SamuelCicuitStudio/LAN9645-STM32-Managed-Ethernet-Switch/Design/README.md

# Design Documentation Index

Documentation is split into two folders:

- `Design/hardware`: hardware pin/strap/wiring documentation.
- `Design/firmware`: firmware architecture, bring-up flow, LwIP, CLI, and runtime behavior.

## Hardware docs
- `Design/hardware/LAN9645_128pin_LAN_pin_assignment.md`

## Firmware docs
- `Design/firmware/LAN9645_managed_control_library_spec.md`
- `Design/firmware/LAN9645_library_implementation_plan.md`
- `Design/firmware/LAN9645_user_phy_driver_spec.md`
- `Design/firmware/STM32_library_api_dependency_contract.md`
- `Design/firmware/LAN9645_stm32_firmware_direction_hal_lwip.md`
- `Design/firmware/LAN9645_stm32_physical_comm_cli_plan.md`
- `Design/firmware/LAN9645_switch_config_and_ping_bringup.md`
- `Design/firmware/STM32_generated_code_ping_bringup_checklist.md`
- `Design/firmware/STM32H743_LwIP_activation_and_PHY_driver_choice.md`
- `Design/firmware/STM32_LwIP_general_settings_phase1.md`
- `Design/firmware/STM32_runtime_io_cli_logic_spec.md`
