SamuelCicuitStudio/LAN9645-STM32-Managed-Ethernet-Switch/Design/hardware/README.md

# Hardware Documentation

This folder contains board-level hardware documentation for the LAN9645 switch design.

## Files
- `LAN9645_128pin_LAN_pin_assignment.md`: LAN9645 128-pin mapping, straps, LEDs, and hardware connection rules.
