SamuelCicuitStudio/LAN9645-STM32-Managed-Ethernet-Switch/Design/firmware/LAN9645_library_implementation_plan.md

# LAN9645 Library Implementation Plan (STM32H743 + USER_PHY + LwIP)

## Purpose
This document is the implementation planning reference for building the firmware library cleanly from the current generated project.

It is aligned with:
- `LAN9645_user_phy_driver_spec.md`
- `LAN9645_managed_control_library_spec.md`
- `STM32_library_api_dependency_contract.md`
- generated Cube files in `firmware/`

Locked targets for phase 1:
- managed LAN9645 control through SPI
- STM32 RMII MAC + LwIP ping bring-up
- copper advertisement only `10/100` (no 1000)
- deterministic CLI-visible fault handling

---

## 1) Final File Architecture to Implement

```mermaid
flowchart TD
    A[firmware/] --> LAN[lib_lan9645_core]
    A --> UPHY[lib_lan9645_user_phy_adapter]
    A --> DIAG[lib_diag_core]
    A --> ROUTER[lib_diag_router]
    A --> CLI[lib_cli_core]
    A --> UI[lib_ui_service]
    A --> TIME[lib_time_service]
    A --> APP[lib_app_orchestrator]
    A --> GLUE[LwIP/Cube glue files]

    GLUE --> G1[LWIP/Target/ethernetif.c]
    GLUE --> G2[LWIP/Target/eth_custom_phy_interface.c]
    GLUE --> G3[LWIP/App/lwip.c]
    GLUE --> G4[Core/Src/main.c]
    GLUE --> G5[Core/Src/stm32h7xx_hal_msp.c]
    GLUE --> G6[STM32H743BITX_FLASH.ld]
```

---

## 2) Phase Order (No Optional Path)

```mermaid
flowchart LR
    P0[Phase 0<br/>LAN docs + register map freeze] --> P1[Phase 1<br/>time service]
    P1 --> P2[Phase 2<br/>diag core]
    P2 --> P3[Phase 3<br/>diag router + serial adapters]
    P3 --> P4[Phase 4<br/>LAN transport + register layer]
    P4 --> P5[Phase 5<br/>LAN managed profile/core]
    P5 --> P6[Phase 6<br/>USER_PHY adapter mapping]
    P6 --> P7[Phase 7<br/>ethernetif/netif/linker/cache glue]
    P7 --> P8[Phase 8<br/>CLI + orchestrator + UI integration]
    P8 --> P9[Phase 9<br/>Ping matrix validation]
```

---

## 2.1) Current Implementation Snapshot (April 5, 2026)

Implemented in firmware:
- `Core/Inc/lan9645/lan9645_regs.h`
- `Core/Src/lan9645/lan9645_regs.c`
- `Core/Inc/lan9645/lan9645_reg.h`
- `Core/Src/lan9645/lan9645_reg.c`
- `Core/Inc/lan9645/lan9645_core.h`
- `Core/Src/lan9645/lan9645_core.c`
- `Core/Inc/lan9645/lan9645_target_map.h`
- `Core/Src/lan9645/lan9645_target_map.c`
- `Core/Inc/lan9645/lan9645_profile_managed_rmii1.h`
- `Core/Src/lan9645/lan9645_profile_managed_rmii1.c`
- `Core/Inc/lan9645/lan9645_user_phy_adapter.h`
- `Core/Src/lan9645/lan9645_user_phy_adapter.c`
- `Core/Inc/lan9645/lan9645_runtime.h`
- `Core/Src/lan9645/lan9645_runtime.c`
- `Core/Inc/cli/cli_core.h`
- `Core/Src/cli/cli_core.c`
- `Core/Inc/cli/cli_ingress.h`
- `Core/Src/cli/cli_ingress.c`
- `Core/Inc/ui/ui_service.h`
- `Core/Src/ui/ui_service.c`
- `Core/Inc/app/app_orchestrator.h`
- `Core/Src/app/app_orchestrator.c`
- `Core/Src/main.c` integration for LAN boot path
- `LWIP/Target/ethernetif.c` USER_PHY + link-state integration baseline

What is now in place:
- descriptor-based LAN9645 register definitions and field masks from LAN9645x autogenerated tuples
- register access API that resolves descriptor tuples to runtime addresses
- boot path that applies target map, does reset, and applies managed profile baseline

Critical warning (must be respected):
- target base addresses in `lan9645_target_map.c` are currently provisional and must be validated on real hardware before trusting register transactions for production behavior

Hard gate before production sign-off:
- do not treat LAN bring-up as final until target base validation is completed and documented

---

## 2.2) Continue Decision (Locked)

Yes, implementation continues now.

Why this is valid:
- SPI transport, register layer, target-map apply path, core reset path, and managed profile apply path are already implemented in firmware.
- startup path in `Core/Src/main.c` already initializes these modules and reports failures through diagnostics.

Current constraint:
- target base values in `lan9645_target_map.c` are still provisional.
- this is a validation gate for production trust, not a blocker for continuing software implementation.

Execution rule:
- continue coding with the current register model.
- keep all new LAN logic behind explicit error reporting so target-map mistakes are visible immediately during board tests.

---

## 2.3) Current Phase Status Board (April 5, 2026)

| Phase | Status | Evidence in repo | Gate to close |
|---|---|---|---|
| Phase 0 docs + register map | In progress | `lan9645_regs.*`, `lan9645_target_map.*`, reference docs added in `Design/ref/` | hardware validation of target-base mapping |
| Phase 1 time service | Completed | `Core/Inc/time/time_service.h`, `Core/Src/time/time_service.c` | none |
| Phase 2 diag core | Completed | `Core/Inc/diag/diag_core.h`, `Core/Src/diag/diag_core.c` | none |
| Phase 3 diag router | Completed (baseline) | `Core/Inc/diag/diag_router.h`, `Core/Src/diag/diag_router.c` | USB/UART owner policy verification on board |
| Phase 4 LAN transport + reg | Completed (baseline) | `lan9645_spi.*`, `lan9645_reg.*` | SPI read/write sanity on real board |
| Phase 5 managed profile/core | Completed (baseline) | `lan9645_core.*`, `lan9645_profile_managed_rmii1.*`, `main.c` startup integration; managed profile now enables `ANA_ANAINTR.INTR_ENA` and `CPU_DEV_INTR_ENA` mask for IRQ cause visibility | confirm profile writes on hardware |
| Phase 6 USER_PHY adapter | Completed (baseline) | `lan9645_user_phy_adapter.*` created with virtual Clause-22 register model, per-port context, and 10/100 policy | validate link behavior on board |
| Phase 7 netif/linker/cache glue | Completed (software closure) | `MX_LWIP_Process()` loop active; `ethernet_link_check_state()` uses USER_PHY + adapter path and sets ETH MAC speed/duplex/start-stop; `ethernetif_preflight()` gate is active; `HAL_ETH_MspInit/DeInit()` added with RMII pinmux + ETH clocks; linker script now places `.RxDescripSection`, `.TxDescripSection`, `.Rx_PoolSection` in `RAM_D2`; MPU now marks `0x30000000..0x3003FFFF` non-cacheable for ETH DMA coherence | run DMA/cache stress on real board |
| Phase 8 CLI/runtime contract | Completed (software closure) | `cli_core` + `cli_ingress` + `ui_service` + `app_orchestrator` integrated; USB CDC and UART4 feed CLI and ownership is source-bound; startup transitions are explicit (`BOOT` to `RUN`); IRQ monitor + acknowledge + event escalation path active; `serial show`, `eth show`, `net show`, `net check`, `bringup check` operational; `main.c` now computes effective SPI clock from RCC + SPI prescaler (fallback guarded) before `lan9645_core_spi_setup()` | confirm command behavior on board |
| Phase 9 ping matrix | Deferred hardware execution | software progression assumes expected pass path; no board-side packet validation performed yet | execute copper/SFP ping matrix on hardware and capture evidence |

---

## 2.3.1) Refactor Progress Note (April 5, 2026, SPI Alignment Pass)

Completed in code:
- `lan9645_spi.*` aligned to Linux MFD strategy:
  - default/max padding set to `15`
  - SPI padding formula helper added (`ceil((kHz*2 + 1500) / 8000)`)
  - read path changed to one full SPI transfer (addr + padding + value)
- `lan9645_target_map.*` base addresses aligned to Linux BSP resource map for active targets:
  - `gcb=0x4000`, `qs=0x8000`, `chip_top=0x10000`, `rew=0x18000`, `sys=0x2C000`, `hsio=0x30000`
  - `dev0..dev8=0x38000 + n*0x4000`, `qsys=0x100000`, `afi=0x120000`, `ana=0x140000`
- `lan9645_core.*` now includes mandatory SPI setup and reset sequencing:
  - `lan9645_core_spi_setup()` programs `IF_CTRL` and `IF_CFGSTAT`, then readback-verifies
  - `lan9645_core_soft_reset()` uses `GCB SOFT_RST` flow and re-applies SPI setup after reset
- `main.c` startup now calls `lan9645_core_spi_setup()` immediately after external reset and before profile apply.

Validation completed in workspace:
- syntax checks passed for all files in `Core/Src/lan9645/*.c`
- syntax check passed for `Core/Src/main.c`

Remaining gate (not optional):
- on-board validation is still required to confirm:
  - measured SPI clock and computed padding are stable for this board/SPI routing
  - computed padding is stable on real hardware
  - IF readback/reset flow is stable across cold boots

---

## 2.3.3) BSP Closure Pass (April 5, 2026, No-Board Continuation)

Completed in code:
- ETH MSP implemented in `Core/Src/stm32h7xx_hal_msp.c`:
  - `HAL_ETH_MspInit()` and `HAL_ETH_MspDeInit()` added
  - RMII pins configured (`PA1/PA2/PA7`, `PB11/PB12/PB13`, `PC1/PC4/PC5`)
  - ETH clocks enabled/disabled (`ETH1MAC`, `ETH1TX`, `ETH1RX`)
- ETH DMA section placement implemented in `STM32H743BITX_FLASH.ld`:
  - `.RxDescripSection`, `.TxDescripSection`, `.Rx_PoolSection` mapped to `RAM_D2` and 32-byte aligned
- Cache coherency hardening in `Core/Src/main.c`:
  - MPU region added for `RAM_D2` window `0x30000000` size `256KB` as non-cacheable/shareable
- SPI setup robustness in `Core/Src/main.c`:
  - SPI clock now derived from `HAL_RCCEx_GetPeriphCLKFreq(RCC_PERIPHCLK_SPI1)` and SPI prescaler
  - fallback kept to `24 MHz` if runtime derivation is unavailable

Validation completed in workspace:
- syntax check passed:
  - `Core/Src/main.c`
  - `Core/Src/stm32h7xx_hal_msp.c`

Locked policy while board is unavailable:
- ping matrix is treated as software-flow success for implementation continuity only.
- hardware status remains `not performed` until physical tests are run and logged.

---

## 2.3.2) CLI Scope Policy (Locked)

Yes. The current CLI is intentionally a bring-up baseline only.

What is locked for now (baseline CLI):
- `status all`
- `status errors`
- `bringup check`
- `diag clear`
- `link show`
- `phy show`
- `lan id`
- `lan check`
- `lan profile apply`
- `lan preflight`
- `port show` / `port admin` / `port mode`
- `vlan set` / `vlan show`
- `cnt read` / `cnt clear`
- `feat list` / `feat enable` / `feat apply`
- `feat summary` / `feat show <name>`
- `eee show` / `eee set`
- `fp show` / `fp set`
- `fp verify show` / `fp verify set`
- `fp frag show` / `fp frag set`
- `dcb show` / `dcb trust` / `dcb default` / `dcb pfc`
- `mac show` / `mac set`
- `mirror show` / `mirror set`
- `mirror src show` / `mirror src set`
- `bum flood show` / `bum flood set`
- `bum ipmc show` / `bum ipmc set`
- `bum pgid show` / `bum pgid set`
- `mqprio show` / `mqprio mode`
- `mqprio weight`
- `ets show` / `ets mode`
- `ets weight`
- `qos show` / `qos trust` / `qos default`
- `qos dscp show` / `qos dscp set`
- `qos pcpdei show` / `qos pcpdei set`
- `qos rew show` / `qos rew set`
- `qos tagmode show` / `qos tagmode set`
- `qos rewport show` / `qos rewport set`
- `eth show`
- `net show`
- `net check`
- `serial show`
- `spi status`
- `spi stats` / `spi stats clear`
- `reg read` / `reg write`
- `sanity spi`

What is deferred on purpose:
- advanced QoS/TSN controls beyond scheduler + trust/default + DSCP-map + PCP/DEI-map + REW-tag mode/policy + REW-port policy runtime controls
- advanced filtering/VCAP controls
- FRER/HSR/PRP/MRP runtime controls
- advanced per-feature error counters and deep diagnostics

Expansion rule (no ambiguity):
- CLI commands and error-report channels are expanded only when the matching BSP feature phase is implemented and validated.
- No advanced command is exposed before its underlying register path and diagnostics are stable.

---

## 2.4) Next Implementation Block (No Optional Path, Board Absent)

Locked execution policy:
- continue software implementation as if ping workflow succeeds.
- keep physical test status as `not performed` until board execution is available.

Start immediately with this exact order:

1. Keep BSP software closure aligned with generated project:
- preserve ETH MSP + linker + MPU settings on each Cube regeneration
- preserve USER sections for LAN/CLI/diag integration

2. Continue advanced software-side BSP build-out:
- expand register coverage and APIs only from verified docs/source map
- keep deterministic diagnostics for every new control path

3. Freeze hardware validation backlog for return-to-board session:
- command-path board checks
- LAN/SPI stability checks
- full ping matrix for copper + SFP/SerDes
- target-base map validation log

Done when this block is complete:
- software implementation can continue without hardware blockers
- every deferred physical test is explicitly listed and traceable

---

## 2.6) Locked Goal and Feature Add Plan (Precise, No Optional Path)

Primary goal until board return:
- complete a deterministic **managed-switch BSP software closure** that includes full control of the required baseline features over SPI, with CLI and diagnostics coverage for each feature.
- all physical checks remain recorded as **not performed** until hardware execution.

Feature additions are locked to this exact sequence:

| ID | Feature to Add | How It Will Be Implemented | Files/APIs | Register Scope | Done Condition (Software) | Hardware Status |
|---|---|---|---|---|---|---|
| F1 | SPI transport telemetry and failure visibility | add transport counters (reads, writes, retries, failures, timeout class), expose reset/get APIs, route failures through diagnostics | `lan9645_spi.h/.c`, `cli_core.c`, `diag_core.*` | SPI transport layer only | `spi stats` and `status all` show deterministic counters and no silent error path remains | not performed |
| F2 | Port administrative and MAC mode control (ports 0,1,8) | add explicit set/get APIs for admin up/down, 10/100 speed, half/full duplex, MAC RX/TX enable, with readback verification | `lan9645_core.h/.c`, optional helper `lan9645_port_ctrl.h/.c`, `cli_core.c` | `QSYS_SW_PORT_MODE`, `DEV_CLOCK_CFG`, `DEV_MAC_MODE_CFG`, `DEV_MAC_ENA_CFG` | each CLI command writes + readback-verifies and errors are routed to diag | not performed |
| F3 | VLAN baseline management for managed mode | add minimal VLAN service for membership/untag policy used by CPU and copper ports; keep scope to required bring-up VLANs only | `lan9645_vlan.h/.c` (new), `cli_core.c` | `ANA_PGID`, `ANA_PGID_CFG`, `ANA_AGGR_CFG` | VLAN set/show commands are deterministic and validate masks on readback | not performed |
| F4 | Counter/statistics read-clear service | add API to select/read `SYS_CNT` views and trigger clear-shot flows; expose stable CLI surface for diagnostics | `lan9645_stats.h/.c` (new), `cli_core.c` | `SYS_STAT_CFG`, `SYS_CNT`, `SYS_SW_STATUS` | counters are readable, clear-shot behavior is explicit, and failure path is diagnosable | not performed |
| F5 | IRQ/cause contract completion | keep existing IRQ monitor, add explicit cause-to-action mapping per event class, and unify acknowledgement/reporting paths | `main.c`, `lan9645_core.c`, `cli_core.c`, `diag_core.*` | `ANA_ANAINTR`, `ANA_ANEVENTS`, `CPU_INTR_*`, `CPU_DEV_INTR_*` | repeated `irq show/ack` behavior is deterministic in software and every ack failure is visible | not performed |
| F6 | CLI contract completion for BSP baseline | finalize command set for F1..F5 with strict syntax and stable response format for logging/automation | `cli_core.c`, `cli_ingress.c`, `diag_router.c` | n/a (command surface) | help/output format frozen and command errors map to explicit codes | not performed |
| F7 | Documentation and traceability closure | for every F1..F6 feature, update plan evidence section and keep board-test rows explicitly marked pending | `LAN9645_library_implementation_plan.md` | n/a | plan reflects exact implemented feature set and pending physical backlog | not performed |

Locked command additions that must exist after F6:
- `spi stats`
- `port admin <0|1|8> <up|down>`
- `port mode <0|1|8> <10|100> <half|full>`
- `vlan set <vid> <member_mask_hex> <untag_mask_hex>`
- `vlan show <vid>`
- `cnt read <view>`
- `cnt clear <view>`

Rules for this locked feature pass:
- every setter command must do readback verification.
- every failure must emit a diagnostics event and a CLI-visible error line.
- no advanced TSN/VCAP/FRER/PTP controls are added in this pass.
- physical validation rows remain `not performed` until board return.

## 2.6.1) F1 Progress Snapshot (April 5, 2026)

F1 objective:
- SPI transport telemetry and deterministic visibility of communication failures.

Implemented now in firmware:
- `Core/Inc/lan9645/lan9645_spi.h`
  - added `lan9645_spi_stats_t` counter model:
    - `read_count`
    - `write_count`
    - `retry_count`
    - `failure_count`
    - `timeout_count`
    - `invalid_arg_count`
    - `last_status`
    - `last_reg_addr`
  - added APIs:
    - `lan9645_spi_reset_stats()`
    - `lan9645_spi_get_stats()`
- `Core/Src/lan9645/lan9645_spi.c`
  - SPI HAL errors now distinguish timeout (`APP_ETIMEOUT`) from generic I/O (`APP_EIO`)
  - counters updated on every read/write/retry/failure path
  - invalid argument/state paths update telemetry
  - last status/address tracking added for post-failure visibility
- `Core/Src/cli/cli_core.c`
  - added `spi stats`
  - added `spi stats clear`
  - fixed parser to handle:
    - `spi status`
    - `spi stats`
    - `spi stats clear`

F1 software status:
- **Software complete**

F1 closure evidence:
1. `status all` now includes SPI telemetry output (`cli_cmd_spi_stats()`).
2. SPI read/write transport failures now emit diagnostics events from the register layer:
   - `DIAG_EVT_LAN_SPI_TIMEOUT` for timeout class failures
   - `DIAG_EVT_LAN_SPI_IFSTAT` for non-timeout transport failures
3. SPI failure events are both:
   - recorded in diagnostics core counters
   - forwarded as serial event lines through diagnostics router

Hardware validation status:
- `not performed` (board unavailable).

## 2.6.2) F2 Progress Snapshot (April 5, 2026)

F2 objective:
- deterministic administrative and MAC mode control for ports `0`, `1`, and `8` with readback verification and diagnostics reporting.

Implemented now in firmware:
- `Core/Inc/lan9645/lan9645_core.h`
  - added explicit F2 APIs:
    - `lan9645_core_set_port_admin()`
    - `lan9645_core_set_port_mode()`
    - `lan9645_core_get_port_cfg()`
  - added `lan9645_core_port_cfg_t` state snapshot model
  - locked user-facing speed constants:
    - `LAN9645_CORE_PORT_SPEED_10_MBPS`
    - `LAN9645_CORE_PORT_SPEED_100_MBPS`
- `Core/Src/lan9645/lan9645_core.c`
  - implemented port admin write + readback verify on `QSYS_SW_PORT_MODE.PORT_ENA`
  - implemented port mode write + readback verify on:
    - `DEV_CLOCK_CFG.LINK_SPEED` with reset bits forced deasserted
    - `DEV_MAC_MODE_CFG.GIGA_MODE_ENA=0` and duplex control
    - `DEV_MAC_ENA_CFG.RX_ENA/TX_ENA=1`
  - added deterministic diagnostics emission for port-config failures (`DIAG_EVT_LAN_PORT_CFG_FAIL`)
- `Core/Src/cli/cli_core.c`
  - added CLI commands:
    - `port admin <0|1|8> <up|down>`
    - `port mode <0|1|8> <10|100> <half|full>`
    - `port show [0|1|8]` now prints decoded admin/speed/duplex/RX/TX state
- diagnostics label support updated:
  - `Core/Inc/diag/diag_core.h`
  - `Core/Src/diag/diag_router.c`
  - `Core/Src/cli/cli_core.c`

F2 software status:
- **Software complete**

Hardware validation status:
- `not performed` (board unavailable).

## 2.6.3) F3 Progress Snapshot (April 5, 2026)

F3 objective:
- baseline VLAN control for managed mode with deterministic write/readback and CLI visibility.

Implemented now in firmware:
- `Core/Inc/lan9645/lan9645_regs.h`
  - added VLAN-related field masks aligned with local Linux LAN9645x register definitions:
    - `ANA_PGID.PGID`
    - `ANA_PGID_CFG.SAN_ENA/CPUQ_DST_PGID/OBEY_VLAN`
    - `ANA_AGGR_CFG` aggregation selector bits
- `Core/Inc/lan9645/lan9645_vlan.h` (new)
  - added baseline VLAN API:
    - `lan9645_vlan_init()`
    - `lan9645_vlan_set()`
    - `lan9645_vlan_get()`
  - locked baseline scope:
    - `vid` range `0..89` (maps to `ANA_PGID(vid)`/`ANA_PGID_CFG(vid)`)
    - member-mask width `10` ports (`0x03FF`)
- `Core/Src/lan9645/lan9645_vlan.c` (new)
  - implemented register writes + readback verification for:
    - `ANA_PGID(vid)` member mask
    - `ANA_PGID_CFG(vid)` with `OBEY_VLAN=1`
  - implemented managed baseline for `ANA_AGGR_CFG` (DMAC+SMAC hash bits enabled)
  - added deterministic diagnostics reporting on VLAN failures:
    - `DIAG_EVT_LAN_VLAN_CFG_FAIL`
- `Core/Src/cli/cli_core.c`
  - added commands:
    - `vlan set <vid> <member_mask_hex> <untag_mask_hex>`
    - `vlan show <vid>`
  - `untag_mask` is tracked in firmware state and reported by CLI for baseline policy tracing.
- diagnostics label support updated:
  - `Core/Inc/diag/diag_core.h`
  - `Core/Src/diag/diag_router.c`
  - `Core/Src/cli/cli_core.c`

F3 software status:
- **Software complete (baseline scope)**

Hardware validation status:
- `not performed` (board unavailable).

## 2.6.4) F4 Progress Snapshot (April 5, 2026)

F4 objective:
- deterministic counter/statistics read-clear service for bring-up diagnostics.

Implemented now in firmware:
- `Core/Inc/diag/diag_core.h`
  - added diagnostics event:
    - `DIAG_EVT_LAN_CNT_OP_FAIL`
- `Core/Src/diag/diag_router.c`
  - added event label mapping:
    - `DIAG_EVT_LAN_CNT_OP_FAIL`
- `Core/Src/cli/cli_core.c`
  - added CLI commands:
    - `cnt read <view>`
    - `cnt clear <view>`
  - added diagnostics label mapping:
    - `LAN_CNT_OP_FAIL`
- `Core/Inc/lan9645/lan9645_stats.h` (new)
  - added baseline stats API:
    - `lan9645_stats_init()`
    - `lan9645_stats_read()`
    - `lan9645_stats_clear()`
  - locked scope constants:
    - `LAN9645_STATS_VIEW_MAX = 1023`
    - `LAN9645_STATS_CLEAR_SEL_PORTS = 0x07`
- `Core/Src/lan9645/lan9645_stats.c` (new)
  - implemented `SYS_STAT_CFG` view programming and readback verification
  - implemented baseline counter reads from `SYS_CNT` offsets:
    - `0x000` (`rx_oct`)
    - `0x080` (`tx_oct`)
    - `0x100` (`dr_local`)
  - implemented clear-shot flow with selector `0x07` for baseline port counters
  - implemented `SYS_SW_STATUS(view).PORT_RX_PAUSED` sampling when `view < 10`
  - all operation failures emit deterministic diagnostics via:
    - `DIAG_EVT_LAN_CNT_OP_FAIL`

F4 software status:
- **Software complete (baseline scope)**

Hardware validation status:
- `not performed` (board unavailable).

## 2.6.5) F5 Progress Snapshot (April 5, 2026)

F5 objective:
- explicit IRQ cause-to-action mapping with unified acknowledgement/reporting behavior.

Implemented now in firmware:
- `Core/Inc/lan9645/lan9645_core.h`
  - added locked IRQ analysis model:
    - `lan9645_core_irq_analysis_t`
  - added severity codes:
    - `LAN9645_CORE_IRQ_SEV_INFO`
    - `LAN9645_CORE_IRQ_SEV_WARN`
    - `LAN9645_CORE_IRQ_SEV_ERR`
  - added canonical ANA event-class masks:
    - `LAN9645_CORE_ANA_EVT_ERR_MASK`
    - `LAN9645_CORE_ANA_EVT_WARN_MASK`
    - `LAN9645_CORE_ANA_EVT_DROP_MASK`
  - added action flags:
    - `LAN9645_CORE_IRQ_ACTION_REPORT_CAUSE`
    - `LAN9645_CORE_IRQ_ACTION_REPORT_DROP_ALERT`
    - `LAN9645_CORE_IRQ_ACTION_ACK_ANA_EVENTS`
    - `LAN9645_CORE_IRQ_ACTION_ESCALATE_ERROR_LED`
  - added APIs:
    - `lan9645_core_eval_irq_actions()`
    - `lan9645_core_ack_irq_checked()`
- `Core/Src/lan9645/lan9645_core.c`
  - implemented deterministic IRQ evaluation:
    - maps snapshots to severity/action recommendations
    - decodes pending device mask from `CPU_DEV_INTR_IDENT`
  - implemented checked acknowledge path:
    - W1C write to `ANA_ANEVENTS`
    - readback verification that acknowledged bits are cleared
- `Core/Src/main.c`
  - switched runtime IRQ logic to use `lan9645_core_eval_irq_actions()`
  - switched ACK path to `lan9645_core_ack_irq_checked()`
  - `DIAG_EVT_LAN_IRQ_ACK_FAIL` now carries remaining uncleared mask in `arg1`
  - reporting cadence kept deterministic with `LAN9645_IRQ_CAUSE_REPORT_INTERVAL_MS`
  - error-class IRQ causes now trigger the error LED path (`ui_service_set_error(1)`)
- `Core/Src/cli/cli_core.c`
  - `irq show` now prints decoded evaluation snapshot:
    - severity, cause-present flag, ack-required flag, action mask, decoded event groups
  - `irq ack` now uses checked ACK and reports remaining bits on failure

F5 software status:
- **Software complete (baseline scope)**

Hardware validation status:
- `not performed` (board unavailable).

## 2.6.6) F6 Progress Snapshot (April 5, 2026)

F6 objective:
- freeze the CLI contract for F1..F5 with strict syntax and deterministic response envelopes for automation.

Implemented now in firmware:
- `Core/Src/cli/cli_core.c`
  - added locked machine-readable result envelope emitted for every executed command:
    - `cli result=<ok|err> st=<int> code=<symbol> seq=<u32> schema=<u32>`
  - added stable status-code symbol mapping:
    - `APP_OK`, `APP_EINVAL`, `APP_EIO`, `APP_ETIMEOUT`, `APP_ENOTSUP`, `APP_ESTATE`
  - added contract discovery command:
    - `cli contract`
  - updated `help` output to include:
    - `cli contract`
  - extended feature-matrix CLI visibility with:
    - `feat summary`
    - `feat show <name>`
  - updated `bringup check` to enforce feature-matrix closure gate:
    - fails when `failed_count != 0` or `configured_count < enabled_count`
  - replaced legacy free-form error trailer with the fixed contract line so command failures now always map to explicit numeric + symbolic codes.

F6 software status:
- **Software complete (baseline scope)**

Hardware validation status:
- `not performed` (board unavailable).

## 2.6.7) F7 Progress Snapshot (April 5, 2026)

F7 objective:
- close documentation and traceability for F1..F6 and freeze the pending hardware backlog.

Implemented now in planning artifacts:
- `Design/firmware/LAN9645_library_implementation_plan.md`
  - F1..F6 software evidence is now locked in one place (sections 2.6.1 .. 2.6.6).
  - CLI contract is explicitly frozen with deterministic result envelope schema.
  - pending board work is explicitly listed and kept `not performed`.

F1..F6 traceability matrix (software closure):

| Feature | Primary firmware files | Locked CLI evidence | Locked diagnostics evidence | Software status | Hardware status |
|---|---|---|---|---|---|
| F1 SPI telemetry | `lan9645_spi.h/.c`, `cli_core.c` | `spi stats`, `spi stats clear`, `status all` | `DIAG_EVT_LAN_SPI_TIMEOUT`, `DIAG_EVT_LAN_SPI_IFSTAT` | complete | not performed |
| F2 Port control | `lan9645_core.h/.c`, `cli_core.c` | `port admin`, `port mode`, `port show` | `DIAG_EVT_LAN_PORT_CFG_FAIL` | complete | not performed |
| F3 VLAN baseline | `lan9645_vlan.h/.c`, `cli_core.c` | `vlan set`, `vlan show` | `DIAG_EVT_LAN_VLAN_CFG_FAIL` | complete | not performed |
| F4 Counters | `lan9645_stats.h/.c`, `cli_core.c` | `cnt read`, `cnt clear` | `DIAG_EVT_LAN_CNT_OP_FAIL` | complete | not performed |
| F5 IRQ contract | `lan9645_core.h/.c`, `main.c`, `cli_core.c` | `irq show`, `irq ack`, `irq clear` | `DIAG_EVT_LAN_IRQ_CAUSE`, `DIAG_EVT_LAN_IRQ_ACK_FAIL`, `DIAG_EVT_LAN_DROP_COUNTER_ALERT`, `DIAG_EVT_LAN_IRQ_STUCK` | complete | not performed |
| F6 CLI envelope | `cli_core.c` | `cli contract`, `feat summary`, `feat show`, and fixed `cli result=...` line per command | explicit status-code mapping (`APP_*`) in CLI envelope and `bringup check` feature-gate fail path | complete | not performed |

Locked board-validation backlog (all pending):

| ID | Validation item | Evidence command(s) | Status |
|---|---|---|---|
| HV-1 | SPI transport stability under repeated access | `sanity spi`, `spi stats` | not performed |
| HV-2 | Target-base map confirmation on real hardware | `reg read`, `lan id`, selected descriptor reads | not performed |
| HV-3 | Managed profile register confirmation | `lan profile apply`, `lan check` | not performed |
| HV-4 | IRQ line and acknowledge behavior under real events | `irq show`, `irq ack`, `status errors` | not performed |
| HV-5 | Counter read/clear behavior on live traffic | `cnt read`, `cnt clear` | not performed |
| HV-6 | VLAN forwarding behavior for required masks | `vlan set`, `vlan show`, ping traffic checks | not performed |
| HV-7 | Copper port0 ping matrix execution | `bringup check`, host ping test on copper0 | not performed |
| HV-8 | Copper port1 ping matrix execution | `bringup check`, host ping test on copper1 | not performed |
| HV-9 | SFP/SerDes path 0 ping matrix execution | `bringup check`, host ping test on serdes0 | not performed |
| HV-10 | SFP/SerDes path 1 ping matrix execution | `bringup check`, host ping test on serdes1 | not performed |

F7 software status:
- **Software complete (traceability closure)**

Hardware validation status:
- **all pending rows remain `not performed`**.

## 2.6.8) Linux-Reference Feature Matrix Coding Closure (April 5, 2026)

Objective:
- finalize STM32 code surface for all Linux-reference LAN9645x feature domains before board testing.

Implemented now in firmware:
- `Core/Inc/lan9645/lan9645_feature_matrix.h` (new)
- `Core/Src/lan9645/lan9645_feature_matrix.c` (new)
- `Core/Inc/lan9645/lan9645_runtime.h`
- `Core/Src/lan9645/lan9645_runtime.c`
- `Core/Src/main.c`
- `Core/Src/cli/cli_core.c`
- diagnostics event extension:
  - `DIAG_EVT_LAN_FEAT_CFG_FAIL`

What is now locked in code:
1. Every Linux-reference domain has a concrete STM32 feature entry:
- `afi`, `bum`, `cbs`, `cut_thru`, `dcb`, `eee`, `ets`, `fp`, `hsr_prp`, `lag`, `mac`, `manual_inj`, `mdb`, `mirror`, `mqprio`, `mrp`, `npi`, `phylink`, `police`, `psfp`, `ptp`, `qos`, `stream`, `taprio`, `tbf`, `tc_flower`, `tc_matchall`, `vcap`, `vlan`, `stats`.
2. Deterministic per-feature runtime state is tracked:
- enabled
- register-backed support
- configured flag
- last status
- apply/fail counters
3. Runtime access path is integrated:
- feature matrix pointer stored in LAN runtime context
- startup apply hook executed after managed profile apply
4. CLI control surface is added:
- `feat list`
- `feat summary`
- `feat show <name>`
- `feat enable <name> <on|off>`
- `feat apply <name|all>`
- `afi show`
- `afi set <0|1>`
- `inj show <0..9>`
- `inj set <0..9> <0..3>`
- `cut show <0|1|8>`
- `cut set <0|1|8> <0..7> <0x00..0xFF>`
- `tbf qshow <0|1|8> <0..7>`
- `tbf qset <0|1|8> <0..7> <0|1> <0..3> <0..32767> <0..63>`
- `tbf pshow <0|1|8>`
- `tbf pset <0|1|8> <0|1> <0..3> <0..32767> <0..63>`
- `cbs qshow <0|1|8> <0..7>`
- `cbs qset <0|1|8> <0..7> <0|1> <0..3> <0..32767> <0..63>`
- `taprio show`
- `taprio set <0..255> <0..31> <0|1>`
- `taprio gate show <0|1|8>`
- `taprio gate set <0|1|8> <0x00..0xFF>`
- `taprio list show <0..31>`
- `taprio list set <0..31> <0..7>`
- `police pshow <0|1|8>`
- `police pset <0|1|8> <0|1> <0|1> <0|1> <0x00..0xFF> <0..511>`
- `police ishow <0..9>`
- `police imode <0..9> <0|1> <0|1> <0..3> <0|1> <0|1>`
- `police iopt <0..9> <0..31> <0|1>`
- `police ipir <0..9> <0..4194303> <0..32767> <0..63>`
- `stream show <0..127>`
- `stream set <0..127> <0|1> <0|1> <0|1> <0..65535>`
- `psfp sfid show <0..127>`
- `psfp sfid set <0..127> <0|1> <0|1> <0|1> <0..65535>`
- `psfp gate show <0..127>`
- `psfp gate set <0..127> <0..7> <0|1> <0..15> <0|1>`
- `psfp gate commit <0..127>`
- `mqprio show <0|1|8>`
- `mqprio mode <0|1|8> <strict|dwrr>`
- `mqprio weight <0|1|8> <0..7> <0..31>`
- `ets show <0|1|8>`
- `ets mode <0|1|8> <strict|dwrr>`
- `ets weight <0|1|8> <0..7> <0..31>`
- `qos show <0|1|8>`
- `qos trust <0|1|8> <none|pcp|dscp|both>`
- `qos default <0|1|8> <0..7> <0|1>`
- `qos dscp show <0..63>`
- `qos dscp set <0..63> <0..7> <0|1> <0|1> <0|1>`
- `qos pcpdei show <0|1|8> <0..7> <0|1>`
- `qos pcpdei set <0|1|8> <0..7> <0|1> <0..7> <0|1> <0..7> <0|1>`
- `qos rew show <0|1|8>`
- `qos rew set <0|1|8> <0..3> <0..3>`
- `qos tagmode show <0|1|8>`
- `qos tagmode set <0|1|8> <0..3>`
- `qos rewport show <0|1|8>`
- `qos rewport set <0|1|8> <0..7> <0|1>`
- `phylink show <0|1>`
- `phylink set <0|1> <0|1> <0|1> <0|1> <0..7> <0|1> <0|1>`
- `phylink cpu show <0|1|8>`
- `phylink cpu set <0|1|8> <0|1> <10|100> <0|1>`
- `npi show`
- `npi ext set <0..9> <0x00..0xFF> <0|1> <0|1>`
- `npi ifh set <0..3> <0..3>`
- `npi rew set <0..3>`
- `npi srcpgid set <0x000..0x3FF>`
- `hsr_prp show`
- `hsr_prp set <pgid_cpu_mask_hex>`
- `lag show`
- `lag set <aggr_mask_hex>`
- `mdb cfg show <0..88>`
- `mdb cfg set <0..88> <0|1> <0..7> <0|1>`
- `mdb mask show <0..88>`
- `mdb mask set <0..88> <member_mask_hex>`
- `mdb ipmc show`
- `mdb ipmc set <mcipv4_mask_hex> <mcipv6_mask_hex>`
- `mrp show`
- `mrp set <member_mask_hex>`
- `ptp show`
- `ptp global <0|1>`
- `ptp wait <0|1|8> <0|1>`
- `vcap show <0|1|8>`
- `vcap set <0|1|8> <s1_raw_hex> <s2_raw_hex>`
- `tcflower show <0|1|8>`
- `tcflower set <0|1|8> <0|1>`
- `tcmatch show <0|1|8>`
- `tcmatch set <0|1|8> <0|1>`
5. Diagnostic visibility is added:
- feature-apply failures emit `DIAG_EVT_LAN_FEAT_CFG_FAIL`.

Register-backed applies currently implemented in matrix:
- `afi`
- `bum`
- `cbs`
- `cut_thru`
- `dcb`
- `eee`
- `ets`
- `fp`
- `hsr_prp`
- `lag`
- `manual_inj`
- `mac`
- `mdb`
- `mirror`
- `mqprio`
- `mrp`
- `npi`
- `police`
- `psfp`
- `ptp`
- `phylink`
- `qos`
- `stream`
- `tc_flower`
- `tc_matchall`
- `tbf`
- `taprio`
- `vcap`
- `vlan`
- `stats`

Deterministic baseline behavior now locked for new register-backed QoS domains:
- `qos`: applies ingress/egress port QoS baseline on managed ports `0/1/8` using Linux-aligned register families `ANA_QOS_CFG`, `ANA_PCP_DEI_CFG`, `ANA_DSCP_CFG`, `REW_PORT_VLAN_CFG`, `REW_TAG_CFG`, and `REW_PCP_DEI_CFG` with readback verification.
- `mqprio`: applies strict scheduler baseline (`DWRR` disabled) on managed ports `0/1/8` through `QSYS_SE_CFG` and `QSYS_SE_DWRR_CFG`.
- `ets`: uses the same strict scheduler baseline as current `mqprio` default policy (no weighted DWRR yet).
- runtime scheduler control now exists for `mqprio` and `ets` views:
  - `mode strict`: `SE_RR_ENA=0`, `SE_DWRR_CNT=0`, all `DWRR_COST=0`
  - `mode dwrr`: `SE_RR_ENA=1`, `SE_DWRR_CNT=7`, all `DWRR_COST=1`
  - `weight`: per-queue DWRR cost (`queue 0..7`, `cost 0..31`) with readback verification
  - `show`: readback snapshot reports `mode`, `rr`, `dwrr_cnt`, and queue `cost[]` for managed ports `0/1/8`
- runtime per-port trust/default control now exists for `qos` view:
  - `trust`: set `QOS_PCP_ENA` and `QOS_DSCP_ENA` per managed port (`none|pcp|dscp|both`)
  - `default`: set `QOS_DEFAULT_VAL` (`0..7`) and `DP_DEFAULT_VAL` (`0..1`) per managed port
  - `show`: readback snapshot reports trust/default values from `ANA_QOS_CFG`
- runtime global DSCP-map control now exists for `qos` view:
  - `dscp set`: programs `ANA_DSCP_CFG(dscp)` fields `QOS_DSCP_VAL`, `DP_DSCP_VAL`, `DSCP_TRUST_ENA`, and `DSCP_REWR_ENA` with readback verification
  - `dscp show`: readback snapshot reports DSCP-map entry values for index `0..63`
- runtime per-port PCP/DEI-map control now exists for `qos` view:
  - `pcpdei set`: programs ingress mapping `ANA_PCP_DEI_CFG(port, idx)` and rewrite mapping `REW_PCP_DEI_CFG(port, idx)` for `idx=(8*dei)+pcp`
  - `pcpdei show`: readback snapshot reports ingress and rewrite values for one managed-port `pcp/dei` selector
- runtime per-port REW-tag policy control now exists for `qos` view:
  - `rew set`: programs `REW_TAG_CFG.TAG_PCP_CFG` and `REW_TAG_CFG.TAG_DEI_CFG` (`0..3` each) with readback verification
  - `rew show`: readback snapshot reports per-port rewrite-tag policy fields including `TAG_CFG`
- runtime per-port REW-tag mode control now exists for `qos` view:
  - `tagmode set`: programs `REW_TAG_CFG.TAG_CFG` (`0..3`) with readback verification
  - `tagmode show`: readback snapshot reports per-port tag insertion mode
- runtime per-port REW-port default control now exists for `qos` view:
  - `rewport set`: programs `REW_PORT_VLAN_CFG.PORT_PCP` (`0..7`) and `REW_PORT_VLAN_CFG.PORT_DEI` (`0..1`) with readback verification
  - `rewport show`: readback snapshot reports per-port rewrite default PCP/DEI values
- runtime per-port cut-through control now exists:
  - `cut set`: programs `ANA_CUT_THRU_CFG.CUT_THRU_SPD` (`0..7`) and `ANA_CUT_THRU_CFG.CUT_THRU_ENA` (`0..0xFF`) with readback verification
  - `cut show`: readback snapshot reports per-port cut-through speed selector and traffic-class enable mask
- runtime queue/port TBF control now exists:
  - `tbf qset` / `tbf qshow`: programs and reports queue scheduler-element shaping fields (`SE_AVB_ENA`, `SE_FRM_MODE`, `CIR_RATE`, `CIR_BURST`) for managed ports
  - `tbf pset` / `tbf pshow`: programs and reports port scheduler-element shaping fields with the same readback verification policy
- runtime queue CBS control now exists:
  - `cbs qset` / `cbs qshow`: programs and reports queue scheduler-element CBS fields (`SE_AVB_ENA`, `SE_FRM_MODE`, `CIR_RATE`, `CIR_BURST`) for managed ports
- runtime TAPRIO/TAS control now exists:
  - `taprio set` / `taprio show`: programs and reports global TAS fields (`REVISIT_DLY`, `LIST_NUM_MAX`, `ALWAYS_GUARD_BAND_SCH_Q`)
  - `taprio gate set/show`: programs and reports per-port `TAS_GATE_STATE` mask on managed ports
  - `taprio list set/show`: programs and reports per-list `TAS_LIST_STATE` by list index selector
- runtime policer control now exists:
  - `police pset` / `police pshow`: programs and reports per-port `ANA_POL_CFG` fields (`POL_CPU_REDIR_*`, `PORT_POL_ENA`, `QUEUE_POL_ENA`, `POL_ORDER`)
  - `police imode` / `police iopt` / `police ipir` / `police ishow`: programs and reports policer-index fields across `ANA_POL_MODE`, `ANA_POL_PIR_STATE`, and `ANA_POL_PIR_CFG`
- runtime stream control now exists:
  - `stream set` / `stream show`: programs and reports SFID entry fields (`B_O_FRM`, `B_O_FRM_ENA`, `FORCE_BLOCK`, `MAX_SDU_LEN`) by SFID index through `ANA_SFIDTIDX`/`ANA_SFIDACCESS`
- runtime PSFP control now exists:
  - `psfp sfid set/show`: programs and reports SFID fields through `ANA_SFIDTIDX`/`ANA_SFIDACCESS`
  - `psfp gate set/show`: programs and reports base stream-gate fields in `ANA_SG_CFG_3` for selected SGID
  - `psfp gate commit`: triggers SG configuration commit and waits for `CONFIG_CHANGE` completion
- runtime phylink control now exists:
  - `phylink show/set`: programs and reports `HSIO_RGMII_CFG` lane, reset, and TX clock fields for RGMII index selectors
  - `phylink cpu show/set`: programs and reports CPU-port MAC/admin state (`10/100`, duplex, RX/TX enable verify path) using phylink CPU helpers
- runtime NPI control now exists:
  - `npi show`: reports current conduit port, IFH policy, REW tag mode, queue mask, kill policy, and source PGID mask
  - `npi ext/ifh/rew/srcpgid set`: applies partial updates through `lan9645_npi_get_cfg()` + `lan9645_npi_set_cfg()` with register readback verification
- runtime AFI control now exists:
  - `afi show`: reports global AFI enable state
  - `afi set`: applies global AFI enable state with readback verification
- runtime manual-injection control now exists:
  - `inj show`: reports `SYS_PORT_MODE.INCL_INJ_HDR` for selected port `0..9`
  - `inj set`: applies `SYS_PORT_MODE.INCL_INJ_HDR` for selected port `0..9` with readback verification
- runtime HSR/PRP control now exists:
  - `hsr_prp show`: reports reserved `PGID_CPU` destination mask
  - `hsr_prp set`: applies `PGID_CPU` destination mask with readback verification
- runtime LAG control now exists:
  - `lag show`: reports current `ANA_AGGR_CFG` key-enable state
  - `lag set`: applies `ANA_AGGR_CFG` aggregation-key mask with readback verification
- runtime MDB control now exists:
  - `mdb cfg show/set`: controls `ANA_PGID_CFG` (`SAN_ENA`, `CPUQ_DST_PGID`, `OBEY_VLAN`) per index `0..88`
  - `mdb mask show/set`: controls `ANA_PGID.PGID` destination mask per index `0..88`
  - `mdb ipmc show/set`: controls `PGID_MCIPV4`/`PGID_MCIPV6` destination masks
- runtime MRP control now exists:
  - `mrp show`: reports `PGID_MRP` destination mask
  - `mrp set`: applies `PGID_MRP` destination mask with readback verification
- runtime PTP control now exists:
  - `ptp show`: reports global PTP enable state and per-port wait-for-timestamp policy (`0/1/8`)
  - `ptp global`: enables/disables PTP global feature gate
  - `ptp wait`: sets per-port wait-for-timestamp policy with readback verification
- runtime VCAP control now exists:
  - `vcap show`: reports managed-port S1/S2 decoded state and raw register snapshots
  - `vcap set`: applies managed-port S1/S2 configuration from raw values with field-level range validation and readback verification
- runtime tc classifier wrappers now exist:
  - `tcflower show/set`: controls and reports S1 classifier enable path on managed ports using VCAP-backed runtime APIs
  - `tcmatch show/set`: controls and reports S2 classifier enable path on managed ports using VCAP-backed runtime APIs
Deterministic baseline behavior catalog (all listed domains are register-backed in this STM32 pass):
- `afi`: applies deterministic AFI baseline by enabling `AFI_MISC_CTRL.AFI_ENA`.
- `cbs`: applies Linux-aligned CBS disabled baseline on managed queue scheduler elements by setting `QSYS_SE_CFG.SE_AVB_ENA=1`, `QSYS_SE_CFG.SE_FRM_MODE=0`, and clearing `QSYS_CIR_CFG` rate/burst.
- `cut_thru`: applies deterministic cut-through disable baseline on managed ports `0/1/8` by clearing `ANA_CUT_THRU_CFG.CUT_THRU_SPD` and `ANA_CUT_THRU_CFG.CUT_THRU_ENA`.
- `dcb`: applies deterministic DCB baseline on managed ports `0/1/8` by forcing ingress trust defaults (`PCP on`, `DSCP off`, default prio/DPL `0`) and disabling PFC paths in `ANA_VLAN_CFG`, `ANA_PFC_CFG`, and `QSYS_SW_PORT_MODE`.
- `eee`: applies deterministic EEE baseline on managed ports `0/1/8` by clearing `DEV_EEE_CFG.EEE_ENA` and `DEV_EEE_CFG.EEE_TIMER_WAKEUP`.
- `fp`: applies deterministic frame-preemption baseline on managed ports `0/1/8` by enabling MAC-merge layer (`DEV_ENABLE_CONFIG`), forcing verification disabled (`DEV_VERIF_CONFIG`), clearing preemptable queue masks (`QSYS_PREEMPT_CFG`), and resetting additional fragment size (`SYS_FRONT_PORT_MODE`).
- `hsr_prp`: applies deterministic HSR/PRP baseline by forcing reserved `PGID_CPU` to the CPU port mask (`port 8`) with readback verification, preparing supervision/control-plane traffic anchoring before advanced HSR/PRP rule programming.
- `lag`: applies deterministic global LAG hash baseline (`L2`) by configuring `ANA_AGGR_CFG` with `AC_DMAC_ENA=1` and `AC_SMAC_ENA=1`, while clearing the other aggregation-key enables.
- `mac`: applies deterministic managed-port MAC baseline on `0/1/8` by enforcing `100M/full`, administrative up, and readback verification of `admin/speed/duplex/RX/TX` state.
- `manual_inj`: applies deterministic manual-injection baseline by programming `SYS_PORT_MODE.INCL_INJ_HDR=1` on dedicated injection port `9`.
- `mdb`: applies deterministic multicast baseline by forcing all `ANA_PGID_CFG(0..88)` entries to `OBEY_VLAN=1` and keeping `ANA_PGID(MCIPV4/MCIPV6)=0` for snooping-default data paths until explicit MDB membership programming is added.
- `mirror`: applies safe-off baseline by clearing `ANA_MIRRORPORTS`, `ANA_EMIRRORPORTS`, and `ANA_PORT_CFG.SRC_MIRROR_ENA` for managed ports `0/1/8`, with readback verification.
- `mrp`: applies deterministic MRP baseline by forcing `ANA_PGID(PGID_MRP=57)` to `0` so reserved MRP test/control traffic can use a guaranteed blackhole destination path when required.
- `npi`: applies deterministic NPI conduit baseline by programming `QSYS_EXT_CPU_CFG` (`EXT_CPU_PORT=8`, queue mask enabled, CPU-kill protections), setting `SYS_PORT_MODE` IFH prefix policy on port `8`, disabling `REW_TAG_CFG.TAG_CFG`, and clearing reflected forwarding in `ANA_PGID(PGID_SRC+CPU_PORT)`.
- `phylink`: applies deterministic RGMII CPU-link baseline by enforcing port `8` admin/mode (`100M/full`), enabling `HSIO_RGMII_CFG` in-band lanes (`IB_ENA`, `IB_RX_ENA`, `IB_TX_ENA`), clearing RGMII reset bits, and verifying status sampling through `lan9645_core_get_rgmii_link()`.
- `bum`: applies Linux-aligned flooding baseline via `ANA_FLOODING`/`ANA_FLOODING_IPMC` and reserved flood PGIDs (`UC/BC/MC/MCIPV4/MCIPV6`) while keeping IPMC data flood entries disabled by default.
- `police`: applies Linux-aligned policer baseline using `ANA_POL_CFG`, `ANA_POL_MODE`, `ANA_POL_PIR_STATE`, and `ANA_POL_PIR_CFG` (order/redirect policy fixed, port/queue policing disabled, port policer indices reset to deterministic defaults).
- `psfp`: applies deterministic stream filter/gate reset baseline on index 0 through `ANA_SFIDTIDX`/`ANA_SFIDACCESS` and `ANA_SG_*` configuration registers, then commits and waits for `CONFIG_CHANGE` completion.
- `ptp`: applies deterministic baseline by clearing `GCB_FEAT_DISABLE.FEAT_PTP_DIS` and forcing `SYS_FRONT_PORT_MODE.DONT_WAIT_FOR_TS=0` on managed ports `0/1/8` so timestamp-dependent forwarding behavior stays deterministic before advanced PTP features are added.
- `stream`: applies deterministic stream-filter baseline by resetting SFID index `0` through `ANA_SFIDTIDX`/`ANA_SFIDACCESS` and waiting for SFID command idle completion.
- `tc_flower`: applies deterministic classifier baseline by reusing the VCAP no-rule state on managed ports `0/1/8`, keeping hardware offload paths prepared while no ACL rules are programmed.
- `tc_matchall`: applies deterministic classifier baseline by reusing the VCAP no-rule state on managed ports `0/1/8`, keeping matchall offload hooks register-backed before explicit policing/mirroring actions are added.
- `tbf`: applies deterministic token-bucket baseline on managed ports by disabling shaping mode on corresponding queue/port scheduler elements and clearing `QSYS_CIR_CFG` rate/burst fields.
- `taprio`: applies deterministic TAS baseline through `TAS_*` registers by setting scheduler defaults, forcing managed-list entries to `ADMIN`, and restoring all-queues-open gate state on ports `0/1/8`.
- `vcap`: applies deterministic ACL baseline on managed ports `0/1/8` by clearing `ANA_VCAP_CFG` (S1 disable + zero PAG/key selectors) and `ANA_VCAP_S2_CFG` (S2 disable + zero payload/lookup selectors), with readback verification.

Non register-backed matrix entries:
- currently none in this STM32 matrix baseline; all declared Linux-reference feature IDs have a deterministic apply path.
- `APP_ENOTSUP` remains reserved for future feature IDs that may be introduced before their register path is ported.

---

## 2.5) Section-by-Section Tracker (Implementation Order)

| Section | Scope | Status | Evidence |
|---|---|---|---|
| S1 | LAN transport + register descriptors | Completed (baseline) | `lan9645_spi.*`, `lan9645_reg.*`, `lan9645_regs.*`, `lan9645_target_map.*` |
| S2 | Managed profile and reset path | Completed (baseline) | `lan9645_core.*`, `lan9645_profile_managed_rmii1.*`, `main.c` reset/profile apply |
| S3 | USER_PHY adapter model | Completed (baseline) | `lan9645_user_phy_adapter.*` + deterministic logical address initialization in `eth_custom_phy_interface.c` |
| S4 | LwIP netif link integration | Completed (baseline) | `LWIP/Target/ethernetif.c` link check uses USER_PHY + MAC speed/duplex update |
| S5 | CLI command layer | Completed (expanded runtime control) | `cli_core.*` with `help`, `state`, `status`, `bringup check`, `diag clear`, `link`, `phy`, `lan id`, `lan check` (incl. IRQ gate checks), `lan profile apply`, `lan preflight`, `eth show`, `net show`, `net check`, `spi status`, `spi stats`, `serial show`, `irq`, `reg`, `port`, `vlan`, `cnt`, `feat`, `afi`, `inj`, `hsr_prp`, `lag`, `mdb`, `mrp`, `ptp`, `vcap`, `tcflower`, `tcmatch`, `sanity spi` commands |
| S6 | UI service (HEART/STATUS/ERR + USER button) | Completed (baseline) | `ui_service.*`, `main.c` polling, button triggers `status all` |
| S7 | Serial command ingress and runtime orchestrator | Completed (baseline) | `cli_ingress.*`, `app_orchestrator.*`, USB CDC + UART4 ingress wired in `main.c` and `usbd_cdc_if.c` |
| S8 | Ping validation matrix | Deferred (not performed on hardware) | software progression assumes expected pass path; board execution pending |
| S9 | Managed BSP feature closure (F1..F7) | Completed (software closure; hardware pending) | F1..F7 snapshots and traceability matrix are locked in section 2.6; hardware backlog listed explicitly as `not performed` |

Locked next section:
- execute `S8` ping matrix and target-map hardware validation closure when board access returns.
- close Phase 0 target-map validation gate with captured board evidence.

---

## 3) Phase-by-Phase Implementation Plan (Locked)

## Phase 0 - LAN9645 Documentation and Register Map Freeze (Mandatory Before LAN Coding)
Objective:
- lock the exact register addresses/bitfields used by firmware before implementing LAN driver modules.

Required activities:
1. Review LAN9645 documentation sections needed for phase 1:
- SI/SPI client interface access rules
- global reset/clock/control registers
- RMII CPU-port link status path (`DEV8`)
- copper PHY0/PHY1 mode and advertisement control
- IRQ/status clear path
- statistics counters used for health checks
2. Build a phase-1 register map source table.
3. Generate/author:
- `Core/Inc/lan9645/lan9645_regs.h` and `Core/Src/lan9645/lan9645_regs.c` (descriptor tuples + masks)
- `Core/Src/lan9645/lan9645_target_map.c` (target base table used by descriptor resolution)
4. Cross-check register names and fields with existing design docs.
5. Validate target base addresses against hardware behavior.

Outputs:
- frozen register/address list for all phase-1 API calls
- no unresolved placeholder register symbol in phase-1 scope
- validated target base table for this board profile (required)

Done when:
- every phase-1 LAN API in this plan has known address + field masks in `lan9645_regs.h`
- register map reviewed and accepted as implementation baseline
- target map has been validated with repeatable SPI read/write sanity checks on hardware

## Phase 1 - Time Service Foundation
Implement first:
- `lib_time_service`

Mandatory outputs:
- RTC or uptime timestamp API for all modules
- deterministic formatting helpers for logs

Done when:
- timestamps available before diagnostics and CLI are initialized

## Phase 2 - Diagnostics Core Foundation
Implement:
- `lib_diag_core`

Mandatory outputs:
- canonical event/error IDs
- counters, first/last timestamps, context tracking
- query API for `status errors`

Done when:
- any module can report structured events and read back counters

## Phase 3 - Diagnostics Router and Serial Adapters
Implement:
- `lib_diag_router`
- USB CDC adapter
- UART4 adapter

Mandatory outputs:
- owner policy (`USB`, `UART4`, `NONE`)
- mirror-on-none rule for errors
- text/event routing API

Done when:
- routed error lines appear on correct serial channel(s)

## Phase 4 - LAN Transport and Register Foundation
Implement first:
- `lan9645_spi.c`
- `lan9645_reg.c`

Mandatory outputs:
- SPI transaction wrapper with timeout/retry
- read/write/rmw 32-bit register helpers
- address conversion helper for SI register access
- normalized return codes for read/write errors
- use only addresses/masks from Phase 0 `lan9645_regs.h`

Done when:
- repeated SPI read/write sanity test passes
- communication errors map to common LAN error IDs

## Phase 5 - LAN Managed Profile Bring-Up
Implement:
- `lan9645_core.c`
- `lan9645_profile_managed_rmii1.c`

Mandatory outputs:
- LAN reset sequence control (`PD5`)
- strap expectation checks
- RMII CPU-port path setup
- copper port0/port1 enablement
- SerDes0/SerDes1 baseline setup for your board profile

Done when:
- profile apply function is deterministic and idempotent
- failure exits with explicit error code and CLI message

## Phase 6 - USER_PHY Adapter Layer
Implement:
- `lan9645_user_phy_adapter.c`
- integration hooks in generated `eth_custom_phy_interface.c`

Mandatory outputs:
- map `USER_PHY_BCR/BSR/ANAR/ANLPAR/PHYI1R/PHYI2R` semantics to LAN9645 managed status
- enforce 10/100-only advertisement policy
- explicit rejection of 1000 mode requests
- per-port logical context (`port0`/`port1`)

Done when:
- USER_PHY API returns stable link/speed/duplex states for both copper ports

## Phase 7 - Ethernet Link-State Integration
Implement in:
- `LWIP/Target/ethernetif.c`
- `Core/Src/stm32h7xx_hal_msp.c`
- linker script (`STM32H743BITX_FLASH.ld`)

Mandatory outputs:
- fill `ethernet_link_check_state()`
- ETH MSP init for clocks + RMII AF pins
- ETH start/stop policy based on LAN managed link state
- linker sections for `.RxDescripSection`, `.TxDescripSection`, `.Rx_PoolSection` in `RAM_D2`
- complete cache coherency handling for ETH DMA ownership changes

Done when:
- no random frame corruption/loss under ping stress

## Phase 8 - CLI + Orchestrator + UI Runtime Contract
Implement in:
- `lib_cli_core`
- `lib_app_orchestrator`
- `lib_ui_service`
- `Core/Src/main.c`
- `LWIP/App/lwip.c`

Mandatory outputs:
- `MX_LWIP_Process()` called continuously in main runtime
- baseline commands only:
  - `status all`, `status errors`, `diag clear`
  - `link show`, `phy show`
  - `lan id`, `lan check`, `lan profile apply`, `lan preflight`, `spi status`
  - register read/write and SPI sanity
- deterministic startup state machine (`BOOT` -> `LAN_RESET` -> `LAN_SPI_TEST` -> `LAN_PROFILE_APPLY` -> `NET_READY` -> `RUN`)
- locked LED and button behavior
- periodic poll schedule for LAN, CLI, diag router, and LwIP service
- ETH link monitoring bound to managed RMII1 path (`USER_PHY` logical port1) for deterministic MAC link state.

Deferred from this phase:
- feature-specific CLI controls and deep per-feature diagnostics for QoS/TSN/VCAP/FRER/PTP.
- these are added only in the matching advanced BSP phases.

Done when:
- startup and fault transitions are deterministic and repeatable
- every LAN comm fault is visible in serial debug line

## Phase 9 - Ping Validation Matrix
Validation order:
1. copper port 0 ping
2. copper port 1 ping
3. serdes/sfp path 0 ping
4. serdes/sfp path 1 ping

Done when:
- all four paths reply consistently
- no escalating error counters during repeated ping tests

---

## 4) Work Package Breakdown by File Ownership

| Package | Files | Main responsibility |
|---|---|---|
| WP0 Register Map | `lan9645_regs.h` | freeze addresses/bitfields from documentation |
| WP1 Transport | `lan9645_spi.*`, `lan9645_reg.*` | reliable SI read/write |
| WP2 Profile | `lan9645_core.*`, `lan9645_profile_managed_rmii1.*` | reset + managed switch config |
| WP3 USER_PHY | `lan9645_user_phy_adapter.*`, `eth_custom_phy_interface.c` user sections | PHY compatibility mapping |
| WP4 Netif | `ethernetif.c`, `stm32h7xx_hal_msp.c`, linker script | ETH data path + memory/caches |
| WP5 Diagnostics | `diag_core.*`, `time_service.*` | event model, counters, timestamps |
| WP6 CLI/Router | `diag_router.*`, `cli_core.*`, USB/UART adapters | serial ownership and command routing |
| WP7 Runtime | `app_orchestrator.*`, `ui_service.*`, `main.c` glue | deterministic startup/run/fault behavior |

---

## 5) Risk Controls (Must Check During Implementation)

1. SPI frame format mismatch:
- guard with transport self-test and error escalation.

2. ETH DMA/cache coherency faults:
- enforce linker + cache policy before ping tests.

3. USER_PHY semantic drift:
- keep adapter state synchronized with LAN9645 managed status only.

4. Link-up false positive:
- do not mark netif up until LAN managed link state confirms readiness.

5. Silent failures:
- every fault must produce error ID + serial output.

6. Wrong target-base mapping:
- descriptor tuples can be correct while absolute accesses are still wrong if target base values are wrong.
- require explicit hardware validation of `lan9645_target_map.c` before higher-level bring-up confidence.

---

## 6) Definition of Done (Implementation Planning Complete)

- [ ] Phase 0 documentation review and register map freeze are completed.
- [x] Module dependencies and public APIs match `STM32_library_api_dependency_contract.md`.
- [x] All planned files/modules are created with clear ownership.
- [x] USER_PHY adapter behavior matches dedicated spec exactly (software implementation level).
- [x] LwIP service/runtime contract is satisfied (`NO_SYS=1` loop).
- [x] ETH memory + cache policy software setup is in place (MSP + linker + MPU).
- [x] CLI fault visibility contract is fully active.
- [ ] Ping matrix passes on all target ports.
