SamuelCicuitStudio/LAN9645-STM32-Managed-Ethernet-Switch/pinName3d.png

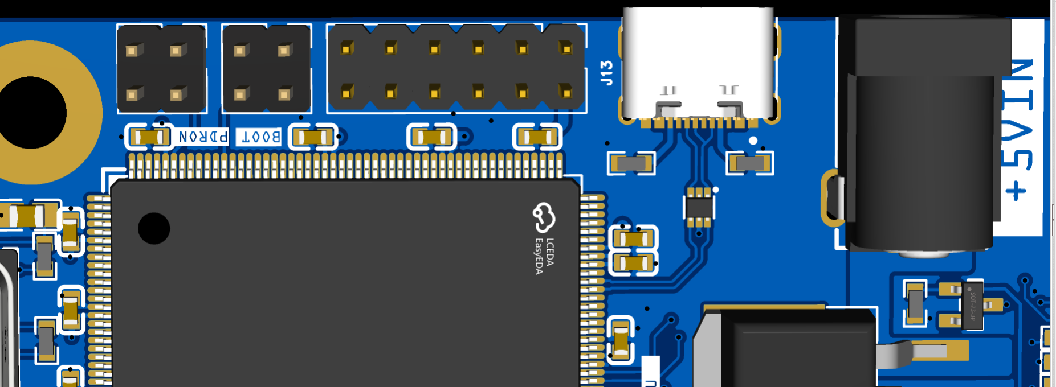
pinName3d.png
