SamuelCicuitStudio/LAN9645-STM32-Managed-Ethernet-Switch/pinName.png

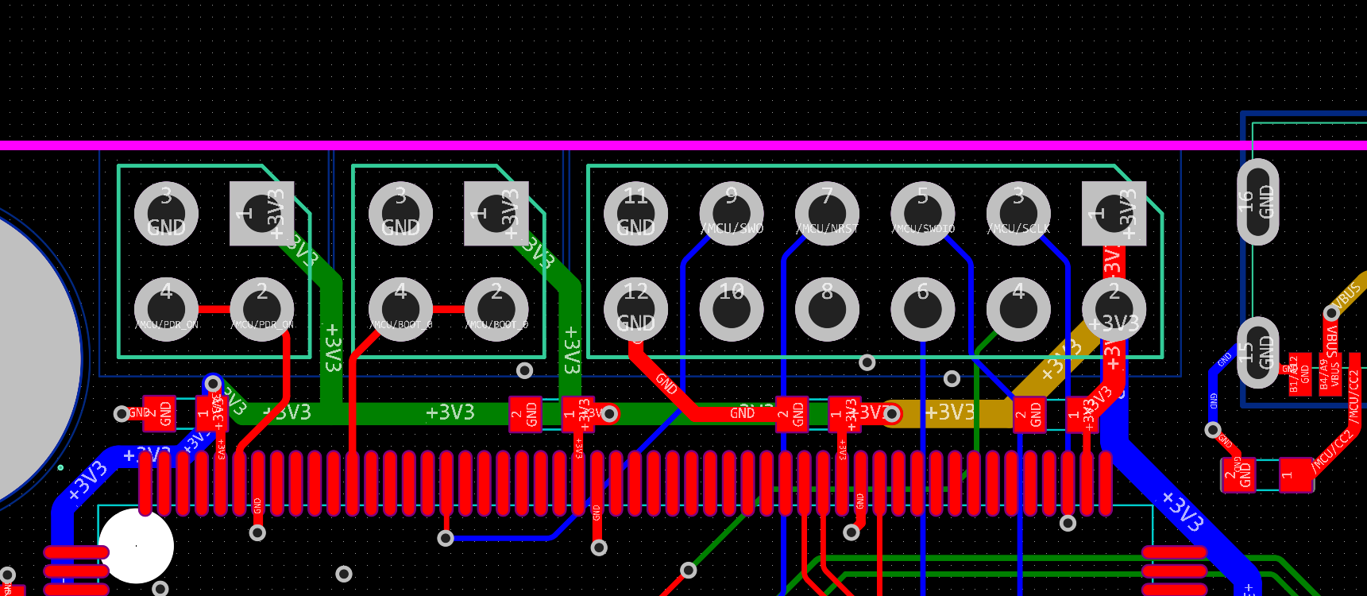
pinName.png
