SamuelCicuitStudio/LAN9645-STM32-Managed-Ethernet-Switch/Hardware/BOM/bom.csv

Designator | Footprint | Quantity | Value | Part Number | Supplier Part Number 1 | suplier
C1, C10, C100, C101, C103, C104, C105, C108, C109, C11, C13, C14, C16, C18, C22, C24, C26, C27, C30, C31, C33, C35, C36, C37, C38, C40, C43, C48, C49, C5, C50, C52, C53, C54, C55, C57, C59, C60, C61, C62, C63, C65, C66, C67, C72, C73, C74, C79, C82, C83, C84, C85, C86, C87, C88, C89, C9, C90, C91, C94, C95, C96, C97, C98, C99 | 603 | 65 | 100nf | 0603B472K500SD | 3372-0603B472K500SDTR-ND | Digikey
C102, C17, C20, C21, C28, C32, C46, C47, C58 | 805 | 9 | 100nf | 0805B104K500BD | 3372-0805B104K500BDTR-ND | Digikey
C106, C107, C69, C70, C76, C77, C92, C93 | 603 | 8 | 10uF | 0603W106M250XD | 3372-0603W106M250XDTR-ND | Digikey
C19 | 0603 | 1 | 2.2uF | C1608X5R1C225K | 445-5157-2-ND | Digikey
C12, C15 | 603 | 2 | 2.2uF | 0603W225K160XD | 3372-0603W225K160XDTR-ND | Digikey
C2, C25 | 603 | 2 | 1uF | 0603B105K160XD | 3372-0603B105K160XDTR-ND | Digikey
C23 | 402 | 1 | 4700pF | GRM155R71C472KA01D | 490-6334-2-ND | Digikey
C29 | 1206 | 1 | 100uF | C3225X5R0J107M250AC | 445-1437-2-ND | Digikey
C3, C44, C45, C78, C8, C80, C81 | 603 | 7 | 4.7uF | C1608X5R1C475K080AC | 445-7478-2-ND | Digikey
C34, C75 | 805 | 1 | 10uF DNP |  |  | Digikey
C39, C4, C51 | 805 | 3 | 1uF | 0805B105K250CC | 3372-0805B105K250CCTR-ND | Digikey
C41, C56 | 603 | 2 | 15pF | GRM1555C1H150JA01D | 490-5888-2-ND | Digikey
C42 | 402 | 1 | 10000pF | C0402C103K4RACTU | 399-C0402C103K4RACTUCT-ND | Digikey
C6, C7 | 805 | 2 | 20pF | 0805N220J500AD | 3372-0805N220J500ADTR-ND | Digikey
C64 | 603 | 1 | 33pF | GMC10CG330J50NT | 4713-GMC10CG330J50NTTR-ND | Digikey
C68, C71 | 805 | 2 | 22uF | C2012X5R1C226K | 445-6797-2-ND | Digikey
D1 | 603 | 1 | Led | NXL-1608UBC-04 | 5962-XL-1608UBC-04TR-ND | Digikey
D2 | 603 | 1 | led | XL-1608SURC-06 | 5962-XL-1608SURC-06TR-ND | Digikey
D3 | 603 | 1 | Led | XL-1608UGC-04 | 5962-XL-1608UGC-04TR-ND | Digikey
D4 | 603 | 1 | Led | LTST-C170KFKT | 160-1413-1-ND | Digikey
D5 | D_SOD-123F | 1 | PMEG2010AEH | PMEG2010AEH | 1727-3856-2-ND | Digikey
D6 | SOT-23-3 | 1 | BZX84C12 | BZX84C12 | 2156-BZX84C12-488-ND | Digikey
FB1 | 805 | 1 | 220Ω@100MHz | BLM18EG221SN1D | 490-3992-2-ND | Digikey
FB10, FB11, FB15, FB4, FB5, FB6 | 603 | 6 | 33 Ω @ 100 MHz, 3 A | MPZ2012S601AT000 | 445-MPZ2012S601AT000CT-ND | Digikey
FB13, FB14, FB7, FB8 | 603 | 4 | 220 Ω | BLM18EG221SN1D | 490-3992-2-ND | Digikey
FB2 | 603 | 1 | 600 Ω | HZ0603B102R-10 | 240-2378-2-ND | Digikey
J1, J10, J12, J3 | PinHeader_2x02_P2.54mm_Vertical | 4 | Conn_02x02_Row_Letter_Last | TSW-102-07-F-D | SAM10843-ND | Digikey
J11, J9 | Connector_SFP_and_Cage | 2 | SFP | U77-A1118-2001 | 664-U77A1118200TTR-ND | Digikey
J13 | CONN_8p94X6p5X3p16_12L_GCC | 1 | USB4215-03-A | USB4215-03-A | 2073-USB4215-03-ATR-ND | Digikey
J2 | PinHeader_2x06_P2.54mm_Vertical | 1 | Conn_02x06_Row_Letter_Last | PH2-12-UA | 2057-PH2-12-UA-ND | Digikey
J4 | PinHeader_2x01_P2.54mm_Vertical | 1 | Conn_02x01_Row_Letter_First | TSW-102-07-F-S | SAM10844-ND | Digikey
J5 | BarrelJack_GCT_DCJ200-10-A_Horizontal | 1 | Barrel_Jack_Switch | KLDX-0202-A-LT | 2092-KLDX-0202-A-LT-ND | Digikey
J6, J14 | 1 Port RJ45 Through Hole 10/100 Base-T, AutoMDIX | 2 | RJ45 | 08B0-1X1T-36-F | 5923-08B0-1X1T-36-F-ND | Digikey
L1 | IND_XAL7070_COC | 1 | XAL7070-682MEC | XAL7070-682MEC | XAL7070-682MEC | Digikey
L2 | IND_TAIYO_NR3015_TAY | 1 | NR3015T1R0N | NR3015T1R0N | 587-1647-1-ND | Digikey
Q1 | TRAN_IRF4905STRLPBF_INF | 1 | IRF4905STRLPBF | IRF4905STRLPBF | IRF4905STRLPBFTR-ND | Digikey
R1, R2, R39, R40, R41, R42, R43, R44, R49, R50, R51, R52, R53, R54, R55, R58, R62, R63, R64, R65, R67, R70, R71, R8, R9 | 603 | 25 | 1kΩ | CR0603-FX-1001ELF | CR0603-FX-1001ELFCT-ND | Digikey
R10 | 805 | 1 | 19.1kΩ | CR0805-FX-1912ELF | 118-CR0805-FX-1912ELFTR-ND | Digikey
R11 | 805 | 1 | 8.2kΩ 1% | CR0805-FX-8201ELF | 118-CR0805-FX-8201ELFTR-ND | Digikey
R12 | 805 | 1 | 2.61kΩ 1% | CR0805-FX-2611ELF | 118-CR0805-FX-2611ELFTR-ND | Digikey
R45 | 0805 |  | DNP
R13, R15 | 603 | 2 | 5.1kΩ | CR0603-FX-5101ELF | CR0603-FX-5101ELFTR-ND | Digikey
R14, R3, R36, R37, R48, R59, R60, R61, R66, R68, R72, R73, R74, R75, R76 | 603 | 15 | 10kΩ | CR0603-FX-1002ELF | CR0603-FX-1002ELFCT-ND | Digikey
R16, R17, R18 | 603 | 3 | 3.3KΩ | CR0603-FX-3301ELF | CR0603-FX-3301ELFTR-ND | Digikey
R19, R46 | 603 | 2 | 10Ω | CR0603-FX-10R0ELF | CR0603-FX-10R0ELFTR-ND | Digikey
R20, R21, R22, R23, R24, R25, R26, R27, R28, R69 | 603 | 10 | 22Ω | CR0603-FX-22R0ELF | 118-CR0603-FX-22R0ELFTR-ND | Digikey
R29 | 805 | 1 | 200Ω@1% | CR0805-FX-2000ELF | 118-CR0805-FX-2000ELFCT-ND | Digikey
R30 | 805 | 1 | 6kΩ@1% | CR0805-FX-6041ELF | 118-CR0805-FX-6041ELFTR-ND | Digikey
R31 | 603 | 1 | 100kΩ | CR0603-FX-1003ELF | CR0603-FX-1003ELFCT-ND | Digikey
R32, R33, R34, R35 | 603 | 4 | 470Ω | CR0603-FX-4700ELF | CR0603-FX-4700ELFTR-ND | Digikey
R38, R4, R47, R6, R7 | 603 | 5 | 0Ω | CR0603-J/-000ELF | CR0603-J/-000ELFTR-ND | Digikey
R5 | 603 | 1 | 10MΩ | CR0603-FW-1005ELF | CR0603-FW-1005ELFTR-ND | Digikey
R56 | 805 | 1 | 232kΩ | CR0805-FX-2323ELF | 118-CR0805-FX-2323ELFTR-ND | Digikey
R57 | 603 | 1 | 270kΩ | CR0603-FX-2703ELF | CR0603-FX-2703ELFTR-ND | Digikey
SW1, SW2 | SW_1825910-6-4 | 2 | 1825910-6 | 1825910-6 | 450-1650-ND | Digikey
U1 | LQFP-208_28x28mm_P0.5mm | 1 | STM32H743BIT6 | STM32H743BIT6 | 497-18562-ND | Digikey
U2 | QFN28_5X6_MCH | 1 | MIC24051YJL-TR | MIC24051YJL-TR | 576-4282-2-ND | Digikey
U3 | SOT-666 | 1 | USBLC6-2P6 | USBLC6-2P6 | 497-5026-2-ND | Digikey
U4 | 128-TQFP | 1 | LN96459 | LN96459 | 150-LAN96459S-I/8NW-ND | Digikey
U5 | DFN12_3X3_ML_MCH | 1 | MIC23303YML-TR | MIC23303YML-TR | 150-MIC23303YML-TR-ND | Digikey
Y1 | Crystal_SMD_HC49-SD | 1 | 8Mhz | XH8M000000S420 | 3372-XH8M000000S420TR-ND | Digikey
Y2 | XTAL_ABM8G-25.000MHZ-B4Y-T | 1 | ABM8G-25.000MHZ-B4Y-T | ABM8G-25.000MHZ-B4Y-T | 535-10297-2-ND | Digikey
Y3 | 6-VDFN | 1 | DSC1101BI2-125.0000 | DSC1101BI2-125.0000 | 150-DSC1101BI2-125.0000-ND | Digikey
