SamuelCicuitStudio/LAN9645-STM32-Managed-Ethernet-Switch/(list of files, drawings)

Other design files:
Hardware/ProDoc_EthernetSwitch_2026-02-25.epro
