SamuelCicuitStudio/LAN9645-STM32-Managed-Ethernet-Switch/Hardware/SourceFiles/EthernetSwitch.kicad_pcb

## KiCad design Hardware/SourceFiles/EthernetSwitch.kicad_pcb (2026-04-04)

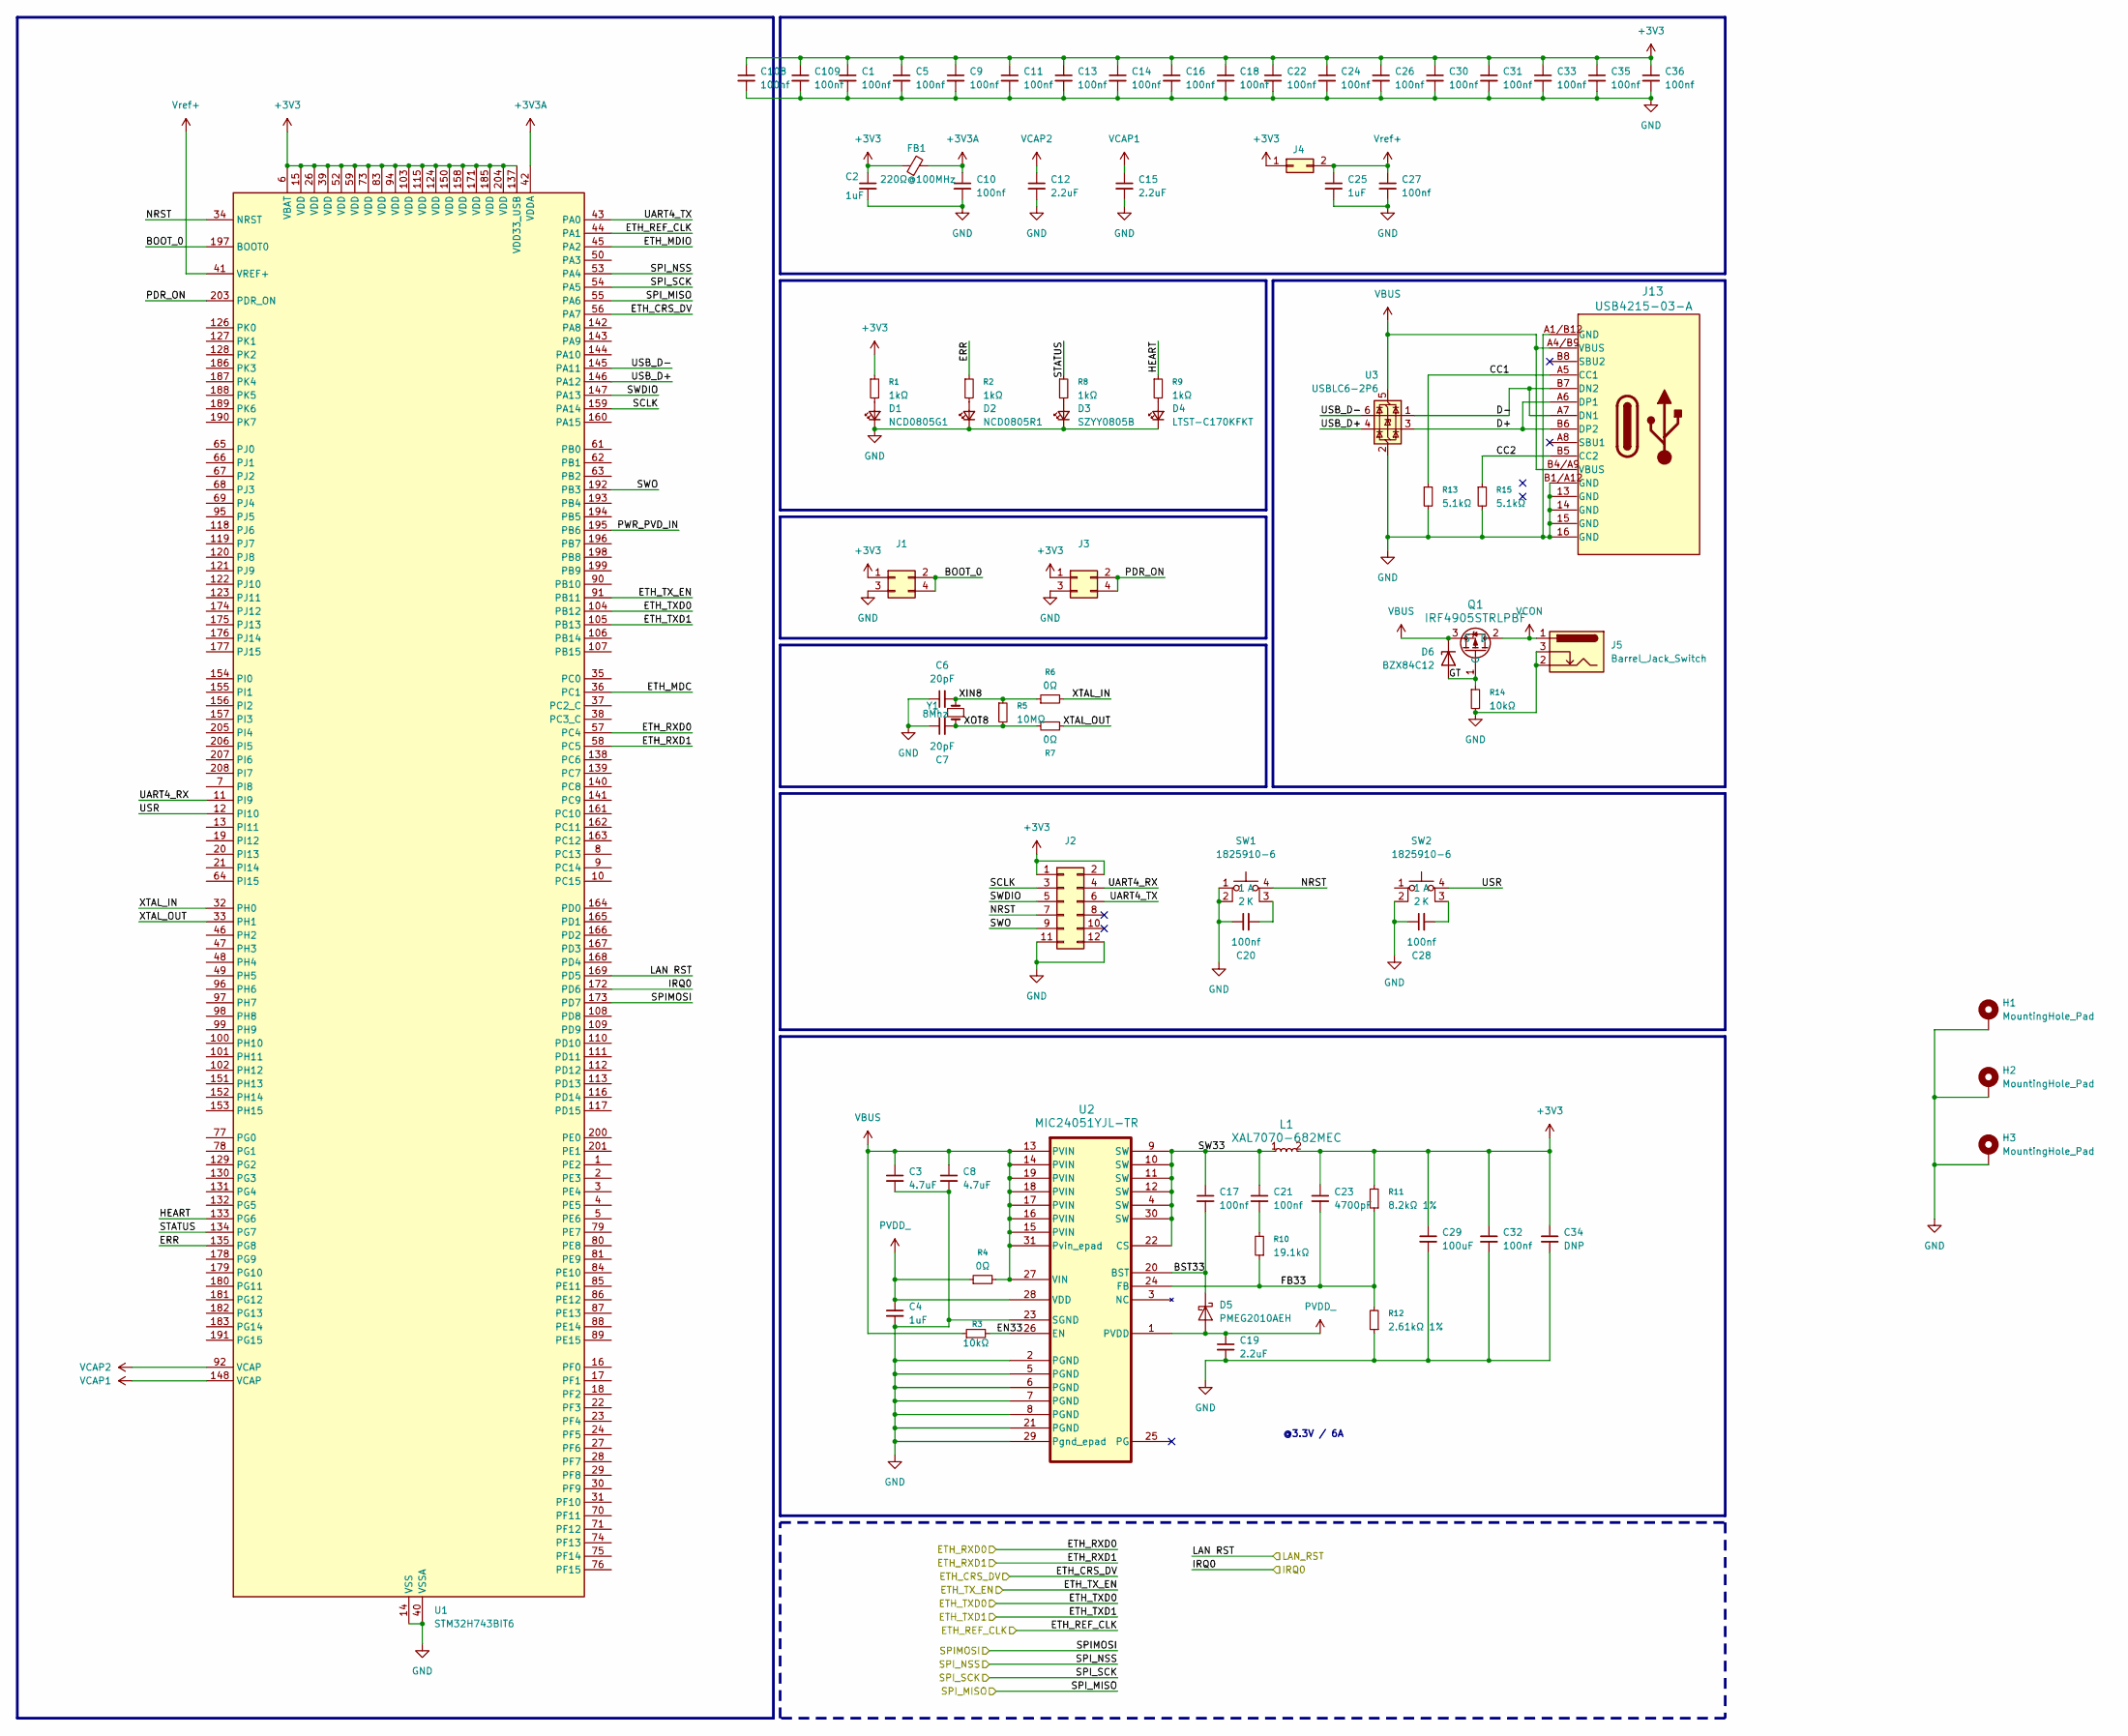
[picture p5: schematic mcu.kicad_sch]

Parts:
C1, C5, C9, C10, C11, C13, C14, C16, C18, C22, C24, C26, C27, C30, C31, C33, C35, C36, C108, C109: 100nf; C_0603_1608Metric
C2, C25: 1uF; C_0603_1608Metric
C3, C8: 4.7uF; C_0603_1608Metric
C4: 1uF; C_0805_2012Metric
C6, C7: 20pF; C_0805_2012Metric
C12, C15, C19: 2.2uF; C_0603_1608Metric
C17, C20, C21, C28, C32: 100nf; C_0805_2012Metric
C23: 4700pF; C_0402_1005Metric
C29: 100uF; C_1206_3216Metric
C34: DNP; C_0805_2012Metric
D1: NCD0805G1; LED_0603_1608Metric
D2: NCD0805R1; LED_0603_1608Metric
D3: SZYY0805B; LED_0603_1608Metric
D4: LTST-C170KFKT; LED_0603_1608Metric
D5: PMEG2010AEH; D_SOD-123F
D6: BZX84C12; SOT-23-3
FB1: 220Ω@100MHz; L_0805_2012Metric
H1, H2, H3: MountingHole_Pad; MountingHole_4.3mm_M4_Pad
J1, J3: Conn_02x02_Row_Letter_Last; PinHeader_2x02_P2.54mm_Vertical
J2: Conn_02x06_Row_Letter_Last; PinHeader_2x06_P2.54mm_Vertical
J4: Conn_02x01_Row_Letter_First; PinHeader_2x01_P2.54mm_Vertical
J5: Barrel_Jack_Switch; BarrelJack_GCT_DCJ200-10-A_Horizontal
J13: USB4215-03-A; CONN_8p94X6p5X3p16_12L_GCC
L1: XAL7070-682MEC; IND_XAL7070_COC
Q1: IRF4905STRLPBF; TRAN_IRF4905STRLPBF_INF
R1, R2, R8, R9: 1kΩ; R_0603_1608Metric
R3, R14: 10kΩ; R_0603_1608Metric
R4, R6, R7: 0Ω; R_0603_1608Metric
R5: 10MΩ; R_0603_1608Metric
R10: 19.1kΩ; R_0805_2012Metric
R11: 8.2kΩ 1%; R_0805_2012Metric
R12: 2.61kΩ 1%; R_0805_2012Metric
R13, R15: 5.1kΩ; R_0603_1608Metric
SW1, SW2: 1825910-6; SW_1825910-6-4; PARTREV C10
U1: STM32H743BIT6; LQFP-208_28x28mm_P0.5mm
U2: MIC24051YJL-TR; QFN28_5X6_MCH
U3: USBLC6-2P6; SOT-666
Y1: 8Mhz; Crystal_SMD_HC49-SD

Connections:
+3V3: C1.1, C2.1, C5.1, C9.1, C11.1, C13.1, C14.1, C16.1, C18.1, C22.1, C23.1, C24.1, C26.1, C29.1, C30.1, C31.1, C32.1, C33.1, C34.1, C35.1, C36.1, C108.1, C109.1, FB1.1, J1.1 (Pin_1a), J2.1 (Pin_1a), J2.2 (Pin_1b), J3.1 (Pin_1a), J4.1 (Pin_a1), L1.2, R1.1, R11.2, U1.6 (VBAT), U1.15 (VDD), U1.26 (VDD), U1.39 (VDD), U1.52 (VDD), U1.59 (VDD), U1.73 (VDD), U1.83 (VDD), U1.94 (VDD), U1.103 (VDD), U1.115 (VDD), U1.124 (VDD), U1.137 (VDD33_USB), U1.150 (VDD), U1.158 (VDD), U1.171 (VDD), U1.185 (VDD), U1.204 (VDD); also elsewhere on the board
+3V3A: C10.1, FB1.2, U1.42 (VDDA)
/MCU/BOOT_0: J1.2 (Pin_1b), J1.4 (Pin_2b), U1.197 (BOOT0)
/MCU/BST33: C17.2, D5.1 (K), U2.20 (BST)
/MCU/CC1: J13.A5 (CC1), R13.1
/MCU/CC2: J13.B5 (CC2), R15.1
/MCU/D+: J13.A6 (DP1), J13.B6 (DP2), U3.3 (I/O2)
/MCU/D-: J13.A7 (DN1), J13.B7 (DN2), U3.1 (I/O1)
/MCU/EN33: R3.2, U2.26 (EN)
/MCU/ERR: R2.1, U1.135 (PG8)
/MCU/ETH_CRS_DV: U1.56 (PA7); also elsewhere on the board
/MCU/ETH_MDC: U1.36 (PC1)
/MCU/ETH_MDIO: U1.45 (PA2)
/MCU/ETH_REF_CLK: U1.44 (PA1); also elsewhere on the board
/MCU/ETH_RXD0: U1.57 (PC4); also elsewhere on the board
/MCU/ETH_RXD1: U1.58 (PC5); also elsewhere on the board
/MCU/ETH_TXD0: U1.104 (PB12); also elsewhere on the board
/MCU/ETH_TXD1: U1.105 (PB13); also elsewhere on the board
/MCU/ETH_TX_EN: U1.91 (PB11); also elsewhere on the board
/MCU/FB33: C23.2, R10.1, R11.1, R12.2, U2.24 (FB)
/MCU/GT: D6.1 (A), Q1.1 (G), R14.1
/MCU/HEART: R9.1, U1.133 (PG6)
/MCU/IRQ0: U1.172 (PD6); also elsewhere on the board
/MCU/LAN RST: U1.169 (PD5); also elsewhere on the board
/MCU/NRST: J2.7 (Pin_4a), SW1.4 (A), U1.34 (NRST)
/MCU/PDR_ON: J3.2 (Pin_1b), J3.4 (Pin_2b), U1.203 (PDR_ON)
/MCU/PWR_PVD_IN: U1.195 (PB6)
/MCU/SCLK: J2.3 (Pin_2a), U1.159 (PA14)
/MCU/SPIMOSI: U1.173 (PD7); also elsewhere on the board
/MCU/SPI_MISO: U1.55 (PA6); also elsewhere on the board
/MCU/SPI_NSS: U1.53 (PA4); also elsewhere on the board
/MCU/SPI_SCK: U1.54 (PA5); also elsewhere on the board
/MCU/STATUS: R8.1, U1.134 (PG7)
/MCU/SW33: C17.1, C21.1, L1.1, U2.4 (SW), U2.9 (SW), U2.10 (SW), U2.11 (SW), U2.12 (SW), U2.22 (CS), U2.30 (SW)
/MCU/SWDIO: J2.5 (Pin_3a), U1.147 (PA13)
/MCU/SWO: J2.9 (Pin_5a), U1.192 (PB3)
/MCU/UART4_RX: J2.4 (Pin_2b), U1.11 (PI9)
/MCU/UART4_TX: J2.6 (Pin_3b), U1.43 (PA0)
/MCU/USB_D+: U1.146 (PA12), U3.4 (I/O2)
/MCU/USB_D-: U1.145 (PA11), U3.6 (I/O1)
/MCU/USR: SW2.4 (A), U1.12 (PI10)
/MCU/XIN8: C6.2, R5.1, R6.1, Y1.2
/MCU/XOT8: C7.2, R5.2, R7.1, Y1.1
/MCU/XTAL_IN: R6.2, U1.32 (PH0)
/MCU/XTAL_OUT: R7.2, U1.33 (PH1)
GND: C1.2, C2.2, C3.2, C4.2, C5.2, C6.1, C7.1, C8.2, C9.2, C10.2, C11.2, C12.2, C13.2, C14.2, C15.2, C16.2, C18.2, C19.2, C20.1, C22.2, C24.2, C25.2, C26.2, C27.2, C28.1, C29.2, C30.2, C31.2, C32.2, C33.2, C34.2, C35.2, C36.2, C108.2, C109.2, D1.1 (K), D2.1 (K), D3.1 (K), D4.1 (K), H1.1, H2.1, H3.1, J1.3 (Pin_2a), J2.11 (1Pin_6a), J2.12 (Pin_6b), J3.3 (Pin_2a), J5.2, J5.3, J13.13 (GND), J13.14 (GND), J13.15 (GND), J13.16 (GND), J13.A1/B12 (GND), J13.B1/A12 (GND), R12.1, R13.2, R14.2, R15.2, SW1.1, SW1.2, SW2.2, U1.14 (VSS), U1.25 (VSS), U1.40 (VSSA), U1.51 (VSS), U1.60 (VSS), U1.72 (VSS), U1.82 (VSS), U1.93 (VSS), U1.114 (VSS), U1.125 (VSS), U1.136 (VSS), U1.149 (VSS), U1.170 (VSS), U1.184 (VSS), U1.202 (VSS), U2.2 (PGND), U2.5 (PGND), U2.6 (PGND), U2.7 (PGND), U2.8 (PGND), U2.21 (PGND), U2.23 (SGND), U2.29 (Pgnd_epad), U3.2 (GND); also elsewhere on the board
unnamed: C21.2, R10.2
unnamed: D1.2 (A), R1.2
unnamed: D2.2 (A), R2.2
unnamed: D3.2 (A), R8.2
unnamed: D4.2 (A), R9.2
unnamed: C20.2, SW1.3 (K)
unnamed: C28.2, SW2.3 (K)
PVDD_: C4.1, C19.1, D5.2 (A), R4.1, U2.1 (PVDD), U2.28 (VDD)
VBUS: C3.1, C8.1, D6.3 (K), J13.A4/B9 (VBUS), J13.B4/A9 (VBUS), Q1.3 (S), R3.1, R4.2, U2.13 (PVIN), U2.14 (PVIN), U2.15 (PVIN), U2.16 (PVIN), U2.17 (PVIN), U2.18 (PVIN), U2.19 (PVIN), U2.27 (VIN), U2.31 (Pvin_epad), U3.5 (VBUS)
VCAP1: C15.1, U1.148 (VCAP)
VCAP2: C12.1, U1.92 (VCAP)
VCON: J5.1, Q1.2 (D)
Vref+: C25.1, C27.1, J4.2 (Pin_b1), U1.41 (VREF+)

Notes on the sheet:
@3.3V / 6A

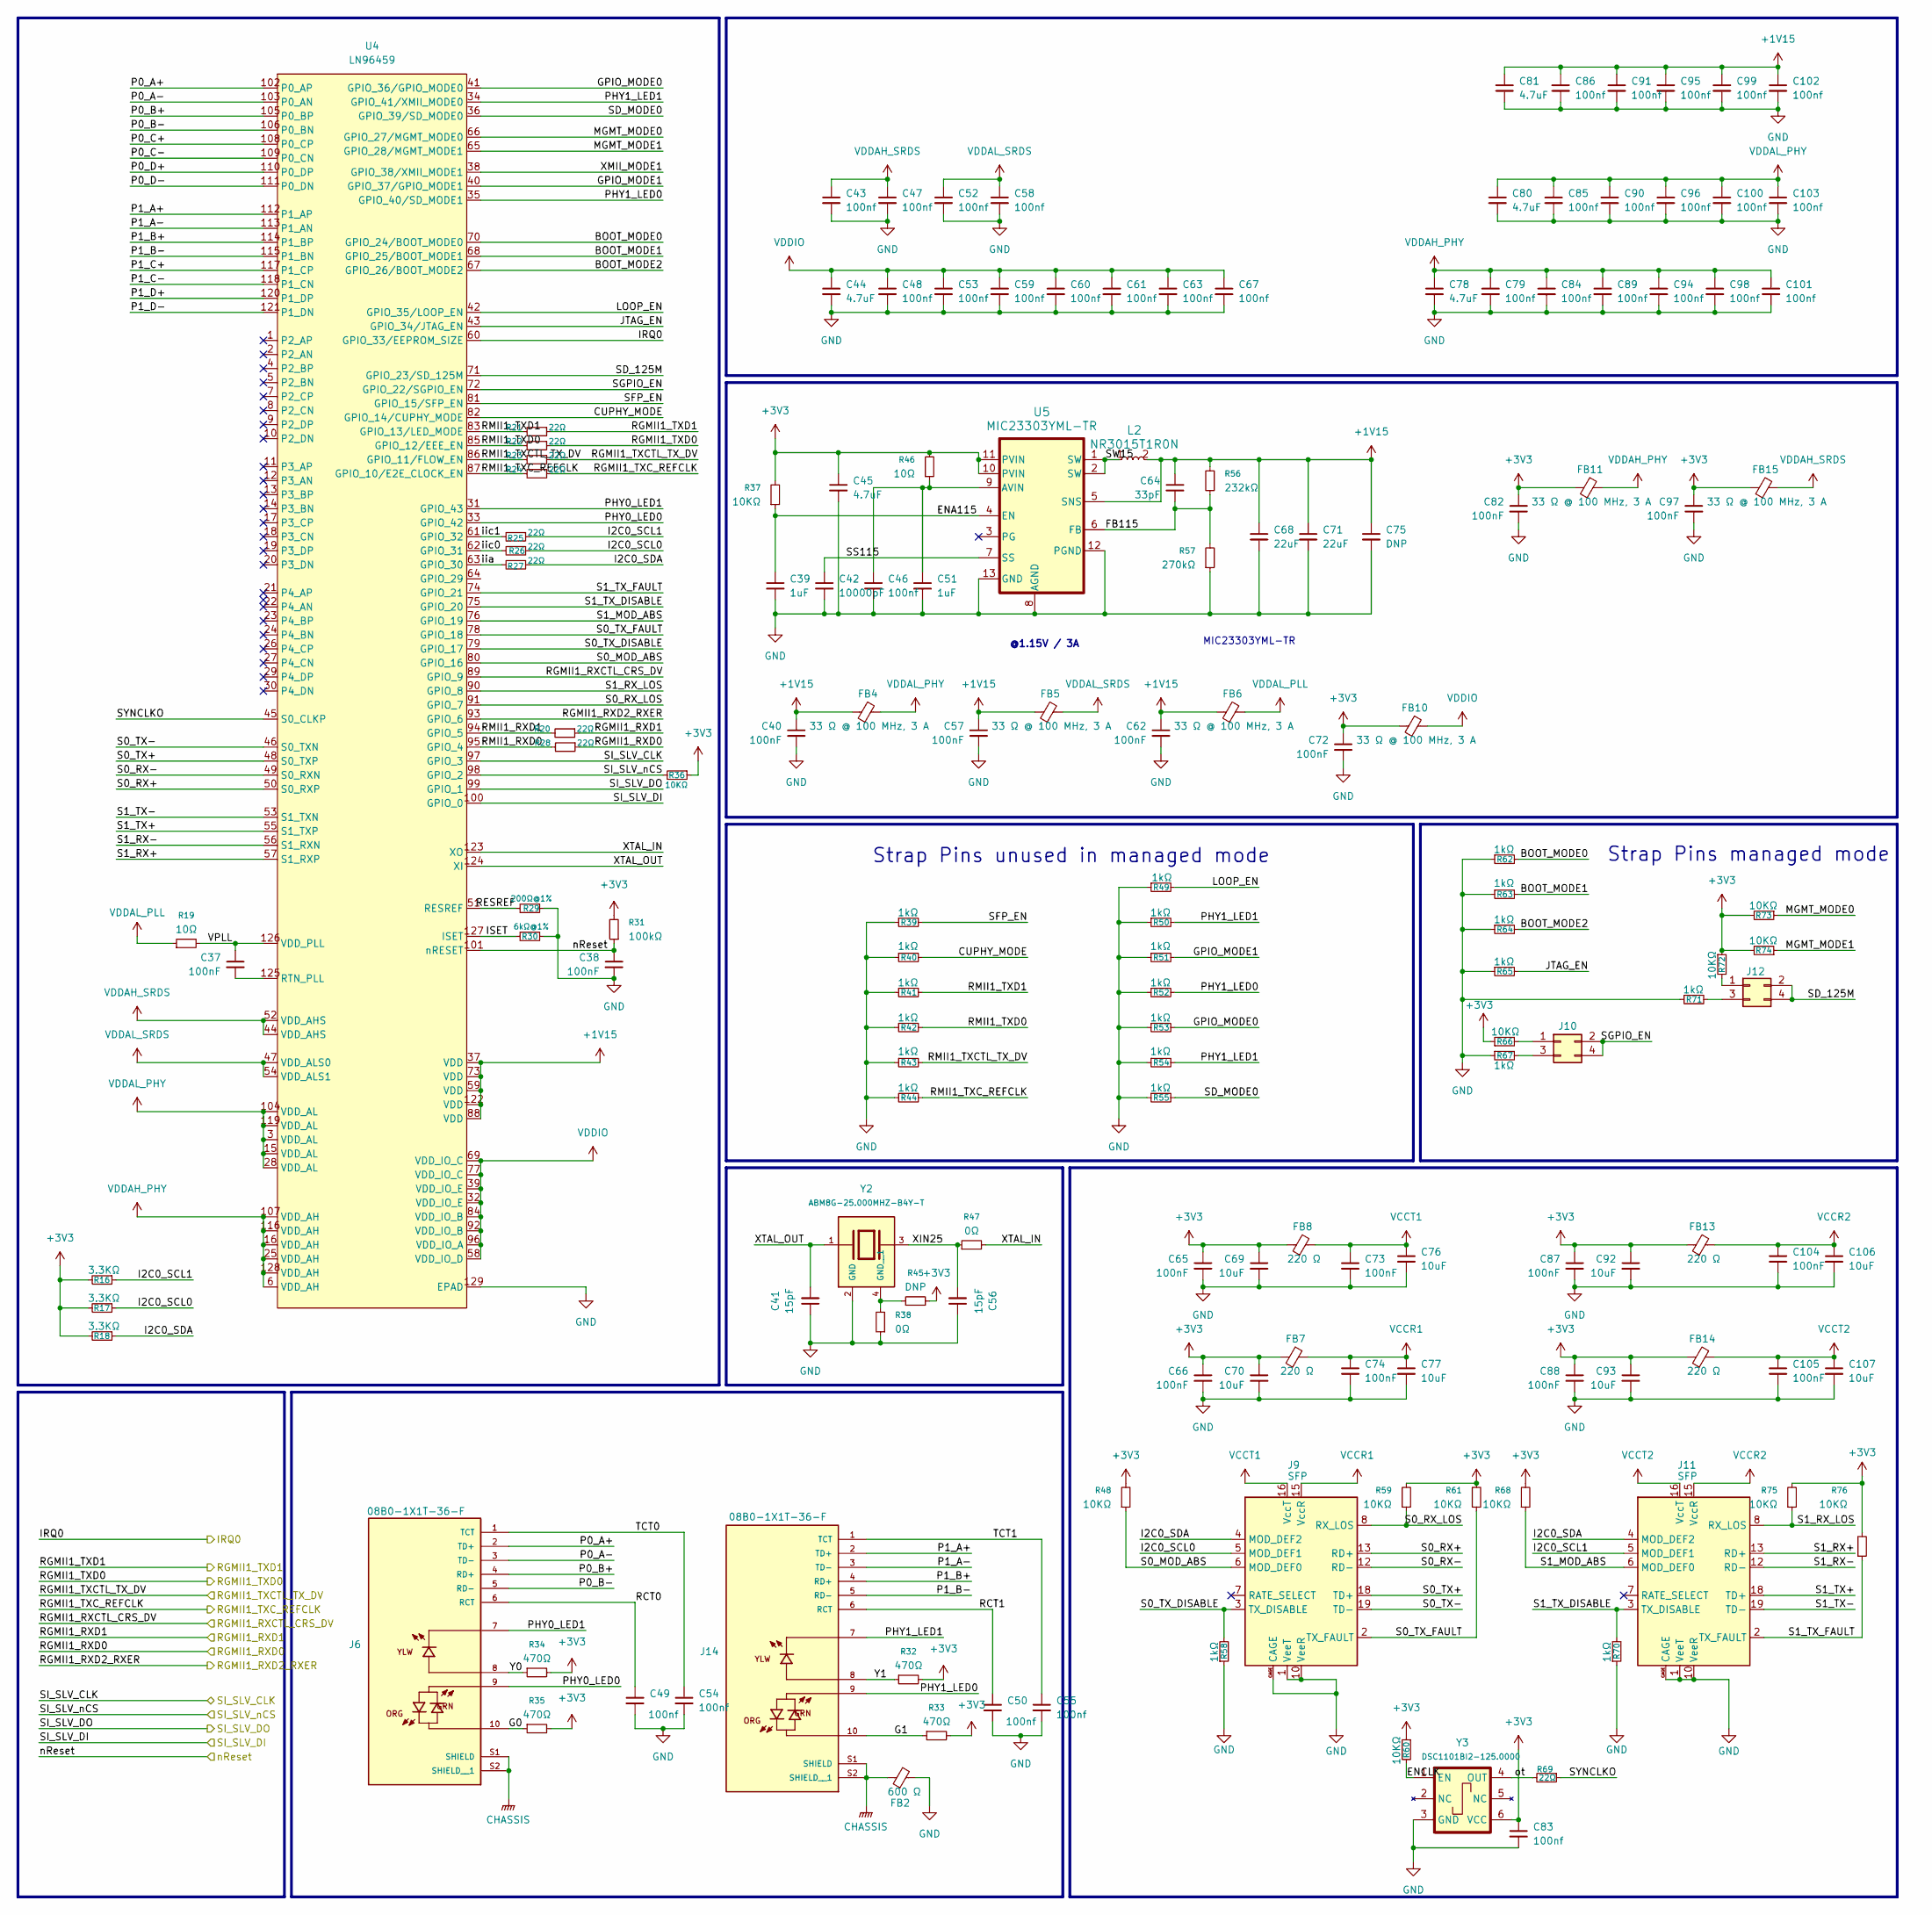
[picture p6: schematic switch.kicad_sch]

Parts:
C37, C38, C40, C57, C62, C65, C66, C72, C73, C74, C82, C87, C88, C97, C104, C105: 100nF; C_0603_1608Metric
C39, C51: 1uF; C_0805_2012Metric
C41, C56: 15pF; C_0603_1608Metric
C42: 10000pF; C_0402_1005Metric
C43, C48, C49, C50, C52, C53, C54, C55, C59, C60, C61, C63, C67, C79, C83, C84, C85, C86, C89, C90, C91, C94, C95, C96, C98, C99, C100, C101, C103: 100nf; C_0603_1608Metric
C44, C45, C78, C80, C81: 4.7uF; C_0603_1608Metric
C46, C47, C58, C102: 100nf; C_0805_2012Metric
C64: 33pF; C_0603_1608Metric
C68, C71: 22uF; C_0805_2012Metric
C69, C70, C76, C77, C92, C93, C106, C107: 10uF; C_0603_1608Metric
C75: DNP; C_0805_2012Metric
FB2: 600 Ω; L_0603_1608Metric
FB4, FB5, FB6, FB10, FB11, FB15: 33 Ω @ 100 MHz, 3 A; L_0603_1608Metric
FB7, FB8, FB13, FB14: 220 Ω; L_0603_1608Metric
J6, J14: 08B0-1X1T-36-F; BEL_08B0-1X1T-36-F; PARTREV D
J9, J11: SFP; Connector_SFP_and_Cage
J10, J12: Conn_02x02_Row_Letter_Last; PinHeader_2x02_P2.54mm_Vertical
L2: NR3015T1R0N; IND_TAIYO_NR3015_TAY
R16, R17, R18: 3.3KΩ; R_0603_1608Metric
R19, R46: 10Ω; R_0603_1608Metric
R20, R21, R22, R23, R24, R25, R26, R27, R28, R69: 22Ω; R_0603_1608Metric
R29: 200Ω@1%; R_0805_2012Metric
R30: 6kΩ@1%; R_0805_2012Metric
R31: 100kΩ; R_0603_1608Metric
R32, R33, R34, R35: 470Ω; R_0603_1608Metric
R36, R37, R48, R59, R60, R61, R66, R68, R72, R73, R74, R75, R76: 10KΩ; R_0603_1608Metric
R38, R47: 0Ω; R_0603_1608Metric
R39, R40, R41, R42, R43, R44, R49, R50, R51, R52, R53, R54, R55, R58, R62, R63, R64, R65, R67, R70, R71: 1kΩ; R_0603_1608Metric
R45: DNP; R_0805_2012Metric
R56: 232kΩ; R_0805_2012Metric
R57: 270kΩ; R_0603_1608Metric
U4: LN96459; 128-TQFP
U5: MIC23303YML-TR; DFN12_3X3_ML_MCH
Y2: ABM8G-25.000MHZ-B4Y-T; XTAL_ABM8G-25.000MHZ-B4Y-T; PARTREV 08.13.15
Y3: DSC1101BI2-125.0000; 6-VDFN

Connections:
+1V15: C40.1, C57.1, C62.1, C64.1, C68.1, C71.1, C75.1, C81.1, C86.1, C91.1, C95.1, C99.1, C102.1, FB4.1, FB5.1, FB6.1, L2.2, R56.2, U4.37 (VDD), U4.59 (VDD), U4.73 (VDD), U4.88 (VDD), U4.122 (VDD), U5.5 (SNS)
+3V3: C45.1, C65.1, C66.1, C69.1, C70.1, C72.1, C82.1, C83.1, C87.1, C88.1, C92.1, C93.1, C97.1, FB7.1, FB8.1, FB10.1, FB11.1, FB13.1, FB14.1, FB15.1, R16.2, R17.2, R18.2, R31.2, R32.2, R33.2, R34.2, R35.2, R36.1, R37.2, R45.2, R46.2, R48.2, R59.2, R60.1, R61.2, R66.1, R68.2, R72.1, R73.2, R74.2, R75.2, R76.2, U5.10 (PVIN), U5.11 (PVIN), Y3.6 (VCC); also elsewhere on the board
/MCU/ETH_CRS_DV: U4.89 (GPIO_9); also elsewhere on the board
/MCU/ETH_REF_CLK: R24.1; also elsewhere on the board
/MCU/ETH_RXD0: R28.1; also elsewhere on the board
/MCU/ETH_RXD1: R20.1; also elsewhere on the board
/MCU/ETH_TXD0: R22.1; also elsewhere on the board
/MCU/ETH_TXD1: R21.1; also elsewhere on the board
/MCU/ETH_TX_EN: R23.1; also elsewhere on the board
/MCU/IRQ0: U4.60 (GPIO_33/EEPROM_SIZE); also elsewhere on the board
/MCU/LAN RST: C38.1, R31.1, U4.101 (nRESET); also elsewhere on the board
/MCU/SPIMOSI: U4.100 (GPIO_0); also elsewhere on the board
/MCU/SPI_MISO: U4.99 (GPIO_1); also elsewhere on the board
/MCU/SPI_NSS: R36.2, U4.98 (GPIO_2); also elsewhere on the board
/MCU/SPI_SCK: U4.97 (GPIO_3); also elsewhere on the board
/PHY/BOOT_MODE0: R62.2, U4.70 (GPIO_24/BOOT_MODE0)
/PHY/BOOT_MODE1: R63.2, U4.68 (GPIO_25/BOOT_MODE1)
/PHY/BOOT_MODE2: R64.2, U4.67 (GPIO_26/BOOT_MODE2)
/PHY/CUPHY_MODE: R40.2, U4.82 (GPIO_14/CUPHY_MODE)
/PHY/ENA115: C39.1, R37.1, U5.4 (EN)
/PHY/ENCLK: R60.2, Y3.1 (EN)
/PHY/FB115: C64.2, R56.1, R57.2, U5.6 (FB)
/PHY/G0: J6.10, R35.1
/PHY/G1: J14.10, R33.1
/PHY/GPIO_MODE0: R53.2, U4.41 (GPIO_36/GPIO_MODE0)
/PHY/GPIO_MODE1: R51.2, U4.40 (GPIO_37/GPIO_MODE1)
/PHY/I2C0_SCL0: J9.5 (MOD_DEF1), R17.1, R26.1
/PHY/I2C0_SCL1: J11.5 (MOD_DEF1), R16.1, R25.1
/PHY/I2C0_SDA: J9.4 (MOD_DEF2), J11.4 (MOD_DEF2), R18.1, R27.1
/PHY/ISET: R30.2, U4.127 (ISET)
/PHY/JTAG_EN: R65.2, U4.43 (GPIO_34/JTAG_EN)
/PHY/LOOP_EN: R49.2, U4.42 (GPIO_35/LOOP_EN)
/PHY/MGMT_MODE0: R73.1, U4.66 (GPIO_27/MGMT_MODE0)
/PHY/MGMT_MODE1: R74.1, U4.65 (GPIO_28/MGMT_MODE1)
/PHY/P0_A+: J6.2 (TD+), U4.102 (P0_AP)
/PHY/P0_A-: J6.3 (TD-), U4.103 (P0_AN)
/PHY/P0_B+: J6.4 (RD+), U4.105 (P0_BP)
/PHY/P0_B-: J6.5 (RD-), U4.106 (P0_BN)
/PHY/P0_C+: U4.108 (P0_CP)
/PHY/P0_C-: U4.109 (P0_CN)
/PHY/P0_D+: U4.110 (P0_DP)
/PHY/P0_D-: U4.111 (P0_DN)
/PHY/P1_A+: J14.2 (TD+), U4.112 (P1_AP)
/PHY/P1_A-: J14.3 (TD-), U4.113 (P1_AN)
/PHY/P1_B+: J14.4 (RD+), U4.114 (P1_BP)
/PHY/P1_B-: J14.5 (RD-), U4.115 (P1_BN)
/PHY/P1_C+: U4.117 (P1_CP)
/PHY/P1_C-: U4.118 (P1_CN)
/PHY/P1_D+: U4.120 (P1_DP)
/PHY/P1_D-: U4.121 (P1_DN)
/PHY/PHY0_LED0: J6.9, U4.33 (GPIO_42)
/PHY/PHY0_LED1: J6.7, U4.31 (GPIO_43)
/PHY/PHY1_LED0: J14.9, R52.2, U4.35 (GPIO_40/SD_MODE1)
/PHY/PHY1_LED1: J14.7, R50.2, R54.2, U4.34 (GPIO_41/XMII_MODE0)
/PHY/RCT0: C49.1, J6.6 (RCT)
/PHY/RCT1: C50.1, J14.6 (RCT)
/PHY/RESREF: R29.2, U4.51 (RESREF)
/PHY/RGMII1_RXD2_RXER: U4.93 (GPIO_6)
/PHY/RMII1_RXD0: R28.2, U4.95 (GPIO_4)
/PHY/RMII1_RXD1: R20.2, U4.94 (GPIO_5)
/PHY/RMII1_TXCTL_TX_DV: R23.2, R43.2, U4.86 (GPIO_11/FLOW_EN)
/PHY/RMII1_TXC_REFCLK: R24.2, R44.2, U4.87 (GPIO_10/E2E_CLOCK_EN)
/PHY/RMII1_TXD0: R22.2, R42.2, U4.85 (GPIO_12/EEE_EN)
/PHY/RMII1_TXD1: R21.2, R41.2, U4.83 (GPIO_13/LED_MODE)
/PHY/S0_MOD_ABS: J9.6 (MOD_DEF0), R48.1, U4.80 (GPIO_16)
/PHY/S0_RX+: J9.13 (RD+), U4.50 (S0_RXP)
/PHY/S0_RX-: J9.12 (RD-), U4.49 (S0_RXN)
/PHY/S0_RX_LOS: J9.8 (RX_LOS), R59.1, U4.91 (GPIO_7)
/PHY/S0_TX+: J9.18 (TD+), U4.48 (S0_TXP)
/PHY/S0_TX-: J9.19 (TD-), U4.46 (S0_TXN)
/PHY/S0_TX_DISABLE: J9.3 (TX_DISABLE), R58.2, U4.79 (GPIO_17)
/PHY/S0_TX_FAULT: J9.2 (TX_FAULT), R61.1, U4.78 (GPIO_18)
/PHY/S1_MOD_ABS: J11.6 (MOD_DEF0), R68.1, U4.76 (GPIO_19)
/PHY/S1_RX+: J11.13 (RD+), U4.57 (S1_RXP)
/PHY/S1_RX-: J11.12 (RD-), U4.56 (S1_RXN)
/PHY/S1_RX_LOS: J11.8 (RX_LOS), R75.1, U4.90 (GPIO_8)
/PHY/S1_TX+: J11.18 (TD+), U4.55 (S1_TXP)
/PHY/S1_TX-: J11.19 (TD-), U4.53 (S1_TXN)
/PHY/S1_TX_DISABLE: J11.3 (TX_DISABLE), R70.2, U4.75 (GPIO_20)
/PHY/S1_TX_FAULT: J11.2 (TX_FAULT), R76.1, U4.74 (GPIO_21)
/PHY/SD_125M: J12.2 (Pin_1b), J12.4 (Pin_2b), U4.71 (GPIO_23/SD_125M)
/PHY/SD_MODE0: R55.2, U4.36 (GPIO_39/SD_MODE0)
/PHY/SFP_EN: R39.2, U4.81 (GPIO_15/SFP_EN)
/PHY/SGPIO_EN: J10.2 (Pin_1b), J10.4 (Pin_2b), U4.72 (GPIO_22/SGPIO_EN)
/PHY/SS115: C42.1, U5.7 (SS)
/PHY/SW15: L2.1, U5.1 (SW), U5.2 (SW)
/PHY/SYNCLKO: R69.1, U4.45 (S0_CLKP)
/PHY/TCT0: C54.1, J6.1 (TCT)
/PHY/TCT1: C55.1, J14.1 (TCT)
/PHY/VPLL: C37.1, R19.2, U4.126 (VDD_PLL)
/PHY/XIN25: C56.2, R47.1, Y2.3
/PHY/XMII_MODE1: U4.38 (GPIO_38/XMII_MODE1)
/PHY/XTAL_IN: R47.2, U4.123 (XO)
/PHY/XTAL_OUT: C41.2, U4.124 (XI), Y2.1
/PHY/Y0: J6.8, R34.1
/PHY/Y1: J14.8, R32.1
/PHY/iia: R27.2, U4.63 (GPIO_30)
/PHY/iic0: R26.2, U4.62 (GPIO_31)
/PHY/iic1: R25.2, U4.61 (GPIO_32)
/PHY/ot: R69.2, Y3.4 (OUT)
CHASSIS: FB2.1, J6.S1 (SHIELD), J6.S2 (SHIELD__1), J14.S1 (SHIELD), J14.S2 (SHIELD__1)
GND: C38.2, C39.2, C40.2, C41.1, C42.2, C43.2, C44.2, C45.2, C46.2, C47.2, C48.2, C49.2, C50.2, C51.2, C52.2, C53.2, C54.2, C55.2, C56.1, C57.2, C58.2, C59.2, C60.2, C61.2, C62.2, C63.2, C65.2, C66.2, C67.2, C68.2, C69.2, C70.2, C71.2, C72.2, C73.2, C74.2, C75.2, C76.2, C77.2, C78.2, C79.2, C80.2, C81.2, C82.2, C83.2, C84.2, C85.2, C86.2, C87.2, C88.2, C89.2, C90.2, C91.2, C92.2, C93.2, C94.2, C95.2, C96.2, C97.2, C98.2, C99.2, C100.2, C101.2, C102.2, C103.2, C104.2, C105.2, C106.2, C107.2, FB2.2, J9.1 (VeeT), J9.9 (VeeR), J9.10 (VeeR), J9.11 (VeeR), J9.14 (VeeR), J9.17 (VeeT), J9.20 (VeeT), J9.CAGE, J11.1 (VeeT), J11.9 (VeeR), J11.10 (VeeR), J11.11 (VeeR), J11.14 (VeeR), J11.17 (VeeT), J11.20 (VeeT), J11.CAGE, R29.1, R30.1, R38.1, R39.1, R40.1, R41.1, R42.1, R43.1, R44.1, R49.1, R50.1, R51.1, R52.1, R53.1, R54.1, R55.1, R57.1, R58.1, R62.1, R63.1, R64.1, R65.1, R67.1, R70.1, R71.1, U4.129 (EPAD), U5.8 (AGND), U5.12 (PGND), U5.13 (GND), Y2.2 (GND), Y3.3 (GND); also elsewhere on the board
unnamed: J10.1 (Pin_1a), R66.2
unnamed: J10.3 (Pin_2a), R67.2
unnamed: J12.1 (Pin_1a), R72.2
unnamed: J12.3 (Pin_2a), R71.2
unnamed: C37.2, U4.125 (RTN_PLL)
unnamed: C46.1, C51.1, R46.1, U5.9 (AVIN)
unnamed: R38.2, R45.1, Y2.4 (GND__1)
VCCR1: C74.1, C77.1, FB7.2, J9.15 (VccR)
VCCR2: C104.1, C106.1, FB13.2, J11.15 (VccR)
VCCT1: C73.1, C76.1, FB8.2, J9.16 (VccT)
VCCT2: C105.1, C107.1, FB14.2, J11.16 (VccT)
VDDAH_PHY: C78.1, C79.1, C84.1, C89.1, C94.1, C98.1, C101.1, FB11.2, U4.6 (VDD_AH), U4.16 (VDD_AH), U4.25 (VDD_AH), U4.107 (VDD_AH), U4.116 (VDD_AH), U4.128 (VDD_AH)
VDDAH_SRDS: C43.1, C47.1, FB15.2, U4.44 (VDD_AHS), U4.52 (VDD_AHS)
VDDAL_PHY: C80.1, C85.1, C90.1, C96.1, C100.1, C103.1, FB4.2, U4.3 (VDD_AL), U4.15 (VDD_AL), U4.28 (VDD_AL), U4.104 (VDD_AL), U4.119 (VDD_AL)
VDDAL_PLL: FB6.2, R19.1
VDDAL_SRDS: C52.1, C58.1, FB5.2, U4.47 (VDD_ALS0), U4.54 (VDD_ALS1)
VDDIO: C44.1, C48.1, C53.1, C59.1, C60.1, C61.1, C63.1, C67.1, FB10.2, U4.32 (VDD_IO_E), U4.39 (VDD_IO_E), U4.58 (VDD_IO_D), U4.69 (VDD_IO_C), U4.77 (VDD_IO_C), U4.84 (VDD_IO_B), U4.92 (VDD_IO_B), U4.96 (VDD_IO_A)

Notes on the sheet:
Strap Pins managed mode
MIC23303YML-TR
@1.15V / 3A
Strap Pins unused in managed mode

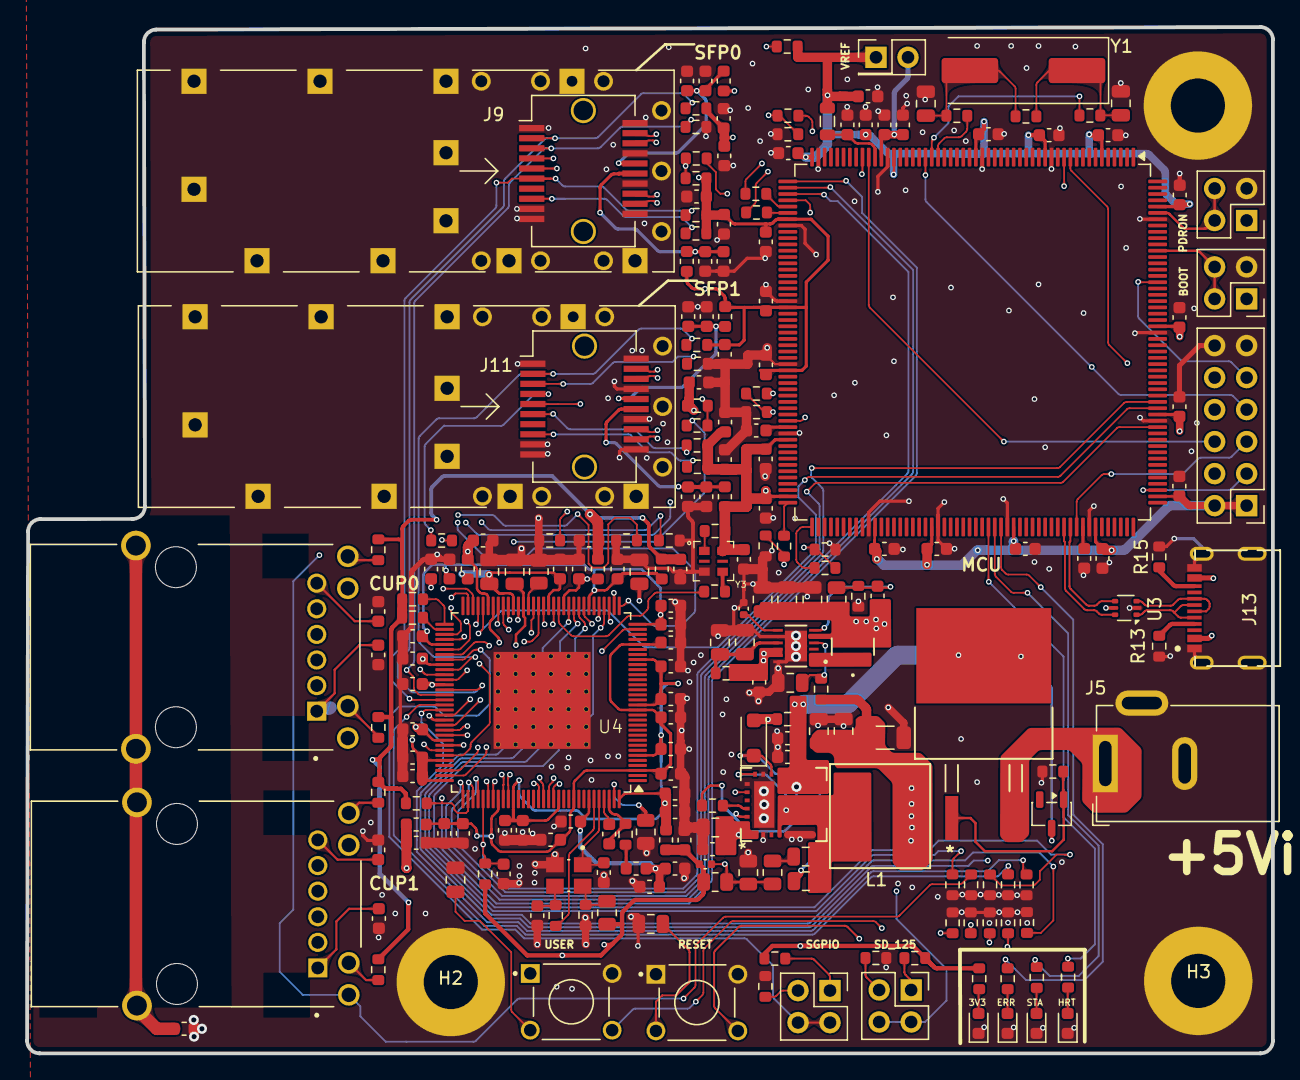
[picture p7: board EthernetSwitch.kicad_pcb from above]

Board: 6 copper layers, 98.9 x 81.4 mm, 231 parts (0 on the bottom side), 150 nets.
