SamuelCicuitStudio/LAN9645-STM32-Managed-Ethernet-Switch/firmware/Core/Inc/main.h

#define USR_Pin GPIO_PIN_10
#define USR_GPIO_Port GPIOI
#define SPI_NSS_Pin GPIO_PIN_4
#define SPI_NSS_GPIO_Port GPIOA
#define HEART_Pin GPIO_PIN_6
#define HEART_GPIO_Port GPIOG
#define STATUS_Pin GPIO_PIN_7
#define STATUS_GPIO_Port GPIOG
#define ERR_Pin GPIO_PIN_8
#define ERR_GPIO_Port GPIOG
#define LAN_RST_Pin GPIO_PIN_5
#define LAN_RST_GPIO_Port GPIOD
#define IRQ0_Pin GPIO_PIN_6
#define IRQ0_GPIO_Port GPIOD
#define IRQ0_EXTI_IRQn EXTI9_5_IRQn
