SamuelCicuitStudio/LAN9645-STM32-Managed-Ethernet-Switch/firmware/Core/Inc/lan9645/lan9645_regs.h

#ifndef LAN9645_REGS_H
#define LAN9645_REGS_H

/**
 * @file lan9645_regs.h
 * @brief LAN9645 register descriptors and field masks used by the STM32 firmware.
 */

#ifdef __cplusplus
extern "C" {
#endif

#include <stdint.h>

/** @brief Returns a bit mask containing only bit @p n. */
#define LAN9645_BIT(n)                (1u << (n))
/** @brief Returns a contiguous bit mask from bit @p l through bit @p h. */
#define LAN9645_GENMASK(h, l)         (((0xFFFFFFFFu >> (31u - (uint32_t)(h))) & 0xFFFFFFFFu) & (0xFFFFFFFFu << (uint32_t)(l)))
/** @brief Returns the least-significant bit position of a field mask. */
#define LAN9645_FIELD_SHIFT(mask)     ((uint32_t)__builtin_ctz((uint32_t)(mask)))
/** @brief Places @p val into a field described by @p mask. */
#define LAN9645_FIELD_PREP(mask, val) ((((uint32_t)(val)) << LAN9645_FIELD_SHIFT(mask)) & (uint32_t)(mask))
/** @brief Extracts a field described by @p mask from register value @p val. */
#define LAN9645_FIELD_GET(mask, val)  ((((uint32_t)(val)) & (uint32_t)(mask)) >> LAN9645_FIELD_SHIFT(mask))

/**
 * @brief Register targets used by the Linux-derived LAN9645 register map.
 *
 * Target values follow the autogenerated LAN9645 tuple format used by the BSP.
 */
typedef enum {
  LAN9645_TARGET_AFI = 0,
  LAN9645_TARGET_ANA = 1,
  LAN9645_TARGET_CHIP_TOP = 2,
  LAN9645_TARGET_CPU = 3,
  LAN9645_TARGET_DEV = 5,
  LAN9645_TARGET_GCB = 16,
  LAN9645_TARGET_HSIO = 17,
  LAN9645_TARGET_QS = 26,
  LAN9645_TARGET_QSYS = 27,
  LAN9645_TARGET_REW = 28,
  LAN9645_TARGET_SYS = 29,
  LAN9645_TARGET_TAS = 30,
  LAN9645_TARGET_COUNT = 38
} lan9645_target_t;

/**
 * @brief Compact description of one register family from the autogenerated map.
 */
typedef struct {
  lan9645_target_t target; /**< Register target block. */
  uint8_t target_instance; /**< First target instance covered by the descriptor. */
  uint8_t target_count;    /**< Number of target instances covered by the descriptor. */
  uint16_t reserved0;      /**< Reserved for alignment. */
  uint32_t group_base;     /**< Base offset of the descriptor's register group. */
  uint32_t group_instance; /**< First group instance covered by the descriptor. */
  uint32_t group_count;    /**< Number of group instances covered by the descriptor. */
  uint32_t group_width;    /**< Address stride between adjacent group instances. */
  uint32_t reg_addr;       /**< Register offset inside the group. */
  uint32_t reg_instance;   /**< First register instance covered by the descriptor. */
  uint32_t reg_count;      /**< Number of register instances covered by the descriptor. */
  uint32_t reg_width;      /**< Address stride between adjacent register instances. */
} lan9645_reg_desc_t;

/** @brief Helper macro used to define a @ref lan9645_reg_desc_t constant. */
#define LAN9645_REG_DESC(_target, _tinst, _tcnt, _gbase, _ginst, _gcnt, _gwidth, _raddr, _rinst, _rcnt, _rwidth) \
  {                                                                                                                  \
    (_target),                                                                                                       \
    (uint8_t)(_tinst),                                                                                               \
    (uint8_t)(_tcnt),                                                                                                \
    0u,                                                                                                              \
    (uint32_t)(_gbase),                                                                                              \
    (uint32_t)(_ginst),                                                                                              \
    (uint32_t)(_gcnt),                                                                                               \
    (uint32_t)(_gwidth),                                                                                             \
    (uint32_t)(_raddr),                                                                                              \
    (uint32_t)(_rinst),                                                                                              \
    (uint32_t)(_rcnt),                                                                                               \
    (uint32_t)(_rwidth)                                                                                              \
  }

/**
 * @brief Resolves the relative register address for one descriptor instance.
 *
 * @param[in] desc Register descriptor to evaluate.
 * @param[in] group_instance Additional group instance offset.
 * @param[in] reg_instance Additional register instance offset.
 *
 * @return Relative address offset before target-base translation.
 */
static inline uint32_t lan9645_reg_desc_rel_addr(
  const lan9645_reg_desc_t *desc,
  uint32_t group_instance,
  uint32_t reg_instance
)
{
  uint32_t grp = desc->group_instance + group_instance;
  uint32_t reg = desc->reg_instance + reg_instance;
  return desc->group_base + (grp * desc->group_width) + desc->reg_addr + (reg * desc->reg_width);
}

/**
 * @brief Register descriptors currently used by the STM32 managed-switch profile.
 */
extern const lan9645_reg_desc_t LAN9645_REG_ANA_AUTOAGE;
extern const lan9645_reg_desc_t LAN9645_REG_ANA_ANAINTR;
extern const lan9645_reg_desc_t LAN9645_REG_ANA_ANEVENTS;
extern const lan9645_reg_desc_t LAN9645_REG_ANA_MIRRORPORTS;
extern const lan9645_reg_desc_t LAN9645_REG_ANA_EMIRRORPORTS;
extern const lan9645_reg_desc_t LAN9645_REG_ANA_FLOODING;
extern const lan9645_reg_desc_t LAN9645_REG_ANA_FLOODING_IPMC;
extern const lan9645_reg_desc_t LAN9645_REG_ANA_PGID;
extern const lan9645_reg_desc_t LAN9645_REG_ANA_PGID_CFG;
extern const lan9645_reg_desc_t LAN9645_REG_ANA_AGGR_CFG;
extern const lan9645_reg_desc_t LAN9645_REG_ANA_CUT_THRU_CFG;
extern const lan9645_reg_desc_t LAN9645_REG_ANA_PORT_CFG;
extern const lan9645_reg_desc_t LAN9645_REG_ANA_POL_CFG;
extern const lan9645_reg_desc_t LAN9645_REG_ANA_POL_PIR_CFG;
extern const lan9645_reg_desc_t LAN9645_REG_ANA_POL_MODE;
extern const lan9645_reg_desc_t LAN9645_REG_ANA_POL_PIR_STATE;
extern const lan9645_reg_desc_t LAN9645_REG_ANA_SFIDACCESS;
extern const lan9645_reg_desc_t LAN9645_REG_ANA_SFIDTIDX;
extern const lan9645_reg_desc_t LAN9645_REG_ANA_SG_ACCESS_CTRL;
extern const lan9645_reg_desc_t LAN9645_REG_ANA_SG_CFG_1;
extern const lan9645_reg_desc_t LAN9645_REG_ANA_SG_CFG_2;
extern const lan9645_reg_desc_t LAN9645_REG_ANA_SG_CFG_3;
extern const lan9645_reg_desc_t LAN9645_REG_ANA_SG_CFG_4;
extern const lan9645_reg_desc_t LAN9645_REG_ANA_SG_CFG_5;
extern const lan9645_reg_desc_t LAN9645_REG_ANA_SG_GCL_GS_CFG;
extern const lan9645_reg_desc_t LAN9645_REG_ANA_SG_GCL_TI_CFG;
extern const lan9645_reg_desc_t LAN9645_REG_ANA_SG_GCL_OCT_CFG;
extern const lan9645_reg_desc_t LAN9645_REG_ANA_VLAN_CFG;
extern const lan9645_reg_desc_t LAN9645_REG_ANA_PFC_CFG;
extern const lan9645_reg_desc_t LAN9645_REG_ANA_QOS_CFG;
extern const lan9645_reg_desc_t LAN9645_REG_ANA_VCAP_CFG;
extern const lan9645_reg_desc_t LAN9645_REG_ANA_VCAP_S2_CFG;
extern const lan9645_reg_desc_t LAN9645_REG_ANA_PCP_DEI_CFG;
extern const lan9645_reg_desc_t LAN9645_REG_ANA_DSCP_CFG;
extern const lan9645_reg_desc_t LAN9645_REG_AFI_MISC_CTRL;
extern const lan9645_reg_desc_t LAN9645_REG_CHIP_TOP_CUPHY_PORT_CFG;
extern const lan9645_reg_desc_t LAN9645_REG_CHIP_TOP_CUPHY_LED_CFG;
extern const lan9645_reg_desc_t LAN9645_REG_CPU_INTR_ENA;
extern const lan9645_reg_desc_t LAN9645_REG_CPU_INTR_ENA_CLR;
extern const lan9645_reg_desc_t LAN9645_REG_CPU_INTR_ENA_SET;
extern const lan9645_reg_desc_t LAN9645_REG_CPU_INTR_IDENT;
extern const lan9645_reg_desc_t LAN9645_REG_CPU_INTR_IDENT1;
extern const lan9645_reg_desc_t LAN9645_REG_CPU_DEV_INTR_ENA;
extern const lan9645_reg_desc_t LAN9645_REG_CPU_DEV_INTR_IDENT;
extern const lan9645_reg_desc_t LAN9645_REG_DEV_CLOCK_CFG;
extern const lan9645_reg_desc_t LAN9645_REG_DEV_MAC_ENA_CFG;
extern const lan9645_reg_desc_t LAN9645_REG_DEV_MAC_MODE_CFG;
extern const lan9645_reg_desc_t LAN9645_REG_DEV_EEE_CFG;
extern const lan9645_reg_desc_t LAN9645_REG_DEV_ENABLE_CONFIG;
extern const lan9645_reg_desc_t LAN9645_REG_DEV_VERIF_CONFIG;
extern const lan9645_reg_desc_t LAN9645_REG_DEV_MM_STATUS;
extern const lan9645_reg_desc_t LAN9645_REG_DEV_PCS1G_CFG;
extern const lan9645_reg_desc_t LAN9645_REG_DEV_PCS1G_SD_CFG;
extern const lan9645_reg_desc_t LAN9645_REG_GCB_CHIP_ID;
extern const lan9645_reg_desc_t LAN9645_REG_GCB_SOFT_RST;
extern const lan9645_reg_desc_t LAN9645_REG_GCB_FEAT_DISABLE;
extern const lan9645_reg_desc_t LAN9645_REG_GCB_IF_CTRL;
extern const lan9645_reg_desc_t LAN9645_REG_GCB_IF_CFGSTAT;
extern const lan9645_reg_desc_t LAN9645_REG_HSIO_HW_CFG;
extern const lan9645_reg_desc_t LAN9645_REG_HSIO_RGMII_CFG;
extern const lan9645_reg_desc_t LAN9645_REG_QSYS_SW_PORT_MODE;
extern const lan9645_reg_desc_t LAN9645_REG_QSYS_EXT_CPU_CFG;
extern const lan9645_reg_desc_t LAN9645_REG_QSYS_CIR_CFG;
extern const lan9645_reg_desc_t LAN9645_REG_QSYS_SE_CFG;
extern const lan9645_reg_desc_t LAN9645_REG_QSYS_SE_DWRR_CFG;
extern const lan9645_reg_desc_t LAN9645_REG_QSYS_PREEMPT_CFG;
extern const lan9645_reg_desc_t LAN9645_REG_REW_PORT_VLAN_CFG;
extern const lan9645_reg_desc_t LAN9645_REG_REW_TAG_CFG;
extern const lan9645_reg_desc_t LAN9645_REG_REW_PCP_DEI_CFG;
extern const lan9645_reg_desc_t LAN9645_REG_TAS_TAS_CFG_CTRL;
extern const lan9645_reg_desc_t LAN9645_REG_TAS_TAS_GATE_STATE_CTRL;
extern const lan9645_reg_desc_t LAN9645_REG_TAS_TAS_STATEMACHINE_CFG;
extern const lan9645_reg_desc_t LAN9645_REG_TAS_TAS_CFG_CTRL2;
extern const lan9645_reg_desc_t LAN9645_REG_TAS_TAS_LIST_STATE;
extern const lan9645_reg_desc_t LAN9645_REG_TAS_TAS_GATE_STATE;
extern const lan9645_reg_desc_t LAN9645_REG_SYS_RESET_CFG;
extern const lan9645_reg_desc_t LAN9645_REG_SYS_PORT_MODE;
extern const lan9645_reg_desc_t LAN9645_REG_SYS_FRONT_PORT_MODE;
extern const lan9645_reg_desc_t LAN9645_REG_SYS_STAT_CFG;
extern const lan9645_reg_desc_t LAN9645_REG_SYS_SW_STATUS;
extern const lan9645_reg_desc_t LAN9645_REG_SYS_CNT;
extern const lan9645_reg_desc_t LAN9645_REG_SYS_RAM_INIT;

/**
 * @brief Field masks used by the current bring-up, profile, and diagnostics code.
 */
#define LAN9645_GCB_FEAT_DISABLE_FEAT_DD_DIS             LAN9645_BIT(5)
#define LAN9645_GCB_FEAT_DISABLE_FEAT_TSN_DIS            LAN9645_BIT(6)
#define LAN9645_GCB_FEAT_DISABLE_FEAT_PTP_DIS            LAN9645_BIT(7)
#define LAN9645_GCB_FEAT_DISABLE_FEAT_NUM_PORTS_DIS      LAN9645_GENMASK(14, 12)
#define LAN9645_GCB_FEAT_DISABLE_FEAT_NUM_CU_DIS         LAN9645_GENMASK(16, 15)
#define LAN9645_GCB_FEAT_DISABLE_FEAT_RGMII_DIS          LAN9645_GENMASK(18, 17)
#define LAN9645_GCB_FEAT_DISABLE_FEAT_SGMII_DIS          LAN9645_GENMASK(20, 19)
#define LAN9645_GCB_FEAT_DISABLE_FEAT_QSGMII_DIS         LAN9645_BIT(21)

#define LAN9645_ANA_ANAINTR_INTR                          LAN9645_BIT(1)
#define LAN9645_ANA_ANAINTR_INTR_ENA                      LAN9645_BIT(0)

#define LAN9645_ANA_MIRRORPORTS_MIRRORPORTS               LAN9645_GENMASK(9, 0)
#define LAN9645_ANA_MIRRORPORTS_MIRRORPORTS_SET(x)        LAN9645_FIELD_PREP(LAN9645_ANA_MIRRORPORTS_MIRRORPORTS, (x))

#define LAN9645_ANA_EMIRRORPORTS_EMIRRORPORTS             LAN9645_GENMASK(9, 0)
#define LAN9645_ANA_EMIRRORPORTS_EMIRRORPORTS_SET(x)      LAN9645_FIELD_PREP(LAN9645_ANA_EMIRRORPORTS_EMIRRORPORTS, (x))

#define LAN9645_ANA_FLOODING_FLD_UNICAST                  LAN9645_GENMASK(17, 12)
#define LAN9645_ANA_FLOODING_FLD_UNICAST_SET(x)           LAN9645_FIELD_PREP(LAN9645_ANA_FLOODING_FLD_UNICAST, (x))
#define LAN9645_ANA_FLOODING_FLD_BROADCAST                LAN9645_GENMASK(11, 6)
#define LAN9645_ANA_FLOODING_FLD_BROADCAST_SET(x)         LAN9645_FIELD_PREP(LAN9645_ANA_FLOODING_FLD_BROADCAST, (x))
#define LAN9645_ANA_FLOODING_FLD_MULTICAST                LAN9645_GENMASK(5, 0)
#define LAN9645_ANA_FLOODING_FLD_MULTICAST_SET(x)         LAN9645_FIELD_PREP(LAN9645_ANA_FLOODING_FLD_MULTICAST, (x))

#define LAN9645_ANA_FLOODING_IPMC_FLD_MC4_CTRL            LAN9645_GENMASK(23, 18)
#define LAN9645_ANA_FLOODING_IPMC_FLD_MC4_CTRL_SET(x)     LAN9645_FIELD_PREP(LAN9645_ANA_FLOODING_IPMC_FLD_MC4_CTRL, (x))
#define LAN9645_ANA_FLOODING_IPMC_FLD_MC4_DATA            LAN9645_GENMASK(17, 12)
#define LAN9645_ANA_FLOODING_IPMC_FLD_MC4_DATA_SET(x)     LAN9645_FIELD_PREP(LAN9645_ANA_FLOODING_IPMC_FLD_MC4_DATA, (x))
#define LAN9645_ANA_FLOODING_IPMC_FLD_MC6_CTRL            LAN9645_GENMASK(11, 6)
#define LAN9645_ANA_FLOODING_IPMC_FLD_MC6_CTRL_SET(x)     LAN9645_FIELD_PREP(LAN9645_ANA_FLOODING_IPMC_FLD_MC6_CTRL, (x))
#define LAN9645_ANA_FLOODING_IPMC_FLD_MC6_DATA            LAN9645_GENMASK(5, 0)
#define LAN9645_ANA_FLOODING_IPMC_FLD_MC6_DATA_SET(x)     LAN9645_FIELD_PREP(LAN9645_ANA_FLOODING_IPMC_FLD_MC6_DATA, (x))

#define LAN9645_ANA_PGID_PGID                             LAN9645_GENMASK(9, 0)
#define LAN9645_ANA_PGID_PGID_SET(x)                      LAN9645_FIELD_PREP(LAN9645_ANA_PGID_PGID, (x))

#define LAN9645_ANA_PGID_CFG_SAN_ENA                      LAN9645_BIT(4)
#define LAN9645_ANA_PGID_CFG_CPUQ_DST_PGID                LAN9645_GENMASK(3, 1)
#define LAN9645_ANA_PGID_CFG_CPUQ_DST_PGID_SET(x)         LAN9645_FIELD_PREP(LAN9645_ANA_PGID_CFG_CPUQ_DST_PGID, (x))
#define LAN9645_ANA_PGID_CFG_OBEY_VLAN                    LAN9645_BIT(0)

#define LAN9645_ANA_AGGR_CFG_AC_RND_ENA                   LAN9645_BIT(6)
#define LAN9645_ANA_AGGR_CFG_AC_DMAC_ENA                  LAN9645_BIT(5)
#define LAN9645_ANA_AGGR_CFG_AC_SMAC_ENA                  LAN9645_BIT(4)
#define LAN9645_ANA_AGGR_CFG_AC_IP6_FLOW_LBL_ENA          LAN9645_BIT(3)
#define LAN9645_ANA_AGGR_CFG_AC_IP6_TCPUDP_ENA            LAN9645_BIT(2)
#define LAN9645_ANA_AGGR_CFG_AC_IP4_SIPDIP_ENA            LAN9645_BIT(1)
#define LAN9645_ANA_AGGR_CFG_AC_IP4_TCPUDP_ENA            LAN9645_BIT(0)

#define LAN9645_ANA_CUT_THRU_CFG_CUT_THRU_SPD             LAN9645_GENMASK(12, 10)
#define LAN9645_ANA_CUT_THRU_CFG_CUT_THRU_SPD_SET(x)      LAN9645_FIELD_PREP(LAN9645_ANA_CUT_THRU_CFG_CUT_THRU_SPD, (x))
#define LAN9645_ANA_CUT_THRU_CFG_CUT_THRU_ENA             LAN9645_GENMASK(7, 0)
#define LAN9645_ANA_CUT_THRU_CFG_CUT_THRU_ENA_SET(x)      LAN9645_FIELD_PREP(LAN9645_ANA_CUT_THRU_CFG_CUT_THRU_ENA, (x))

#define LAN9645_ANA_PORT_CFG_SRC_MIRROR_ENA               LAN9645_BIT(13)
#define LAN9645_ANA_PORT_CFG_SRC_MIRROR_ENA_SET(x)        LAN9645_FIELD_PREP(LAN9645_ANA_PORT_CFG_SRC_MIRROR_ENA, (x))

#define LAN9645_ANA_POL_CFG_POL_CPU_REDIR_8021            LAN9645_BIT(19)
#define LAN9645_ANA_POL_CFG_POL_CPU_REDIR_8021_SET(x)     LAN9645_FIELD_PREP(LAN9645_ANA_POL_CFG_POL_CPU_REDIR_8021, (x))
#define LAN9645_ANA_POL_CFG_POL_CPU_REDIR_IP              LAN9645_BIT(18)
#define LAN9645_ANA_POL_CFG_POL_CPU_REDIR_IP_SET(x)       LAN9645_FIELD_PREP(LAN9645_ANA_POL_CFG_POL_CPU_REDIR_IP, (x))
#define LAN9645_ANA_POL_CFG_PORT_POL_ENA                  LAN9645_BIT(17)
#define LAN9645_ANA_POL_CFG_PORT_POL_ENA_SET(x)           LAN9645_FIELD_PREP(LAN9645_ANA_POL_CFG_PORT_POL_ENA, (x))
#define LAN9645_ANA_POL_CFG_QUEUE_POL_ENA                 LAN9645_GENMASK(16, 9)
#define LAN9645_ANA_POL_CFG_QUEUE_POL_ENA_SET(x)          LAN9645_FIELD_PREP(LAN9645_ANA_POL_CFG_QUEUE_POL_ENA, (x))
#define LAN9645_ANA_POL_CFG_POL_ORDER                     LAN9645_GENMASK(8, 0)
#define LAN9645_ANA_POL_CFG_POL_ORDER_SET(x)              LAN9645_FIELD_PREP(LAN9645_ANA_POL_CFG_POL_ORDER, (x))

#define LAN9645_ANA_POL_MODE_DROP_ON_YELLOW_ENA           LAN9645_BIT(11)
#define LAN9645_ANA_POL_MODE_DROP_ON_YELLOW_ENA_SET(x)    LAN9645_FIELD_PREP(LAN9645_ANA_POL_MODE_DROP_ON_YELLOW_ENA, (x))
#define LAN9645_ANA_POL_MODE_MARK_ALL_FRMS_RED_ENA        LAN9645_BIT(10)
#define LAN9645_ANA_POL_MODE_MARK_ALL_FRMS_RED_ENA_SET(x) LAN9645_FIELD_PREP(LAN9645_ANA_POL_MODE_MARK_ALL_FRMS_RED_ENA, (x))
#define LAN9645_ANA_POL_MODE_IPG_SIZE                     LAN9645_GENMASK(9, 5)
#define LAN9645_ANA_POL_MODE_IPG_SIZE_SET(x)              LAN9645_FIELD_PREP(LAN9645_ANA_POL_MODE_IPG_SIZE, (x))
#define LAN9645_ANA_POL_MODE_FRM_MODE                     LAN9645_GENMASK(4, 3)
#define LAN9645_ANA_POL_MODE_FRM_MODE_SET(x)              LAN9645_FIELD_PREP(LAN9645_ANA_POL_MODE_FRM_MODE, (x))
#define LAN9645_ANA_POL_MODE_DLB_COUPLED                  LAN9645_BIT(2)
#define LAN9645_ANA_POL_MODE_DLB_COUPLED_SET(x)           LAN9645_FIELD_PREP(LAN9645_ANA_POL_MODE_DLB_COUPLED, (x))
#define LAN9645_ANA_POL_MODE_CIR_ENA                      LAN9645_BIT(1)
#define LAN9645_ANA_POL_MODE_CIR_ENA_SET(x)               LAN9645_FIELD_PREP(LAN9645_ANA_POL_MODE_CIR_ENA, (x))
#define LAN9645_ANA_POL_MODE_OVERSHOOT_ENA                LAN9645_BIT(0)
#define LAN9645_ANA_POL_MODE_OVERSHOOT_ENA_SET(x)         LAN9645_FIELD_PREP(LAN9645_ANA_POL_MODE_OVERSHOOT_ENA, (x))

#define LAN9645_ANA_POL_PIR_STATE_PIR_LVL                 LAN9645_GENMASK(21, 0)
#define LAN9645_ANA_POL_PIR_STATE_PIR_LVL_SET(x)          LAN9645_FIELD_PREP(LAN9645_ANA_POL_PIR_STATE_PIR_LVL, (x))

#define LAN9645_ANA_POL_PIR_CFG_PIR_RATE                  LAN9645_GENMASK(20, 6)
#define LAN9645_ANA_POL_PIR_CFG_PIR_RATE_SET(x)           LAN9645_FIELD_PREP(LAN9645_ANA_POL_PIR_CFG_PIR_RATE, (x))
#define LAN9645_ANA_POL_PIR_CFG_PIR_BURST                 LAN9645_GENMASK(5, 0)
#define LAN9645_ANA_POL_PIR_CFG_PIR_BURST_SET(x)          LAN9645_FIELD_PREP(LAN9645_ANA_POL_PIR_CFG_PIR_BURST, (x))

#define LAN9645_ANA_SFIDACCESS_B_O_FRM                    LAN9645_BIT(24)
#define LAN9645_ANA_SFIDACCESS_B_O_FRM_SET(x)             LAN9645_FIELD_PREP(LAN9645_ANA_SFIDACCESS_B_O_FRM, (x))
#define LAN9645_ANA_SFIDACCESS_B_O_FRM_ENA                LAN9645_BIT(23)
#define LAN9645_ANA_SFIDACCESS_B_O_FRM_ENA_SET(x)         LAN9645_FIELD_PREP(LAN9645_ANA_SFIDACCESS_B_O_FRM_ENA, (x))
#define LAN9645_ANA_SFIDACCESS_FORCE_BLOCK                LAN9645_BIT(18)
#define LAN9645_ANA_SFIDACCESS_FORCE_BLOCK_SET(x)         LAN9645_FIELD_PREP(LAN9645_ANA_SFIDACCESS_FORCE_BLOCK, (x))
#define LAN9645_ANA_SFIDACCESS_MAX_SDU_LEN                LAN9645_GENMASK(17, 2)
#define LAN9645_ANA_SFIDACCESS_MAX_SDU_LEN_SET(x)         LAN9645_FIELD_PREP(LAN9645_ANA_SFIDACCESS_MAX_SDU_LEN, (x))
#define LAN9645_ANA_SFIDACCESS_SFID_TBL_CMD               LAN9645_GENMASK(1, 0)
#define LAN9645_ANA_SFIDACCESS_SFID_TBL_CMD_SET(x)        LAN9645_FIELD_PREP(LAN9645_ANA_SFIDACCESS_SFID_TBL_CMD, (x))

#define LAN9645_ANA_SFIDTIDX_SFID_INDEX                   LAN9645_GENMASK(6, 0)
#define LAN9645_ANA_SFIDTIDX_SFID_INDEX_SET(x)            LAN9645_FIELD_PREP(LAN9645_ANA_SFIDTIDX_SFID_INDEX, (x))

#define LAN9645_ANA_SG_ACCESS_CTRL_SGID                   LAN9645_GENMASK(6, 0)
#define LAN9645_ANA_SG_ACCESS_CTRL_SGID_SET(x)            LAN9645_FIELD_PREP(LAN9645_ANA_SG_ACCESS_CTRL_SGID, (x))
#define LAN9645_ANA_SG_ACCESS_CTRL_CONFIG_CHANGE          LAN9645_BIT(28)
#define LAN9645_ANA_SG_ACCESS_CTRL_CONFIG_CHANGE_SET(x)   LAN9645_FIELD_PREP(LAN9645_ANA_SG_ACCESS_CTRL_CONFIG_CHANGE, (x))

#define LAN9645_ANA_SG_CFG_3_BASE_TIME_SEC_MSB            LAN9645_GENMASK(15, 0)
#define LAN9645_ANA_SG_CFG_3_LIST_LENGTH                  LAN9645_GENMASK(18, 16)
#define LAN9645_ANA_SG_CFG_3_LIST_LENGTH_SET(x)           LAN9645_FIELD_PREP(LAN9645_ANA_SG_CFG_3_LIST_LENGTH, (x))
#define LAN9645_ANA_SG_CFG_3_GATE_ENABLE                  LAN9645_BIT(20)
#define LAN9645_ANA_SG_CFG_3_GATE_ENABLE_SET(x)           LAN9645_FIELD_PREP(LAN9645_ANA_SG_CFG_3_GATE_ENABLE, (x))
#define LAN9645_ANA_SG_CFG_3_INIT_IPS                     LAN9645_GENMASK(24, 21)
#define LAN9645_ANA_SG_CFG_3_INIT_IPS_SET(x)              LAN9645_FIELD_PREP(LAN9645_ANA_SG_CFG_3_INIT_IPS, (x))
#define LAN9645_ANA_SG_CFG_3_INIT_GATE_STATE              LAN9645_BIT(25)
#define LAN9645_ANA_SG_CFG_3_INIT_GATE_STATE_SET(x)       LAN9645_FIELD_PREP(LAN9645_ANA_SG_CFG_3_INIT_GATE_STATE, (x))

#define LAN9645_ANA_SG_GCL_GS_CFG_IPS                     LAN9645_GENMASK(3, 0)
#define LAN9645_ANA_SG_GCL_GS_CFG_IPS_SET(x)              LAN9645_FIELD_PREP(LAN9645_ANA_SG_GCL_GS_CFG_IPS, (x))
#define LAN9645_ANA_SG_GCL_GS_CFG_GATE_STATE              LAN9645_BIT(4)
#define LAN9645_ANA_SG_GCL_GS_CFG_GATE_STATE_SET(x)       LAN9645_FIELD_PREP(LAN9645_ANA_SG_GCL_GS_CFG_GATE_STATE, (x))

#define LAN9645_ANA_VLAN_CFG_VLAN_PFC_ENA                 LAN9645_BIT(21)
#define LAN9645_ANA_VLAN_CFG_VLAN_PFC_ENA_SET(x)          LAN9645_FIELD_PREP(LAN9645_ANA_VLAN_CFG_VLAN_PFC_ENA, (x))

#define LAN9645_ANA_PFC_CFG_RX_PFC_ENA                    LAN9645_GENMASK(9, 2)
#define LAN9645_ANA_PFC_CFG_RX_PFC_ENA_SET(x)             LAN9645_FIELD_PREP(LAN9645_ANA_PFC_CFG_RX_PFC_ENA, (x))

#define LAN9645_ANA_QOS_CFG_DEI_STAG_ONLY_ENA             LAN9645_BIT(9)
#define LAN9645_ANA_QOS_CFG_DP_DEFAULT_VAL                LAN9645_BIT(8)
#define LAN9645_ANA_QOS_CFG_DP_DEFAULT_VAL_SET(x)         LAN9645_FIELD_PREP(LAN9645_ANA_QOS_CFG_DP_DEFAULT_VAL, (x))
#define LAN9645_ANA_QOS_CFG_QOS_DEFAULT_VAL               LAN9645_GENMASK(7, 5)
#define LAN9645_ANA_QOS_CFG_QOS_DEFAULT_VAL_SET(x)        LAN9645_FIELD_PREP(LAN9645_ANA_QOS_CFG_QOS_DEFAULT_VAL, (x))
#define LAN9645_ANA_QOS_CFG_QOS_DSCP_ENA                  LAN9645_BIT(4)
#define LAN9645_ANA_QOS_CFG_QOS_DSCP_ENA_SET(x)           LAN9645_FIELD_PREP(LAN9645_ANA_QOS_CFG_QOS_DSCP_ENA, (x))
#define LAN9645_ANA_QOS_CFG_QOS_PCP_ENA                   LAN9645_BIT(3)
#define LAN9645_ANA_QOS_CFG_QOS_PCP_ENA_SET(x)            LAN9645_FIELD_PREP(LAN9645_ANA_QOS_CFG_QOS_PCP_ENA, (x))
#define LAN9645_ANA_QOS_CFG_DSCP_TRANSLATE_ENA            LAN9645_BIT(2)
#define LAN9645_ANA_QOS_CFG_DSCP_REWR_CFG                 LAN9645_GENMASK(1, 0)

#define LAN9645_ANA_VCAP_CFG_S1_SMAC_ENA                  LAN9645_GENMASK(17, 15)
#define LAN9645_ANA_VCAP_CFG_S1_SMAC_ENA_SET(x)           LAN9645_FIELD_PREP(LAN9645_ANA_VCAP_CFG_S1_SMAC_ENA, (x))
#define LAN9645_ANA_VCAP_CFG_S1_ENA                       LAN9645_BIT(14)
#define LAN9645_ANA_VCAP_CFG_S1_ENA_SET(x)                LAN9645_FIELD_PREP(LAN9645_ANA_VCAP_CFG_S1_ENA, (x))
#define LAN9645_ANA_VCAP_CFG_S1_DMAC_DIP_ENA              LAN9645_GENMASK(13, 11)
#define LAN9645_ANA_VCAP_CFG_S1_DMAC_DIP_ENA_SET(x)       LAN9645_FIELD_PREP(LAN9645_ANA_VCAP_CFG_S1_DMAC_DIP_ENA, (x))
#define LAN9645_ANA_VCAP_CFG_S1_VLAN_INNER_TAG_ENA        LAN9645_GENMASK(10, 8)
#define LAN9645_ANA_VCAP_CFG_S1_VLAN_INNER_TAG_ENA_SET(x) LAN9645_FIELD_PREP(LAN9645_ANA_VCAP_CFG_S1_VLAN_INNER_TAG_ENA, (x))
#define LAN9645_ANA_VCAP_CFG_PAG_VAL                      LAN9645_GENMASK(7, 0)
#define LAN9645_ANA_VCAP_CFG_PAG_VAL_SET(x)               LAN9645_FIELD_PREP(LAN9645_ANA_VCAP_CFG_PAG_VAL, (x))

#define LAN9645_ANA_VCAP_S2_CFG_ISDX_ENA                  LAN9645_GENMASK(20, 19)
#define LAN9645_ANA_VCAP_S2_CFG_ISDX_ENA_SET(x)           LAN9645_FIELD_PREP(LAN9645_ANA_VCAP_S2_CFG_ISDX_ENA, (x))
#define LAN9645_ANA_VCAP_S2_CFG_UDP_PAYLOAD_ENA           LAN9645_GENMASK(18, 17)
#define LAN9645_ANA_VCAP_S2_CFG_UDP_PAYLOAD_ENA_SET(x)    LAN9645_FIELD_PREP(LAN9645_ANA_VCAP_S2_CFG_UDP_PAYLOAD_ENA, (x))
#define LAN9645_ANA_VCAP_S2_CFG_ETYPE_PAYLOAD_ENA         LAN9645_GENMASK(16, 15)
#define LAN9645_ANA_VCAP_S2_CFG_ETYPE_PAYLOAD_ENA_SET(x)  LAN9645_FIELD_PREP(LAN9645_ANA_VCAP_S2_CFG_ETYPE_PAYLOAD_ENA, (x))
#define LAN9645_ANA_VCAP_S2_CFG_ENA                       LAN9645_BIT(14)
#define LAN9645_ANA_VCAP_S2_CFG_ENA_SET(x)                LAN9645_FIELD_PREP(LAN9645_ANA_VCAP_S2_CFG_ENA, (x))
#define LAN9645_ANA_VCAP_S2_CFG_SNAP_DIS                  LAN9645_GENMASK(13, 12)
#define LAN9645_ANA_VCAP_S2_CFG_SNAP_DIS_SET(x)           LAN9645_FIELD_PREP(LAN9645_ANA_VCAP_S2_CFG_SNAP_DIS, (x))
#define LAN9645_ANA_VCAP_S2_CFG_ARP_DIS                   LAN9645_GENMASK(11, 10)
#define LAN9645_ANA_VCAP_S2_CFG_ARP_DIS_SET(x)            LAN9645_FIELD_PREP(LAN9645_ANA_VCAP_S2_CFG_ARP_DIS, (x))
#define LAN9645_ANA_VCAP_S2_CFG_IP_TCPUDP_DIS             LAN9645_GENMASK(9, 8)
#define LAN9645_ANA_VCAP_S2_CFG_IP_TCPUDP_DIS_SET(x)      LAN9645_FIELD_PREP(LAN9645_ANA_VCAP_S2_CFG_IP_TCPUDP_DIS, (x))
#define LAN9645_ANA_VCAP_S2_CFG_IP_OTHER_DIS              LAN9645_GENMASK(7, 6)
#define LAN9645_ANA_VCAP_S2_CFG_IP_OTHER_DIS_SET(x)       LAN9645_FIELD_PREP(LAN9645_ANA_VCAP_S2_CFG_IP_OTHER_DIS, (x))
#define LAN9645_ANA_VCAP_S2_CFG_IP6_CFG                   LAN9645_GENMASK(5, 2)
#define LAN9645_ANA_VCAP_S2_CFG_IP6_CFG_SET(x)            LAN9645_FIELD_PREP(LAN9645_ANA_VCAP_S2_CFG_IP6_CFG, (x))
#define LAN9645_ANA_VCAP_S2_CFG_OAM_DIS                   LAN9645_GENMASK(1, 0)
#define LAN9645_ANA_VCAP_S2_CFG_OAM_DIS_SET(x)            LAN9645_FIELD_PREP(LAN9645_ANA_VCAP_S2_CFG_OAM_DIS, (x))

#define LAN9645_ANA_PCP_DEI_CFG_DP_PCP_DEI_VAL            LAN9645_BIT(3)
#define LAN9645_ANA_PCP_DEI_CFG_DP_PCP_DEI_VAL_SET(x)     LAN9645_FIELD_PREP(LAN9645_ANA_PCP_DEI_CFG_DP_PCP_DEI_VAL, (x))
#define LAN9645_ANA_PCP_DEI_CFG_QOS_PCP_DEI_VAL           LAN9645_GENMASK(2, 0)
#define LAN9645_ANA_PCP_DEI_CFG_QOS_PCP_DEI_VAL_SET(x)    LAN9645_FIELD_PREP(LAN9645_ANA_PCP_DEI_CFG_QOS_PCP_DEI_VAL, (x))

#define LAN9645_ANA_DSCP_CFG_DP_DSCP_VAL                  LAN9645_BIT(11)
#define LAN9645_ANA_DSCP_CFG_DP_DSCP_VAL_SET(x)           LAN9645_FIELD_PREP(LAN9645_ANA_DSCP_CFG_DP_DSCP_VAL, (x))
#define LAN9645_ANA_DSCP_CFG_QOS_DSCP_VAL                 LAN9645_GENMASK(10, 8)
#define LAN9645_ANA_DSCP_CFG_QOS_DSCP_VAL_SET(x)          LAN9645_FIELD_PREP(LAN9645_ANA_DSCP_CFG_QOS_DSCP_VAL, (x))
#define LAN9645_ANA_DSCP_CFG_DSCP_TRANSLATE_VAL           LAN9645_GENMASK(7, 2)
#define LAN9645_ANA_DSCP_CFG_DSCP_TRUST_ENA               LAN9645_BIT(1)
#define LAN9645_ANA_DSCP_CFG_DSCP_TRUST_ENA_SET(x)        LAN9645_FIELD_PREP(LAN9645_ANA_DSCP_CFG_DSCP_TRUST_ENA, (x))
#define LAN9645_ANA_DSCP_CFG_DSCP_REWR_ENA                LAN9645_BIT(0)
#define LAN9645_ANA_DSCP_CFG_DSCP_REWR_ENA_SET(x)         LAN9645_FIELD_PREP(LAN9645_ANA_DSCP_CFG_DSCP_REWR_ENA, (x))

#define LAN9645_AFI_MISC_CTRL_AFI_ENA                      LAN9645_BIT(0)

#define LAN9645_GCB_CHIP_ID_REV_ID                       LAN9645_GENMASK(31, 28)
#define LAN9645_GCB_CHIP_ID_PART_ID                      LAN9645_GENMASK(27, 12)
#define LAN9645_GCB_CHIP_ID_MFG_ID                       LAN9645_GENMASK(11, 1)
#define LAN9645_GCB_CHIP_ID_ONE                          LAN9645_BIT(0)

#define LAN9645_GCB_SOFT_RST_SOFT_SWC_RST                LAN9645_BIT(1)
#define LAN9645_GCB_SOFT_RST_SOFT_CHIP_RST               LAN9645_BIT(0)

#define LAN9645_GCB_IF_CTRL_IF_CTRL                      LAN9645_GENMASK(3, 0)
#define LAN9645_GCB_IF_CTRL_IF_CTRL_SET(x)               LAN9645_FIELD_PREP(LAN9645_GCB_IF_CTRL_IF_CTRL, (x))

#define LAN9645_GCB_IF_CFGSTAT_IF_STAT                   LAN9645_BIT(16)
#define LAN9645_GCB_IF_CFGSTAT_IF_CFG                    LAN9645_GENMASK(3, 0)
#define LAN9645_GCB_IF_CFGSTAT_IF_CFG_SET(x)             LAN9645_FIELD_PREP(LAN9645_GCB_IF_CFGSTAT_IF_CFG, (x))

#define LAN9645_CHIP_TOP_CUPHY_PORT_CFG_COMA_MODE        LAN9645_BIT(6)
#define LAN9645_CHIP_TOP_CUPHY_PORT_CFG_MODE             LAN9645_GENMASK(5, 1)
#define LAN9645_CHIP_TOP_CUPHY_PORT_CFG_GTX_CLK_ENA      LAN9645_BIT(0)

#define LAN9645_CPU_DEV_INTR_MASK                         LAN9645_GENMASK(8, 0)

#define LAN9645_DEV_CLOCK_CFG_MAC_TX_RST                 LAN9645_BIT(7)
#define LAN9645_DEV_CLOCK_CFG_MAC_RX_RST                 LAN9645_BIT(6)
#define LAN9645_DEV_CLOCK_CFG_PCS_TX_RST                 LAN9645_BIT(5)
#define LAN9645_DEV_CLOCK_CFG_PCS_RX_RST                 LAN9645_BIT(4)
#define LAN9645_DEV_CLOCK_CFG_PORT_RST                   LAN9645_BIT(3)
#define LAN9645_DEV_CLOCK_CFG_PHY_RST                    LAN9645_BIT(2)
#define LAN9645_DEV_CLOCK_CFG_LINK_SPEED                 LAN9645_GENMASK(1, 0)
#define LAN9645_DEV_CLOCK_CFG_LINK_SPEED_SET(x)          LAN9645_FIELD_PREP(LAN9645_DEV_CLOCK_CFG_LINK_SPEED, (x))

#define LAN9645_DEV_MAC_ENA_CFG_RX_ENA                   LAN9645_BIT(4)
#define LAN9645_DEV_MAC_ENA_CFG_TX_ENA                   LAN9645_BIT(0)

#define LAN9645_DEV_MAC_MODE_CFG_GIGA_MODE_ENA           LAN9645_BIT(4)
#define LAN9645_DEV_MAC_MODE_CFG_FDX_ENA                 LAN9645_BIT(0)

#define LAN9645_DEV_EEE_CFG_EEE_ENA                      LAN9645_BIT(22)
#define LAN9645_DEV_EEE_CFG_EEE_ENA_SET(x)               LAN9645_FIELD_PREP(LAN9645_DEV_EEE_CFG_EEE_ENA, (x))
#define LAN9645_DEV_EEE_CFG_EEE_TIMER_AGE                LAN9645_GENMASK(21, 15)
#define LAN9645_DEV_EEE_CFG_EEE_TIMER_AGE_SET(x)         LAN9645_FIELD_PREP(LAN9645_DEV_EEE_CFG_EEE_TIMER_AGE, (x))
#define LAN9645_DEV_EEE_CFG_EEE_TIMER_WAKEUP             LAN9645_GENMASK(14, 8)
#define LAN9645_DEV_EEE_CFG_EEE_TIMER_WAKEUP_SET(x)      LAN9645_FIELD_PREP(LAN9645_DEV_EEE_CFG_EEE_TIMER_WAKEUP, (x))
#define LAN9645_DEV_EEE_CFG_EEE_TIMER_HOLDOFF            LAN9645_GENMASK(7, 1)
#define LAN9645_DEV_EEE_CFG_EEE_TIMER_HOLDOFF_SET(x)     LAN9645_FIELD_PREP(LAN9645_DEV_EEE_CFG_EEE_TIMER_HOLDOFF, (x))
#define LAN9645_DEV_EEE_CFG_PORT_LPI                     LAN9645_BIT(0)
#define LAN9645_DEV_EEE_CFG_PORT_LPI_SET(x)              LAN9645_FIELD_PREP(LAN9645_DEV_EEE_CFG_PORT_LPI, (x))

#define LAN9645_DEV_ENABLE_CONFIG_MM_RX_ENA              LAN9645_BIT(0)
#define LAN9645_DEV_ENABLE_CONFIG_MM_RX_ENA_SET(x)       LAN9645_FIELD_PREP(LAN9645_DEV_ENABLE_CONFIG_MM_RX_ENA, (x))
#define LAN9645_DEV_ENABLE_CONFIG_MM_TX_ENA              LAN9645_BIT(4)
#define LAN9645_DEV_ENABLE_CONFIG_MM_TX_ENA_SET(x)       LAN9645_FIELD_PREP(LAN9645_DEV_ENABLE_CONFIG_MM_TX_ENA, (x))
#define LAN9645_DEV_ENABLE_CONFIG_KEEP_S_AFTER_D         LAN9645_BIT(8)
#define LAN9645_DEV_ENABLE_CONFIG_KEEP_S_AFTER_D_SET(x)  LAN9645_FIELD_PREP(LAN9645_DEV_ENABLE_CONFIG_KEEP_S_AFTER_D, (x))

#define LAN9645_DEV_VERIF_CONFIG_PRM_VERIFY_DIS          LAN9645_BIT(0)
#define LAN9645_DEV_VERIF_CONFIG_PRM_VERIFY_DIS_SET(x)   LAN9645_FIELD_PREP(LAN9645_DEV_VERIF_CONFIG_PRM_VERIFY_DIS, (x))
#define LAN9645_DEV_VERIF_CONFIG_PRM_VERIFY_TIME         LAN9645_GENMASK(11, 4)
#define LAN9645_DEV_VERIF_CONFIG_PRM_VERIFY_TIME_SET(x)  LAN9645_FIELD_PREP(LAN9645_DEV_VERIF_CONFIG_PRM_VERIFY_TIME, (x))
#define LAN9645_DEV_VERIF_CONFIG_VERIF_TIMER_UNITS       LAN9645_GENMASK(13, 12)
#define LAN9645_DEV_VERIF_CONFIG_VERIF_TIMER_UNITS_SET(x) LAN9645_FIELD_PREP(LAN9645_DEV_VERIF_CONFIG_VERIF_TIMER_UNITS, (x))

#define LAN9645_DEV_PCS1G_CFG_PCS_ENA                    LAN9645_BIT(0)
#define LAN9645_DEV_PCS1G_SD_CFG_SD_SEL                  LAN9645_BIT(8)
#define LAN9645_DEV_PCS1G_SD_CFG_SD_POL                  LAN9645_BIT(4)
#define LAN9645_DEV_PCS1G_SD_CFG_SD_ENA                  LAN9645_BIT(0)

#define LAN9645_HSIO_HW_CFG_RGMII_0_CFG                  LAN9645_BIT(10)
#define LAN9645_HSIO_HW_CFG_GMII_ENA                     LAN9645_GENMASK(9, 1)
#define LAN9645_HSIO_HW_CFG_GMII_ENA_SET(x)              LAN9645_FIELD_PREP(LAN9645_HSIO_HW_CFG_GMII_ENA, (x))

#define LAN9645_HSIO_RGMII_CFG_IB_RX_LINK_STATUS         LAN9645_BIT(15)
#define LAN9645_HSIO_RGMII_CFG_IB_RX_DUPLEX              LAN9645_BIT(14)
#define LAN9645_HSIO_RGMII_CFG_IB_RX_SPEED               LAN9645_GENMASK(13, 12)
#define LAN9645_HSIO_RGMII_CFG_IB_TX_LINK_STATUS         LAN9645_BIT(11)
#define LAN9645_HSIO_RGMII_CFG_IB_TX_FDX                 LAN9645_BIT(10)
#define LAN9645_HSIO_RGMII_CFG_IB_TX_MII_SPD             LAN9645_BIT(9)
#define LAN9645_HSIO_RGMII_CFG_IB_TX_SPD_1G              LAN9645_BIT(8)
#define LAN9645_HSIO_RGMII_CFG_IB_TX_ENA                 LAN9645_BIT(7)
#define LAN9645_HSIO_RGMII_CFG_IB_RX_ENA                 LAN9645_BIT(6)
#define LAN9645_HSIO_RGMII_CFG_IB_ENA                    LAN9645_BIT(5)
#define LAN9645_HSIO_RGMII_CFG_TX_CLK_CFG                LAN9645_GENMASK(4, 2)
#define LAN9645_HSIO_RGMII_CFG_TX_CLK_CFG_SET(x)         LAN9645_FIELD_PREP(LAN9645_HSIO_RGMII_CFG_TX_CLK_CFG, (x))
#define LAN9645_HSIO_RGMII_CFG_RGMII_TX_RST              LAN9645_BIT(1)
#define LAN9645_HSIO_RGMII_CFG_RGMII_RX_RST              LAN9645_BIT(0)

#define LAN9645_QSYS_SW_PORT_MODE_PORT_ENA               LAN9645_BIT(19)
#define LAN9645_QSYS_SW_PORT_MODE_TX_PFC_ENA             LAN9645_GENMASK(12, 5)
#define LAN9645_QSYS_SW_PORT_MODE_TX_PFC_ENA_SET(x)      LAN9645_FIELD_PREP(LAN9645_QSYS_SW_PORT_MODE_TX_PFC_ENA, (x))

#define LAN9645_QSYS_EXT_CPU_CFG_EXT_CPU_PORT            LAN9645_GENMASK(12, 8)
#define LAN9645_QSYS_EXT_CPU_CFG_EXT_CPU_PORT_SET(x)     LAN9645_FIELD_PREP(LAN9645_QSYS_EXT_CPU_CFG_EXT_CPU_PORT, (x))
#define LAN9645_QSYS_EXT_CPU_CFG_EXT_CPUQ_MSK            LAN9645_GENMASK(7, 0)
#define LAN9645_QSYS_EXT_CPU_CFG_EXT_CPUQ_MSK_SET(x)     LAN9645_FIELD_PREP(LAN9645_QSYS_EXT_CPU_CFG_EXT_CPUQ_MSK, (x))
#define LAN9645_QSYS_EXT_CPU_CFG_EXT_CPU_KILL_ENA        LAN9645_BIT(14)
#define LAN9645_QSYS_EXT_CPU_CFG_INT_CPU_KILL_ENA        LAN9645_BIT(13)

#define LAN9645_QSYS_CIR_CFG_CIR_RATE                    LAN9645_GENMASK(20, 6)
#define LAN9645_QSYS_CIR_CFG_CIR_RATE_SET(x)             LAN9645_FIELD_PREP(LAN9645_QSYS_CIR_CFG_CIR_RATE, (x))
#define LAN9645_QSYS_CIR_CFG_CIR_BURST                   LAN9645_GENMASK(5, 0)
#define LAN9645_QSYS_CIR_CFG_CIR_BURST_SET(x)            LAN9645_FIELD_PREP(LAN9645_QSYS_CIR_CFG_CIR_BURST, (x))

#define LAN9645_QSYS_SE_CFG_SE_DWRR_CNT                  LAN9645_GENMASK(9, 6)
#define LAN9645_QSYS_SE_CFG_SE_DWRR_CNT_SET(x)           LAN9645_FIELD_PREP(LAN9645_QSYS_SE_CFG_SE_DWRR_CNT, (x))
#define LAN9645_QSYS_SE_CFG_SE_RR_ENA                    LAN9645_BIT(5)
#define LAN9645_QSYS_SE_CFG_SE_RR_ENA_SET(x)             LAN9645_FIELD_PREP(LAN9645_QSYS_SE_CFG_SE_RR_ENA, (x))
#define LAN9645_QSYS_SE_CFG_SE_AVB_ENA                   LAN9645_BIT(4)
#define LAN9645_QSYS_SE_CFG_SE_AVB_ENA_SET(x)            LAN9645_FIELD_PREP(LAN9645_QSYS_SE_CFG_SE_AVB_ENA, (x))
#define LAN9645_QSYS_SE_CFG_SE_FRM_MODE                  LAN9645_GENMASK(3, 2)
#define LAN9645_QSYS_SE_CFG_SE_FRM_MODE_SET(x)           LAN9645_FIELD_PREP(LAN9645_QSYS_SE_CFG_SE_FRM_MODE, (x))
#define LAN9645_QSYS_SE_CFG_SE_EXC_ENA                   LAN9645_BIT(1)
#define LAN9645_QSYS_SE_CFG_SE_EXC_FWD                   LAN9645_BIT(0)

#define LAN9645_QSYS_SE_DWRR_CFG_DWRR_COST               LAN9645_GENMASK(4, 0)
#define LAN9645_QSYS_SE_DWRR_CFG_DWRR_COST_SET(x)        LAN9645_FIELD_PREP(LAN9645_QSYS_SE_DWRR_CFG_DWRR_COST, (x))

#define LAN9645_QSYS_PREEMPT_CFG_P_QUEUES                LAN9645_GENMASK(7, 0)
#define LAN9645_QSYS_PREEMPT_CFG_P_QUEUES_SET(x)         LAN9645_FIELD_PREP(LAN9645_QSYS_PREEMPT_CFG_P_QUEUES, (x))
#define LAN9645_QSYS_PREEMPT_CFG_STRICT_IPG              LAN9645_GENMASK(13, 12)
#define LAN9645_QSYS_PREEMPT_CFG_STRICT_IPG_SET(x)       LAN9645_FIELD_PREP(LAN9645_QSYS_PREEMPT_CFG_STRICT_IPG, (x))

#define LAN9645_REW_PORT_VLAN_CFG_PORT_TPID              LAN9645_GENMASK(31, 16)
#define LAN9645_REW_PORT_VLAN_CFG_PORT_DEI               LAN9645_BIT(15)
#define LAN9645_REW_PORT_VLAN_CFG_PORT_DEI_SET(x)        LAN9645_FIELD_PREP(LAN9645_REW_PORT_VLAN_CFG_PORT_DEI, (x))
#define LAN9645_REW_PORT_VLAN_CFG_PORT_PCP               LAN9645_GENMASK(14, 12)
#define LAN9645_REW_PORT_VLAN_CFG_PORT_PCP_SET(x)        LAN9645_FIELD_PREP(LAN9645_REW_PORT_VLAN_CFG_PORT_PCP, (x))
#define LAN9645_REW_PORT_VLAN_CFG_PORT_VID               LAN9645_GENMASK(11, 0)

#define LAN9645_REW_TAG_CFG_TAG_CFG                      LAN9645_GENMASK(8, 7)
#define LAN9645_REW_TAG_CFG_TAG_CFG_SET(x)               LAN9645_FIELD_PREP(LAN9645_REW_TAG_CFG_TAG_CFG, (x))
#define LAN9645_REW_TAG_CFG_TAG_TPID_CFG                 LAN9645_GENMASK(6, 5)
#define LAN9645_REW_TAG_CFG_TAG_VID_CFG                  LAN9645_BIT(4)
#define LAN9645_REW_TAG_CFG_TAG_PCP_CFG                  LAN9645_GENMASK(3, 2)
#define LAN9645_REW_TAG_CFG_TAG_PCP_CFG_SET(x)           LAN9645_FIELD_PREP(LAN9645_REW_TAG_CFG_TAG_PCP_CFG, (x))
#define LAN9645_REW_TAG_CFG_TAG_DEI_CFG                  LAN9645_GENMASK(1, 0)
#define LAN9645_REW_TAG_CFG_TAG_DEI_CFG_SET(x)           LAN9645_FIELD_PREP(LAN9645_REW_TAG_CFG_TAG_DEI_CFG, (x))

#define LAN9645_REW_PCP_DEI_CFG_DEI_QOS_VAL              LAN9645_BIT(3)
#define LAN9645_REW_PCP_DEI_CFG_DEI_QOS_VAL_SET(x)       LAN9645_FIELD_PREP(LAN9645_REW_PCP_DEI_CFG_DEI_QOS_VAL, (x))
#define LAN9645_REW_PCP_DEI_CFG_PCP_QOS_VAL              LAN9645_GENMASK(2, 0)
#define LAN9645_REW_PCP_DEI_CFG_PCP_QOS_VAL_SET(x)       LAN9645_FIELD_PREP(LAN9645_REW_PCP_DEI_CFG_PCP_QOS_VAL, (x))

#define LAN9645_TAS_TAS_CFG_CTRL_LIST_NUM_MAX            LAN9645_GENMASK(26, 22)
#define LAN9645_TAS_TAS_CFG_CTRL_LIST_NUM_MAX_SET(x)     LAN9645_FIELD_PREP(LAN9645_TAS_TAS_CFG_CTRL_LIST_NUM_MAX, (x))
#define LAN9645_TAS_TAS_CFG_CTRL_LIST_NUM                LAN9645_GENMASK(19, 15)
#define LAN9645_TAS_TAS_CFG_CTRL_LIST_NUM_SET(x)         LAN9645_FIELD_PREP(LAN9645_TAS_TAS_CFG_CTRL_LIST_NUM, (x))
#define LAN9645_TAS_TAS_CFG_CTRL_ALWAYS_GUARD_BAND_SCH_Q LAN9645_BIT(14)
#define LAN9645_TAS_TAS_CFG_CTRL_ALWAYS_GUARD_BAND_SCH_Q_SET(x) \
  LAN9645_FIELD_PREP(LAN9645_TAS_TAS_CFG_CTRL_ALWAYS_GUARD_BAND_SCH_Q, (x))
#define LAN9645_TAS_TAS_CFG_CTRL_GCL_ENTRY_NUM           LAN9645_GENMASK(9, 0)
#define LAN9645_TAS_TAS_CFG_CTRL_GCL_ENTRY_NUM_SET(x)    LAN9645_FIELD_PREP(LAN9645_TAS_TAS_CFG_CTRL_GCL_ENTRY_NUM, (x))

#define LAN9645_TAS_TAS_GATE_STATE_CTRL_HSCH_POS         LAN9645_GENMASK(3, 0)
#define LAN9645_TAS_TAS_GATE_STATE_CTRL_HSCH_POS_SET(x)  LAN9645_FIELD_PREP(LAN9645_TAS_TAS_GATE_STATE_CTRL_HSCH_POS, (x))

#define LAN9645_TAS_TAS_STATEMACHINE_CFG_REVISIT_DLY     LAN9645_GENMASK(7, 0)
#define LAN9645_TAS_TAS_STATEMACHINE_CFG_REVISIT_DLY_SET(x) \
  LAN9645_FIELD_PREP(LAN9645_TAS_TAS_STATEMACHINE_CFG_REVISIT_DLY, (x))

#define LAN9645_TAS_TAS_LIST_STATE_LIST_STATE            LAN9645_GENMASK(2, 0)
#define LAN9645_TAS_TAS_LIST_STATE_LIST_STATE_SET(x)     LAN9645_FIELD_PREP(LAN9645_TAS_TAS_LIST_STATE_LIST_STATE, (x))

#define LAN9645_TAS_TAS_GATE_STATE_TAS_GATE_STATE        LAN9645_GENMASK(7, 0)
#define LAN9645_TAS_TAS_GATE_STATE_TAS_GATE_STATE_SET(x) LAN9645_FIELD_PREP(LAN9645_TAS_TAS_GATE_STATE_TAS_GATE_STATE, (x))

#define LAN9645_SYS_RESET_CFG_CORE_ENA                   LAN9645_BIT(0)
#define LAN9645_SYS_RESET_CFG_CORE_ENA_SET(x)            LAN9645_FIELD_PREP(LAN9645_SYS_RESET_CFG_CORE_ENA, (x))

#define LAN9645_SYS_PORT_MODE_PRP_LANID                  LAN9645_BIT(8)
#define LAN9645_SYS_PORT_MODE_PRP_ENA                    LAN9645_BIT(7)
#define LAN9645_SYS_PORT_MODE_INCL_INJ_HDR               LAN9645_GENMASK(6, 5)
#define LAN9645_SYS_PORT_MODE_INCL_INJ_HDR_SET(x)        LAN9645_FIELD_PREP(LAN9645_SYS_PORT_MODE_INCL_INJ_HDR, (x))
#define LAN9645_SYS_PORT_MODE_INCL_XTR_HDR               LAN9645_GENMASK(4, 3)
#define LAN9645_SYS_PORT_MODE_INCL_XTR_HDR_SET(x)        LAN9645_FIELD_PREP(LAN9645_SYS_PORT_MODE_INCL_XTR_HDR, (x))
#define LAN9645_SYS_PORT_MODE_INJ_HDR_ERR                LAN9645_BIT(2)
#define LAN9645_SYS_PORT_MODE_PAD_DIS                    LAN9645_BIT(1)
#define LAN9645_SYS_PORT_MODE_RTAG_CLEAR                 LAN9645_BIT(0)

#define LAN9645_SYS_FRONT_PORT_MODE_HDX_MODE             LAN9645_BIT(1)
#define LAN9645_SYS_FRONT_PORT_MODE_HDX_MODE_SET(x)      LAN9645_FIELD_PREP(LAN9645_SYS_FRONT_PORT_MODE_HDX_MODE, (x))
#define LAN9645_SYS_FRONT_PORT_MODE_ADD_FRAG_SIZE        LAN9645_GENMASK(9, 8)
#define LAN9645_SYS_FRONT_PORT_MODE_ADD_FRAG_SIZE_SET(x) LAN9645_FIELD_PREP(LAN9645_SYS_FRONT_PORT_MODE_ADD_FRAG_SIZE, (x))
#define LAN9645_SYS_FRONT_PORT_MODE_DONT_WAIT_FOR_TS     LAN9645_BIT(0)
#define LAN9645_SYS_FRONT_PORT_MODE_DONT_WAIT_FOR_TS_SET(x) \
  LAN9645_FIELD_PREP(LAN9645_SYS_FRONT_PORT_MODE_DONT_WAIT_FOR_TS, (x))

#define LAN9645_SYS_STAT_CFG_STAT_CLEAR_SHOT             LAN9645_GENMASK(16, 10)
#define LAN9645_SYS_STAT_CFG_STAT_CLEAR_SHOT_SET(x)      LAN9645_FIELD_PREP(LAN9645_SYS_STAT_CFG_STAT_CLEAR_SHOT, (x))
#define LAN9645_SYS_STAT_CFG_STAT_VIEW                   LAN9645_GENMASK(9, 0)
#define LAN9645_SYS_STAT_CFG_STAT_VIEW_SET(x)            LAN9645_FIELD_PREP(LAN9645_SYS_STAT_CFG_STAT_VIEW, (x))

#define LAN9645_SYS_SW_STATUS_PORT_RX_PAUSED             LAN9645_BIT(0)

#define LAN9645_SYS_RAM_INIT_RAM_INIT                    LAN9645_BIT(1)
#define LAN9645_SYS_RAM_INIT_RAM_INIT_SET(x)             LAN9645_FIELD_PREP(LAN9645_SYS_RAM_INIT_RAM_INIT, (x))

#ifdef __cplusplus
}
#endif

#endif /* LAN9645_REGS_H */
