SamuelCicuitStudio/LAN9645-STM32-Managed-Ethernet-Switch/firmware/Core/Inc/lan9645/lan9645_core.h

#ifndef LAN9645_CORE_H
#define LAN9645_CORE_H

/**
 * @file lan9645_core.h
 * @brief High-level LAN9645 core control helpers used during switch bring-up.
 */

#ifdef __cplusplus
extern "C" {
#endif

#include <stdint.h>

#include "app_common_types.h"
#include "lan9645/lan9645_reg.h"
#include "main.h"

/** @brief Default timeout used while waiting for the LAN9645 soft reset to complete. */
#define LAN9645_CORE_SOFT_RESET_TIMEOUT_MS (200u)
/** @brief Port speed selector used by the LAN9645 core API for 10 Mbit/s operation. */
#define LAN9645_CORE_PORT_SPEED_10_MBPS    (10u)
/** @brief Port speed selector used by the LAN9645 core API for 100 Mbit/s operation. */
#define LAN9645_CORE_PORT_SPEED_100_MBPS   (100u)
/** @brief Severity code returned by IRQ analysis when no warning/error condition is present. */
#define LAN9645_CORE_IRQ_SEV_INFO          (0u)
/** @brief Severity code returned by IRQ analysis for warning-level causes. */
#define LAN9645_CORE_IRQ_SEV_WARN          (1u)
/** @brief Severity code returned by IRQ analysis for error-level causes. */
#define LAN9645_CORE_IRQ_SEV_ERR           (2u)

/** @brief ANA event bit for LLCT port errors. */
#define LAN9645_CORE_ANA_EVT_LLCT_PORT_ERR      LAN9645_BIT(30u)
/** @brief ANA event bit for CPU learn failures. */
#define LAN9645_CORE_ANA_EVT_CPU_LEARN_FAILED   LAN9645_BIT(21u)
/** @brief ANA event bit for automatic learn failures. */
#define LAN9645_CORE_ANA_EVT_AUTO_LEARN_FAILED  LAN9645_BIT(20u)
/** @brief ANA event bit for learn-drop notifications. */
#define LAN9645_CORE_ANA_EVT_LEARN_DROP         LAN9645_BIT(23u)
/** @brief ANA event bit for aged-entry notifications. */
#define LAN9645_CORE_ANA_EVT_AGED_ENTRY         LAN9645_BIT(22u)
/** @brief ANA event bit for dropped-frame notifications. */
#define LAN9645_CORE_ANA_EVT_DROPPED            LAN9645_BIT(16u)
/** @brief ANA event bit for classified-drop notifications. */
#define LAN9645_CORE_ANA_EVT_CLASSIFIED_DROP    LAN9645_BIT(15u)
/** @brief ANA event bit for VLAN discard notifications. */
#define LAN9645_CORE_ANA_EVT_VLAN_DISCARD       LAN9645_BIT(13u)
/** @brief ANA event bit for forwarding discard notifications. */
#define LAN9645_CORE_ANA_EVT_FWD_DISCARD        LAN9645_BIT(12u)
/** @brief ANA event bit for sequence-generator errors (channel 0). */
#define LAN9645_CORE_ANA_EVT_SEQ_GEN_ERR_0      LAN9645_BIT(1u)
/** @brief ANA event bit for sequence-generator errors (channel 1). */
#define LAN9645_CORE_ANA_EVT_SEQ_GEN_ERR_1      LAN9645_BIT(0u)

/** @brief Aggregate mask for error-class ANA events. */
#define LAN9645_CORE_ANA_EVT_ERR_MASK           (LAN9645_CORE_ANA_EVT_LLCT_PORT_ERR | \
                                                 LAN9645_CORE_ANA_EVT_CPU_LEARN_FAILED | \
                                                 LAN9645_CORE_ANA_EVT_AUTO_LEARN_FAILED | \
                                                 LAN9645_CORE_ANA_EVT_SEQ_GEN_ERR_0 | \
                                                 LAN9645_CORE_ANA_EVT_SEQ_GEN_ERR_1)
/** @brief Aggregate mask for drop-related ANA events. */
#define LAN9645_CORE_ANA_EVT_DROP_MASK          (LAN9645_CORE_ANA_EVT_DROPPED | \
                                                 LAN9645_CORE_ANA_EVT_CLASSIFIED_DROP | \
                                                 LAN9645_CORE_ANA_EVT_VLAN_DISCARD | \
                                                 LAN9645_CORE_ANA_EVT_FWD_DISCARD | \
                                                 LAN9645_CORE_ANA_EVT_LEARN_DROP)
/** @brief Aggregate mask for warning-class ANA events. */
#define LAN9645_CORE_ANA_EVT_WARN_MASK          (LAN9645_CORE_ANA_EVT_DROP_MASK | \
                                                 LAN9645_CORE_ANA_EVT_AGED_ENTRY)

/** @brief Action flag: report one generic IRQ cause event. */
#define LAN9645_CORE_IRQ_ACTION_REPORT_CAUSE      (1u << 0)
/** @brief Action flag: report one drop-alert event. */
#define LAN9645_CORE_IRQ_ACTION_REPORT_DROP_ALERT (1u << 1)
/** @brief Action flag: acknowledge ANA events through W1C. */
#define LAN9645_CORE_IRQ_ACTION_ACK_ANA_EVENTS    (1u << 2)
/** @brief Action flag: raise error LED/escalation path for error-class events. */
#define LAN9645_CORE_IRQ_ACTION_ESCALATE_ERROR_LED (1u << 3)

/**
 * @brief Runtime context for the LAN9645 switch core.
 */
typedef struct {
  lan9645_reg_t *reg;      /**< Register access layer bound to the switch SPI transport. */
  GPIO_TypeDef *rst_port;  /**< MCU GPIO port connected to LAN_RST. */
  uint16_t rst_pin;        /**< MCU GPIO pin connected to LAN_RST. */
  uint32_t spi_clock_hz;   /**< Last SPI clock used for interface setup and padding selection. */
  uint8_t spi_if_ready;    /**< Set when IF_CFGSTAT confirms the SPI management interface is ready. */
  uint8_t initialized;     /**< Set after the core context has been initialized. */
} lan9645_core_t;

/**
 * @brief Snapshot of the interrupt-related LAN9645 registers used in bring-up.
 */
typedef struct {
  uint32_t ana_anaintr;    /**< ANA interrupt status register. */
  uint32_t ana_anevents;   /**< ANA event latch register. */
  uint32_t intr_ena;       /**< CPU interrupt enable register. */
  uint32_t intr_ident;     /**< CPU interrupt identify register 0. */
  uint32_t intr_ident1;    /**< CPU interrupt identify register 1. */
  uint32_t dev_intr_ena;   /**< Device interrupt enable snapshot for the selected port. */
  uint32_t dev_intr_ident; /**< Device interrupt identify snapshot for the selected port. */
} lan9645_core_irq_regs_t;

/**
 * @brief Snapshot of one switch-port administrative and MAC operating state.
 */
typedef struct {
  uint8_t admin_up;     /**< Set when `QSYS_SW_PORT_MODE.PORT_ENA` is asserted. */
  uint16_t speed_mbps;  /**< Decoded link speed target in Mbit/s (`10`, `100`, or `0` when unknown). */
  uint8_t full_duplex;  /**< Set when `DEV_MAC_MODE_CFG.FDX_ENA` is asserted. */
  uint8_t mac_rx_ena;   /**< Set when `DEV_MAC_ENA_CFG.RX_ENA` is asserted. */
  uint8_t mac_tx_ena;   /**< Set when `DEV_MAC_ENA_CFG.TX_ENA` is asserted. */
} lan9645_core_port_cfg_t;

/**
 * @brief Decoded IRQ-cause and action mapping derived from one IRQ register snapshot.
 */
typedef struct {
  uint32_t ana_anevents; /**< Raw ANA_ANEVENTS snapshot. */
  uint32_t intr_ident;   /**< Raw CPU_INTR_IDENT snapshot. */
  uint32_t intr_ident1;  /**< Raw CPU_INTR_IDENT1 snapshot. */
  uint32_t dev_pending;  /**< Decoded `CPU_DEV_INTR_IDENT` pending mask. */
  uint32_t drop_events;  /**< Drop-related ANA events (`LAN9645_CORE_ANA_EVT_DROP_MASK`). */
  uint32_t warn_events;  /**< Warning-related ANA events (`LAN9645_CORE_ANA_EVT_WARN_MASK`). */
  uint32_t err_events;   /**< Error-related ANA events (`LAN9645_CORE_ANA_EVT_ERR_MASK`). */
  uint32_t action_mask;  /**< Recommended action bitmask (`LAN9645_CORE_IRQ_ACTION_*`). */
  uint8_t has_cause;     /**< Set when any IRQ cause is currently latched. */
  uint8_t ack_required;  /**< Set when ANA events should be acknowledged via W1C. */
  uint8_t severity_code; /**< One of `LAN9645_CORE_IRQ_SEV_*`. */
} lan9645_core_irq_analysis_t;

/**
 * @brief Initializes the LAN9645 core helper.
 *
 * @param[out] ctx Core context to initialize.
 * @param[in] reg Register access layer already bound to the SPI bus.
 * @param[in] rst_port GPIO port connected to LAN_RST.
 * @param[in] rst_pin GPIO pin connected to LAN_RST.
 *
 * @return @ref APP_OK on success.
 */
app_status_t lan9645_core_init(
  lan9645_core_t *ctx,
  lan9645_reg_t *reg,
  GPIO_TypeDef *rst_port,
  uint16_t rst_pin
);

/**
 * @brief Pulses the external LAN9645 reset line.
 *
 * @param[in,out] ctx Core context.
 * @param[in] assert_ms Time to keep reset asserted.
 * @param[in] release_ms Time to wait after releasing reset.
 *
 * @return @ref APP_OK on success.
 */
app_status_t lan9645_core_hw_reset(lan9645_core_t *ctx, uint32_t assert_ms, uint32_t release_ms);

/**
 * @brief Programs the SPI management interface mode and padding policy.
 *
 * @param[in,out] ctx Core context.
 * @param[in] spi_clock_hz Active SPI clock used by the STM32.
 *
 * @return @ref APP_OK on success.
 */
app_status_t lan9645_core_spi_setup(lan9645_core_t *ctx, uint32_t spi_clock_hz);

/**
 * @brief Reads the current SPI management interface status from the switch.
 *
 * @param[in,out] ctx Core context.
 * @param[out] if_ctrl Optional copy of the IF_CTRL register.
 * @param[out] if_cfgstat Optional copy of the IF_CFGSTAT register.
 * @param[out] padding_bytes Optional calculated padding byte count used by the STM32 driver.
 * @param[out] spi_clock_hz Optional copy of the configured SPI frequency.
 * @param[out] spi_if_ready Optional flag that reflects interface readiness.
 *
 * @return @ref APP_OK on success.
 */
app_status_t lan9645_core_get_spi_status(
  lan9645_core_t *ctx,
  uint32_t *if_ctrl,
  uint32_t *if_cfgstat,
  uint8_t *padding_bytes,
  uint32_t *spi_clock_hz,
  uint8_t *spi_if_ready
);

/**
 * @brief Reads the LAN9645 chip identifier register.
 *
 * @param[in,out] ctx Core context.
 * @param[out] chip_id Destination for the raw chip ID register value.
 *
 * @return @ref APP_OK on success.
 */
app_status_t lan9645_core_read_chip_id(lan9645_core_t *ctx, uint32_t *chip_id);

/**
 * @brief Requests a LAN9645 soft reset and waits for completion.
 *
 * @param[in,out] ctx Core context.
 * @param[in] timeout_ms Maximum wait time in milliseconds.
 *
 * @return @ref APP_OK on success, otherwise @ref APP_ETIMEOUT or another error.
 */
app_status_t lan9645_core_soft_reset(lan9645_core_t *ctx, uint32_t timeout_ms);

/**
 * @brief Reads the feature-disable register latched by the current strap mode.
 *
 * @param[in,out] ctx Core context.
 * @param[out] feat_disable Raw feature-disable register value.
 *
 * @return @ref APP_OK on success.
 */
app_status_t lan9645_core_read_feat_disable(lan9645_core_t *ctx, uint32_t *feat_disable);

/**
 * @brief Enables or disables one switch port in the forwarding engine.
 *
 * @param[in,out] ctx Core context.
 * @param[in] port Switch port index.
 * @param[in] enable Set to 1 to enable the port, 0 to disable it.
 *
 * @return @ref APP_OK on success.
 */
app_status_t lan9645_core_set_port_enable(lan9645_core_t *ctx, uint8_t port, uint8_t enable);

/**
 * @brief Sets the administrative forwarding state of one switch port with readback verification.
 *
 * @param[in,out] ctx Core context.
 * @param[in] port Switch port index.
 * @param[in] up Set to 1 for administrative up, 0 for administrative down.
 *
 * @return @ref APP_OK on success.
 */
app_status_t lan9645_core_set_port_admin(lan9645_core_t *ctx, uint8_t port, uint8_t up);

/**
 * @brief Sets one switch-port MAC mode for 10/100 operation with readback verification.
 *
 * The function always enforces `GIGA_MODE_ENA=0` and enables both TX/RX MAC paths.
 *
 * @param[in,out] ctx Core context.
 * @param[in] port Switch port index.
 * @param[in] speed_mbps Requested speed in Mbit/s (`10` or `100`).
 * @param[in] full_duplex Set to 1 for full duplex, 0 for half duplex.
 *
 * @return @ref APP_OK on success.
 */
app_status_t lan9645_core_set_port_mode(
  lan9645_core_t *ctx,
  uint8_t port,
  uint16_t speed_mbps,
  uint8_t full_duplex
);

/**
 * @brief Reads one switch-port administrative and MAC state snapshot.
 *
 * @param[in,out] ctx Core context.
 * @param[in] port Switch port index.
 * @param[out] out Destination state snapshot.
 *
 * @return @ref APP_OK on success.
 */
app_status_t lan9645_core_get_port_cfg(lan9645_core_t *ctx, uint8_t port, lan9645_core_port_cfg_t *out);

/**
 * @brief Reads the sampled RGMII in-band link state for one external CPU interface.
 *
 * @param[in,out] ctx Core context.
 * @param[in] rgmii_idx RGMII interface index.
 * @param[out] link_up Optional link-up flag.
 * @param[out] duplex Optional duplex flag.
 * @param[out] speed_code Optional speed code extracted from the hardware status bits.
 *
 * @return @ref APP_OK on success.
 */
app_status_t lan9645_core_get_rgmii_link(
  lan9645_core_t *ctx,
  uint8_t rgmii_idx,
  uint8_t *link_up,
  uint8_t *duplex,
  uint8_t *speed_code
);

/**
 * @brief Captures the key interrupt registers used by the firmware.
 *
 * @param[in,out] ctx Core context.
 * @param[out] out Destination structure for the IRQ register snapshot.
 *
 * @return @ref APP_OK on success.
 */
app_status_t lan9645_core_get_irq_regs(lan9645_core_t *ctx, lan9645_core_irq_regs_t *out);

/**
 * @brief Acknowledges selected ANA interrupt events.
 *
 * @param[in,out] ctx Core context.
 * @param[in] ana_anevents_mask Event mask to acknowledge in ANA_ANEVENTS.
 *
 * @return @ref APP_OK on success.
 */
app_status_t lan9645_core_ack_irq(lan9645_core_t *ctx, uint32_t ana_anevents_mask);

/**
 * @brief Acknowledges ANA events and verifies that acknowledged bits are cleared.
 *
 * @param[in,out] ctx Core context.
 * @param[in] ana_anevents_mask Event mask to acknowledge.
 * @param[out] remaining_mask Optional remaining ANA event bits after acknowledge.
 *
 * @return @ref APP_OK on success.
 */
app_status_t lan9645_core_ack_irq_checked(
  lan9645_core_t *ctx,
  uint32_t ana_anevents_mask,
  uint32_t *remaining_mask
);

/**
 * @brief Decodes one IRQ register snapshot into severity and action recommendations.
 *
 * @param[in] regs IRQ register snapshot captured from hardware.
 * @param[out] out Decoded analysis.
 *
 * @return @ref APP_OK on success.
 */
app_status_t lan9645_core_eval_irq_actions(
  const lan9645_core_irq_regs_t *regs,
  lan9645_core_irq_analysis_t *out
);

#ifdef __cplusplus
}
#endif

#endif /* LAN9645_CORE_H */
