SamuelCicuitStudio/LAN9645-STM32-Managed-Ethernet-Switch/firmware/Core/Src/lan9645/lan9645_reg.c

#include "lan9645/lan9645_reg.h"

/**
 * @file lan9645_reg.c
 * @brief Register abstraction that resolves descriptor-based LAN9645 accesses.
 */

#include <string.h>

#include "diag/diag_core.h"
#include "diag/diag_router.h"
#include "main.h"

/**
 * @brief Reports one SPI transport failure into diagnostics storage and routed logs.
 *
 * @param[in] st Application status returned by the SPI transport.
 * @param[in] reg_addr Register address involved in the failed access.
 * @param[in] is_write Set to 1 for write operation, 0 for read operation.
 */
static void lan9645_reg_report_spi_failure(app_status_t st, uint32_t reg_addr, uint8_t is_write)
{
  diag_event_t evt = {0};

  if (st == APP_OK) {
    return;
  }

  /* Keep diagnostics focused on transport failures only. */
  if ((st == APP_EINVAL) || (st == APP_ESTATE) || (st == APP_ENOTSUP)) {
    return;
  }

  evt.id = (st == APP_ETIMEOUT) ? DIAG_EVT_LAN_SPI_TIMEOUT : DIAG_EVT_LAN_SPI_IFSTAT;
  evt.severity = DIAG_SEV_ERR;
  evt.dev = 0u;
  evt.reg = reg_addr;
  evt.arg0 = (uint32_t)(int32_t)st;
  evt.arg1 = (is_write != 0u) ? 1u : 0u;

  (void)diag_core_report(&evt);
  (void)diag_router_write_event(&evt);
}

/**
 * @brief Validates that the register context is ready for use.
 *
 * @param[in] ctx Register context to validate.
 *
 * @return @ref APP_OK when the context is usable.
 */
static app_status_t lan9645_reg_check_ctx(const lan9645_reg_t *ctx)
{
  if (ctx == NULL) {
    return APP_EINVAL;
  }
  if ((ctx->initialized == 0u) || (ctx->spi == NULL)) {
    return APP_ESTATE;
  }
  return APP_OK;
}

/**
 * @brief Converts a target plus instance into a flat target-base table index.
 *
 * @param[in] target Register target identifier.
 * @param[in] target_instance Target instance offset.
 * @param[out] index_out Destination flat index.
 *
 * @return @ref APP_OK on success.
 */
static app_status_t lan9645_reg_resolve_target_index(
  lan9645_target_t target,
  uint32_t target_instance,
  uint32_t *index_out
)
{
  uint32_t target_base = (uint32_t)target;
  uint32_t idx = 0u;

  if (index_out == NULL) {
    return APP_EINVAL;
  }
  if (target_base >= (uint32_t)LAN9645_TARGET_COUNT) {
    return APP_EINVAL;
  }

  idx = target_base + target_instance;
  if (idx >= (uint32_t)LAN9645_TARGET_COUNT) {
    return APP_EINVAL;
  }

  *index_out = idx;
  return APP_OK;
}

/**
 * @brief Resolves a descriptor instance into an absolute register address.
 *
 * @param[in,out] ctx Register context holding target base addresses.
 * @param[in] desc Register descriptor to resolve.
 * @param[in] target_instance Additional target instance offset.
 * @param[in] group_instance Additional group instance offset.
 * @param[in] reg_instance Additional register instance offset.
 * @param[out] abs_addr Destination absolute register address.
 *
 * @return @ref APP_OK on success.
 */
static app_status_t lan9645_reg_desc_to_addr(
  lan9645_reg_t *ctx,
  const lan9645_reg_desc_t *desc,
  uint32_t target_instance,
  uint32_t group_instance,
  uint32_t reg_instance,
  uint32_t *abs_addr
)
{
  uint32_t tinst = 0u;
  uint32_t ginst = 0u;
  uint32_t rinst = 0u;
  uint32_t target_idx = 0u;
  uint32_t rel_addr = 0u;
  app_status_t st = APP_OK;

  if ((desc == NULL) || (abs_addr == NULL)) {
    return APP_EINVAL;
  }

  tinst = (uint32_t)desc->target_instance + target_instance;
  ginst = (uint32_t)desc->group_instance + group_instance;
  rinst = (uint32_t)desc->reg_instance + reg_instance;

  if (tinst >= desc->target_count) {
    return APP_EINVAL;
  }
  if (ginst >= desc->group_count) {
    return APP_EINVAL;
  }
  if (rinst >= desc->reg_count) {
    return APP_EINVAL;
  }

  st = lan9645_reg_resolve_target_index(desc->target, tinst, &target_idx);
  if (st != APP_OK) {
    return st;
  }
  if (ctx->target_base_valid[target_idx] == 0u) {
    return APP_ESTATE;
  }

  rel_addr = lan9645_reg_desc_rel_addr(desc, group_instance, reg_instance);
  *abs_addr = ctx->target_base[target_idx] + rel_addr;
  return APP_OK;
}

/**
 * @brief Initializes the register context.
 *
 * @param[out] ctx Register context to initialize.
 * @param[in] spi SPI transport used for raw register IO.
 *
 * @return @ref APP_OK on success.
 */
app_status_t lan9645_reg_init(lan9645_reg_t *ctx, lan9645_spi_t *spi)
{
  if ((ctx == NULL) || (spi == NULL)) {
    return APP_EINVAL;
  }

  memset(ctx, 0, sizeof(*ctx));
  ctx->spi = spi;
  ctx->initialized = 1u;
  return APP_OK;
}

/**
 * @brief Installs one target base address.
 *
 * @param[in,out] ctx Register context.
 * @param[in] target Register target identifier.
 * @param[in] target_instance Target instance index.
 * @param[in] base_addr Absolute target base address.
 *
 * @return @ref APP_OK on success.
 */
app_status_t lan9645_reg_set_target_base(
  lan9645_reg_t *ctx,
  lan9645_target_t target,
  uint8_t target_instance,
  uint32_t base_addr
)
{
  uint32_t target_idx = 0u;
  app_status_t st = APP_OK;

  st = lan9645_reg_check_ctx(ctx);
  if (st != APP_OK) {
    return st;
  }

  st = lan9645_reg_resolve_target_index(target, (uint32_t)target_instance, &target_idx);
  if (st != APP_OK) {
    return st;
  }

  ctx->target_base[target_idx] = base_addr;
  ctx->target_base_valid[target_idx] = 1u;
  return APP_OK;
}

/**
 * @brief Clears one target base address entry.
 *
 * @param[in,out] ctx Register context.
 * @param[in] target Register target identifier.
 * @param[in] target_instance Target instance index.
 *
 * @return @ref APP_OK on success.
 */
app_status_t lan9645_reg_clear_target_base(
  lan9645_reg_t *ctx,
  lan9645_target_t target,
  uint8_t target_instance
)
{
  uint32_t target_idx = 0u;
  app_status_t st = APP_OK;

  st = lan9645_reg_check_ctx(ctx);
  if (st != APP_OK) {
    return st;
  }

  st = lan9645_reg_resolve_target_index(target, (uint32_t)target_instance, &target_idx);
  if (st != APP_OK) {
    return st;
  }

  ctx->target_base[target_idx] = 0u;
  ctx->target_base_valid[target_idx] = 0u;
  return APP_OK;
}

/**
 * @brief Returns one installed target base address.
 *
 * @param[in,out] ctx Register context.
 * @param[in] target Register target identifier.
 * @param[in] target_instance Target instance index.
 * @param[out] base_addr Destination base address.
 *
 * @return @ref APP_OK on success.
 */
app_status_t lan9645_reg_get_target_base(
  lan9645_reg_t *ctx,
  lan9645_target_t target,
  uint8_t target_instance,
  uint32_t *base_addr
)
{
  uint32_t target_idx = 0u;
  app_status_t st = APP_OK;

  if (base_addr == NULL) {
    return APP_EINVAL;
  }

  st = lan9645_reg_check_ctx(ctx);
  if (st != APP_OK) {
    return st;
  }

  st = lan9645_reg_resolve_target_index(target, (uint32_t)target_instance, &target_idx);
  if (st != APP_OK) {
    return st;
  }
  if (ctx->target_base_valid[target_idx] == 0u) {
    return APP_ESTATE;
  }

  *base_addr = ctx->target_base[target_idx];
  return APP_OK;
}

/**
 * @brief Reads one absolute 32-bit register.
 *
 * @param[in,out] ctx Register context.
 * @param[in] reg_addr Absolute register address.
 * @param[out] value Destination register value.
 *
 * @return @ref APP_OK on success.
 */
app_status_t lan9645_reg_read32(lan9645_reg_t *ctx, uint32_t reg_addr, uint32_t *value)
{
  app_status_t st = APP_OK;

  if (value == NULL) {
    return APP_EINVAL;
  }

  st = lan9645_reg_check_ctx(ctx);
  if (st != APP_OK) {
    return st;
  }

  st = lan9645_spi_read32(ctx->spi, reg_addr, value);
  if (st != APP_OK) {
    lan9645_reg_report_spi_failure(st, reg_addr, 0u);
  }
  return st;
}

/**
 * @brief Writes one absolute 32-bit register.
 *
 * @param[in,out] ctx Register context.
 * @param[in] reg_addr Absolute register address.
 * @param[in] value Register value to write.
 *
 * @return @ref APP_OK on success.
 */
app_status_t lan9645_reg_write32(lan9645_reg_t *ctx, uint32_t reg_addr, uint32_t value)
{
  app_status_t st = lan9645_reg_check_ctx(ctx);
  if (st != APP_OK) {
    return st;
  }

  st = lan9645_spi_write32(ctx->spi, reg_addr, value);
  if (st != APP_OK) {
    lan9645_reg_report_spi_failure(st, reg_addr, 1u);
  }
  return st;
}

/**
 * @brief Performs a read-modify-write on one absolute register.
 *
 * @param[in,out] ctx Register context.
 * @param[in] reg_addr Absolute register address.
 * @param[in] mask Field mask to update.
 * @param[in] value New masked value.
 *
 * @return @ref APP_OK on success.
 */
app_status_t lan9645_reg_rmw32(lan9645_reg_t *ctx, uint32_t reg_addr, uint32_t mask, uint32_t value)
{
  uint32_t reg_val = 0u;
  app_status_t st = APP_OK;

  st = lan9645_reg_read32(ctx, reg_addr, &reg_val);
  if (st != APP_OK) {
    return st;
  }

  reg_val = (reg_val & ~mask) | (value & mask);
  return lan9645_reg_write32(ctx, reg_addr, reg_val);
}

/**
 * @brief Polls one absolute register field until it matches the expected value.
 *
 * @param[in,out] ctx Register context.
 * @param[in] reg_addr Absolute register address.
 * @param[in] mask Field mask to compare.
 * @param[in] expected Expected masked value.
 * @param[in] timeout_ms Poll timeout in milliseconds.
 * @param[out] last_read Optional last-read register snapshot.
 *
 * @return @ref APP_OK on success.
 */
app_status_t lan9645_reg_wait_field(
  lan9645_reg_t *ctx,
  uint32_t reg_addr,
  uint32_t mask,
  uint32_t expected,
  uint32_t timeout_ms,
  uint32_t *last_read
)
{
  uint32_t start_ms = 0u;
  uint32_t now_ms = 0u;
  uint32_t val = 0u;
  app_status_t st = APP_OK;

  if (timeout_ms == 0u) {
    return APP_EINVAL;
  }

  start_ms = HAL_GetTick();
  now_ms = start_ms;

  while ((now_ms - start_ms) <= timeout_ms) {
    st = lan9645_reg_read32(ctx, reg_addr, &val);
    if (st != APP_OK) {
      return st;
    }

    if ((val & mask) == (expected & mask)) {
      if (last_read != NULL) {
        *last_read = val;
      }
      return APP_OK;
    }

    HAL_Delay(1u);
    now_ms = HAL_GetTick();
  }

  if (last_read != NULL) {
    *last_read = val;
  }

  return APP_ETIMEOUT;
}

/**
 * @brief Reads one descriptor-based register instance.
 *
 * @param[in,out] ctx Register context.
 * @param[in] desc Register descriptor.
 * @param[in] target_instance Additional target offset.
 * @param[in] group_instance Additional group offset.
 * @param[in] reg_instance Additional register offset.
 * @param[out] value Destination register value.
 *
 * @return @ref APP_OK on success.
 */
app_status_t lan9645_reg_read32_desc(
  lan9645_reg_t *ctx,
  const lan9645_reg_desc_t *desc,
  uint32_t target_instance,
  uint32_t group_instance,
  uint32_t reg_instance,
  uint32_t *value
)
{
  uint32_t abs_addr = 0u;
  app_status_t st = APP_OK;

  if (value == NULL) {
    return APP_EINVAL;
  }

  st = lan9645_reg_check_ctx(ctx);
  if (st != APP_OK) {
    return st;
  }

  st = lan9645_reg_desc_to_addr(ctx, desc, target_instance, group_instance, reg_instance, &abs_addr);
  if (st != APP_OK) {
    return st;
  }

  return lan9645_reg_read32(ctx, abs_addr, value);
}

/**
 * @brief Writes one descriptor-based register instance.
 *
 * @param[in,out] ctx Register context.
 * @param[in] desc Register descriptor.
 * @param[in] target_instance Additional target offset.
 * @param[in] group_instance Additional group offset.
 * @param[in] reg_instance Additional register offset.
 * @param[in] value Register value to write.
 *
 * @return @ref APP_OK on success.
 */
app_status_t lan9645_reg_write32_desc(
  lan9645_reg_t *ctx,
  const lan9645_reg_desc_t *desc,
  uint32_t target_instance,
  uint32_t group_instance,
  uint32_t reg_instance,
  uint32_t value
)
{
  uint32_t abs_addr = 0u;
  app_status_t st = APP_OK;

  st = lan9645_reg_check_ctx(ctx);
  if (st != APP_OK) {
    return st;
  }

  st = lan9645_reg_desc_to_addr(ctx, desc, target_instance, group_instance, reg_instance, &abs_addr);
  if (st != APP_OK) {
    return st;
  }

  return lan9645_reg_write32(ctx, abs_addr, value);
}

/**
 * @brief Performs a descriptor-based read-modify-write.
 *
 * @param[in,out] ctx Register context.
 * @param[in] desc Register descriptor.
 * @param[in] target_instance Additional target offset.
 * @param[in] group_instance Additional group offset.
 * @param[in] reg_instance Additional register offset.
 * @param[in] mask Field mask to update.
 * @param[in] value New masked value.
 *
 * @return @ref APP_OK on success.
 */
app_status_t lan9645_reg_rmw32_desc(
  lan9645_reg_t *ctx,
  const lan9645_reg_desc_t *desc,
  uint32_t target_instance,
  uint32_t group_instance,
  uint32_t reg_instance,
  uint32_t mask,
  uint32_t value
)
{
  uint32_t abs_addr = 0u;
  app_status_t st = APP_OK;

  st = lan9645_reg_check_ctx(ctx);
  if (st != APP_OK) {
    return st;
  }

  st = lan9645_reg_desc_to_addr(ctx, desc, target_instance, group_instance, reg_instance, &abs_addr);
  if (st != APP_OK) {
    return st;
  }

  return lan9645_reg_rmw32(ctx, abs_addr, mask, value);
}

/**
 * @brief Polls a descriptor-based register field until it matches the expected value.
 *
 * @param[in,out] ctx Register context.
 * @param[in] desc Register descriptor.
 * @param[in] target_instance Additional target offset.
 * @param[in] group_instance Additional group offset.
 * @param[in] reg_instance Additional register offset.
 * @param[in] mask Field mask to compare.
 * @param[in] expected Expected masked value.
 * @param[in] timeout_ms Poll timeout in milliseconds.
 * @param[out] last_read Optional last-read register snapshot.
 *
 * @return @ref APP_OK on success.
 */
app_status_t lan9645_reg_wait32_desc(
  lan9645_reg_t *ctx,
  const lan9645_reg_desc_t *desc,
  uint32_t target_instance,
  uint32_t group_instance,
  uint32_t reg_instance,
  uint32_t mask,
  uint32_t expected,
  uint32_t timeout_ms,
  uint32_t *last_read
)
{
  uint32_t abs_addr = 0u;
  app_status_t st = APP_OK;

  st = lan9645_reg_check_ctx(ctx);
  if (st != APP_OK) {
    return st;
  }

  st = lan9645_reg_desc_to_addr(ctx, desc, target_instance, group_instance, reg_instance, &abs_addr);
  if (st != APP_OK) {
    return st;
  }

  return lan9645_reg_wait_field(ctx, abs_addr, mask, expected, timeout_ms, last_read);
}
