SamuelCicuitStudio/LAN9645-STM32-Managed-Ethernet-Switch/(commit log)

2026-04-04 Initial project import with LAN9645 pin assignment docs
    [EthernetSwitch.kicad_pcb, EthernetSwitch.kicad_sch, ProDoc_EthernetSwitch_2026-02-25.epro, bom.csv, mcu.kicad_sch, positions.csv, switch.kicad_sch]
2026-04-04 Update LAN9645 strap plan for external 125MHz SerDes clock control
2026-04-04 Refine LAN9645 managed RMII strap plan and full bootstrap classification
2026-04-04 Clarify managed-mode bootstrap usage and pin states
2026-04-04 Add LAN9645 design docs and STM32H743 LwIP firmware base
    [EthernetSwitch.kicad_sch]
2026-04-04 Reorganize reference PDFs and add KiCad backup artifacts
2026-04-04 Clarify CLI error routing and debug serial ownership
    [ethernetSwitch.ioc]
2026-04-04 docs: lock LAN9645 comm error routing to USB/UART debug line
2026-04-04 docs+fw: add generated bring-up checklist and sync current config
2026-04-05 Import LAN9645x BSP sources and update SPI findings
2026-04-05 docs: complete LAN9645 STM32 BSP sequencing guides
2026-04-05 Add SPI transport telemetry and CLI stats commands
2026-04-05 Close F1 with SPI error diagnostics and status-all telemetry
    [cli_core.c, lan9645_reg.c]
2026-04-05 Implement F5 IRQ cause-action contract and checked ACK flow
2026-04-05 Finalize F7 traceability matrix and hardware backlog closure
2026-04-05 Remove Design/firmware/lan9645x reference driver folder
2026-04-05 Document project handbook and expand LAN9645 firmware baseline
    [EthernetSwitch.kicad_pcb, EthernetSwitch.kicad_sch, ProDoc_EthernetSwitch_2026-02-25.epro, bom.csv, mcu.kicad_sch, positions.csv, switch.kicad_sch]
